ZhuHengg/ChampionCHIP-Multicycle-Processor-Architecture/Stage 3 ChampionCHIP eXperience_compressed.pdf

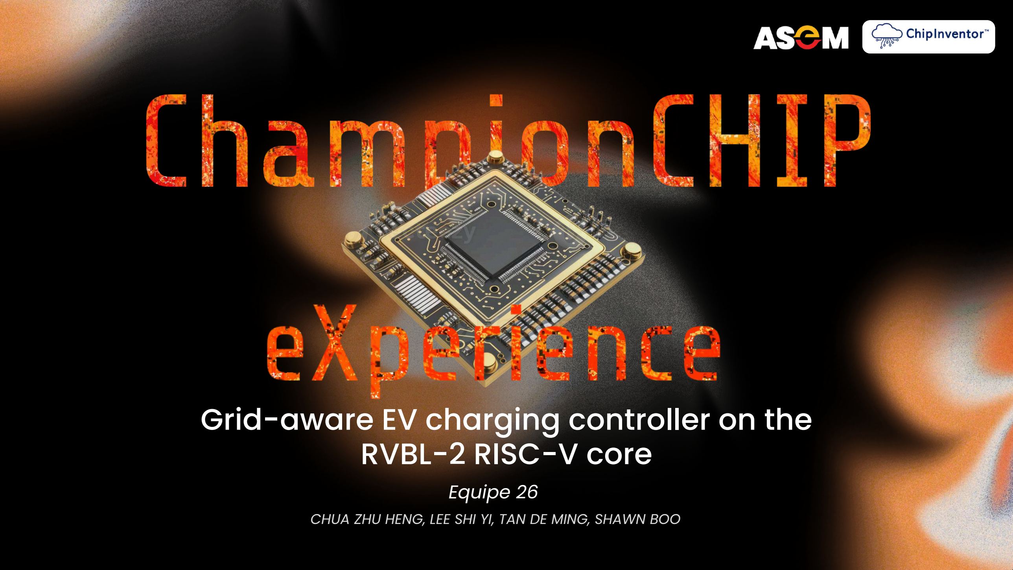
[picture p1: page 1]

# Grid-aware EV charging controller on the RVBL-2 RISC-V core

# Equipe 26

## CHUA ZHU HENG, LEE SHI YI, TAN DE MING, SHAWN BOO

# PROJECT ARCHITECTURE

# 01 · Technical

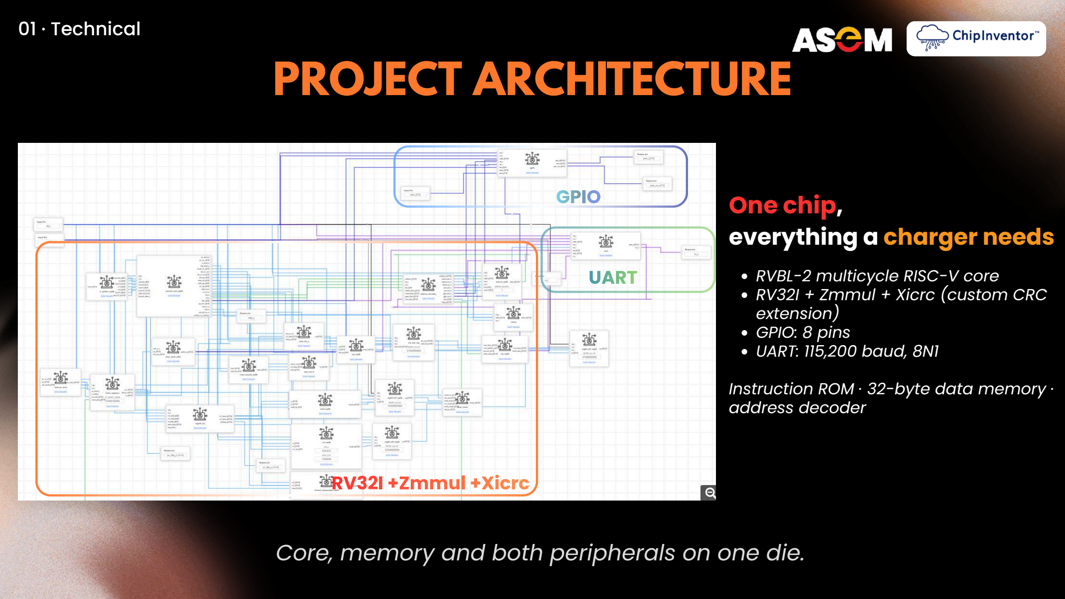
[picture p2: page 2]

## RVBL-2 multicycle RISC-V core RV32I + Zmmul + Xicrc (custom CRC extension) GPIO: 8 pins UART: 115,200 baud, 8N1

## Instruction ROM · 32-byte data memory · address decoder

Core, memory and both peripherals on one die.

One chip,

# everything a charger needs

# GPIO

# UART

# RV32I +Zmmul +Xicrc

# PROJECT ARCHITECTURE

# 01 · Technical

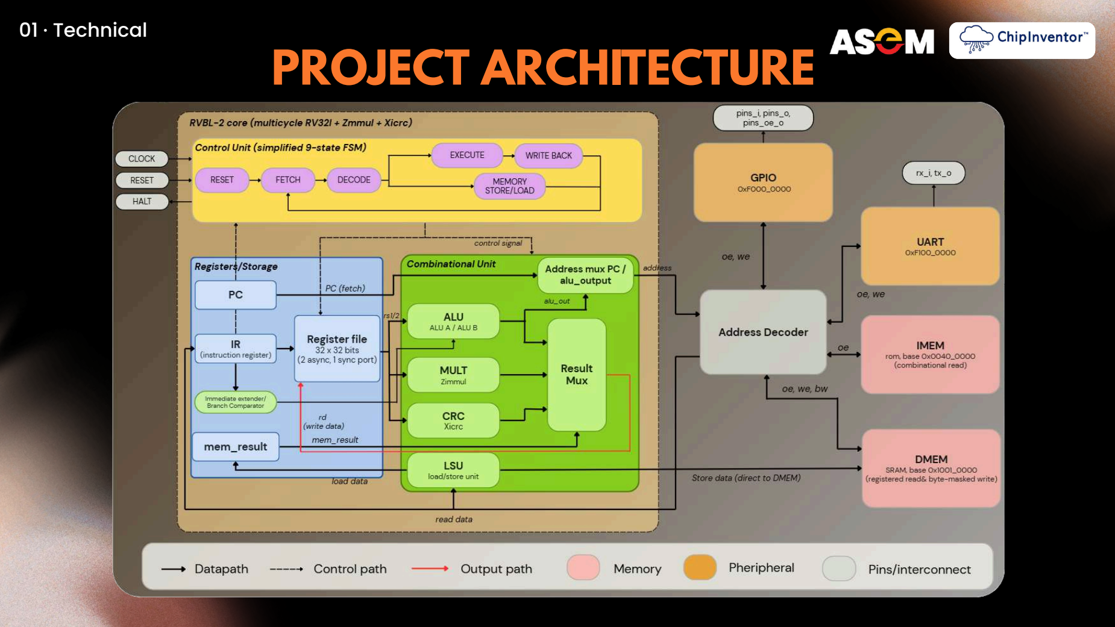
[picture p3: page 3]

# ASEM

## Our chip

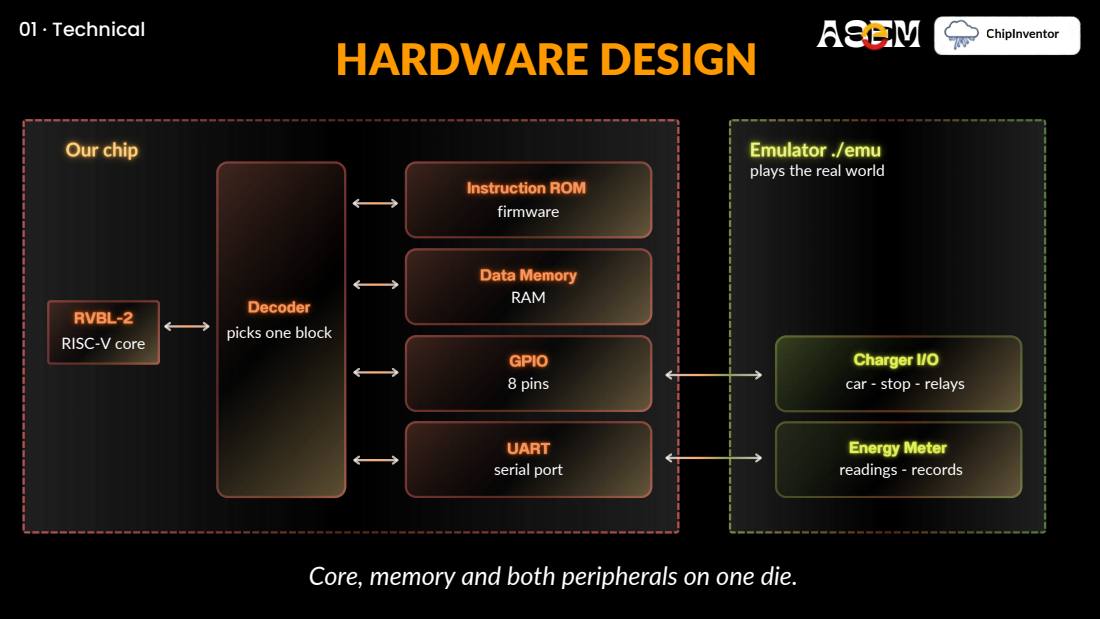
[picture p4: page 4]
RVBL-2; RISC-V core; HARDWARE DESIGN; ChipInventor; Instruction ROM; Data Memory; GPIO; UART; firmware; RAM; 8 pins; serial port; Energy Meter readings - records; 01 · Technical

Emulator ./emu
plays the real world

Decoder
picks one block

Charger I/O
car - stop - relays

Core, memory and both peripherals on one die.

# FIRMWARE IMPLEMENTATION

# 01 · Technical

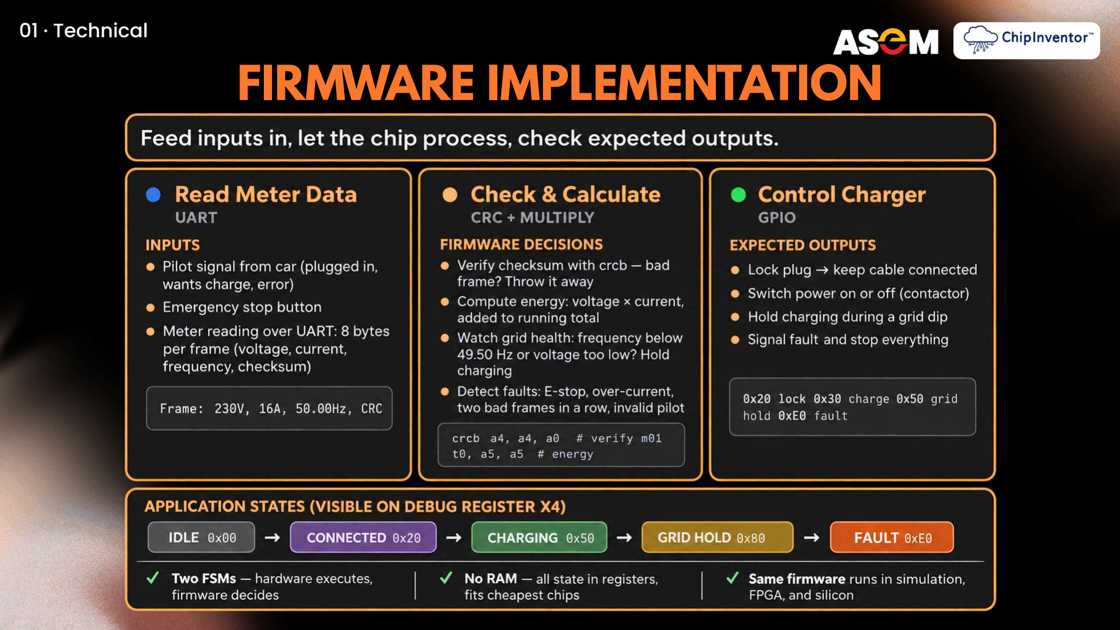
[picture p5: page 5]

# OFFICIAL FIRMWARE TESTBENCH

# 01 · Technical

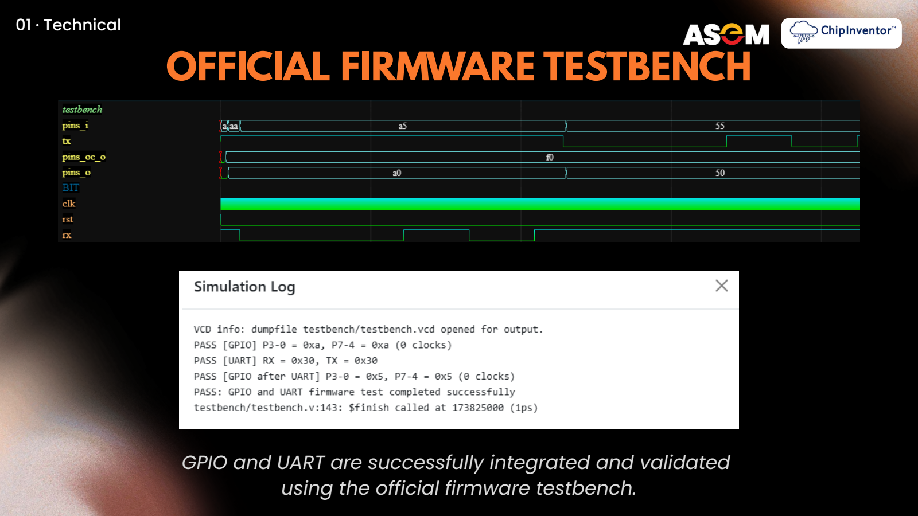
[picture p6: page 6]

# GPIO and UART are successfully integrated and validated

using the official firmware testbench.

# PROBLEM STATEMENT

1.Dip | 2.Recover | 3.Rebound

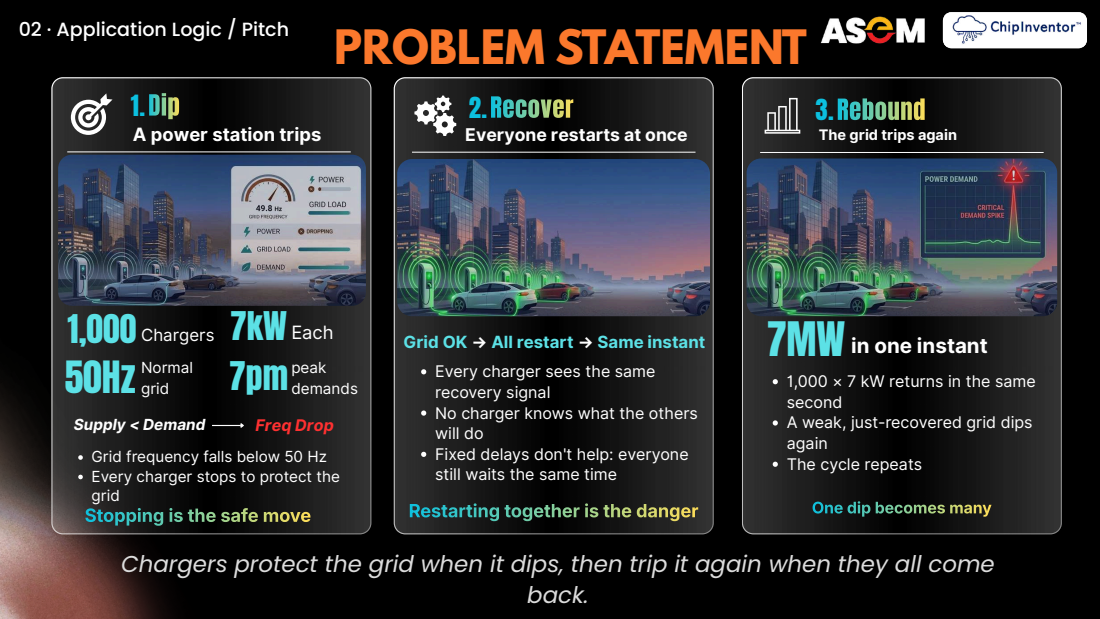
[picture p7: page 7]
Chargers; Everyone restarts at once; The grid trips again; 7kWEach; Normal; grid; peak demands; Stopping is the safe move; Restarting together is the danger; One dip becomes many; Freq Drop; back.

02 · Application Logic / Pitch

A power station trips

Grid OK → All restart → Same instant
Every charger sees the same
recovery signal
No charger knows what the others
will do
Fixed delays don't help: everyone
still waits the same time

in one instant

1,000 × 7 kW returns in the same
second
A weak, just-recovered grid dips
again
The cycle repeats

Supply < Demand
Grid frequency falls below 50 Hz
Every charger stops to protect the
grid
Chargers protect the grid when it dips, then trip it again when they all come

Every meter reading is CRC-checked and chained to the one before it. Corrupted, dropped and replayed readings are never billed.

Our custom instruction crcb checks each reading, chains readings together, and computes the restart delay. 21× faster than doing CRC in software.

## One instruction, three jobs

Each charger restarts at its own moment, computed from its ID and the grid event. Different chargers get different delays, so 1000 restart spread across 8 time slots instead of one instant.

## Staggered restart

The delay is calculated on the chip, from data every charger already has. It keeps working when communications fail, which is often during the same grid event.

## No network, no clock, no random numbers

# PROPOSED SOLUTION

## Integrity-checked metering

# Gripple

RVBL-2 RISC-V core + custom crcb instruction

# 02 · Application Logic / Pitch

# CUSTOM INSTRUCTION (crcb)

## Cycles to CRC one meter frame

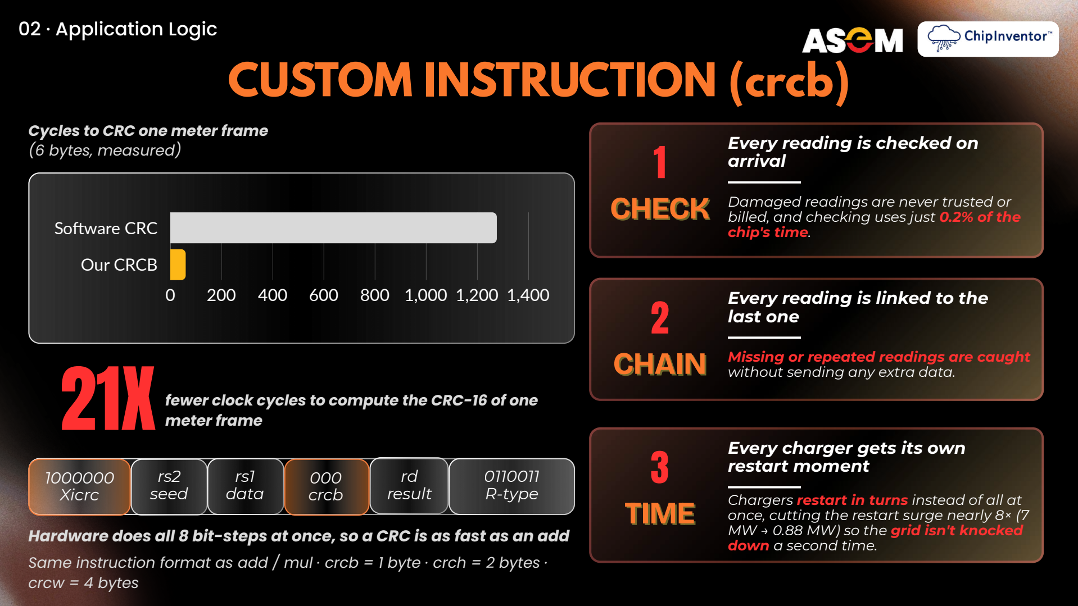
[picture p8: page 9]

0 200 400 600 800 1,000 1,200 1,400

## Software CRC

## Our CRCB

## (6 bytes, measured)

21X

## fewer clock cycles to compute the CRC-16 of one meter frame

Damaged readings are never trusted or billed, and checking uses just 0.2% of the chip's time.

# CHECK

1

## Every reading is checked on arrival

Missing or repeated readings are caught CHAIN without sending any extra data.

2

## Every reading is linked to the last one

Chargers restart in turns instead of all at once, cutting the restart surge nearly 8× (7 MW → 0.88 MW) so the grid isn't knocked down a second time.

# TIME

3

## Every charger gets its own restart moment

1000000

## Xicrc

rs2

## seed

rs1

## data

000

## crcb

rd

## result

0110011

## R-type

## Hardware does all 8 bit-steps at once, so a CRC is as fast as an add

## Same instruction format as add / mul · crcb = 1 byte · crch = 2 bytes · crcw = 4 bytes

# 02 · Application Logic

# How our chip controls a public AC EV charging station

# SYSTEM OVERVIEW

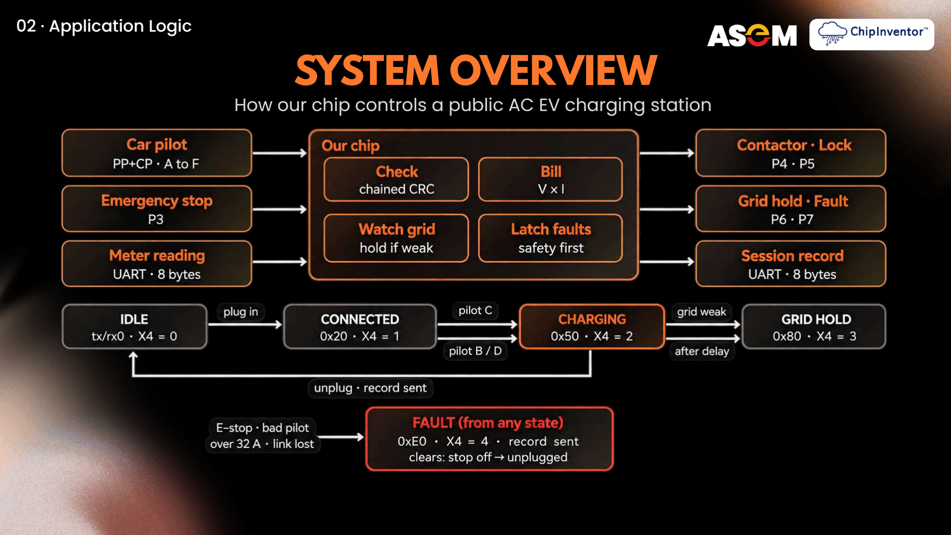
[picture p9: page 10]

# 02 · Application Logic

# APPLICATION LOGIC

# 02 · Application Logic

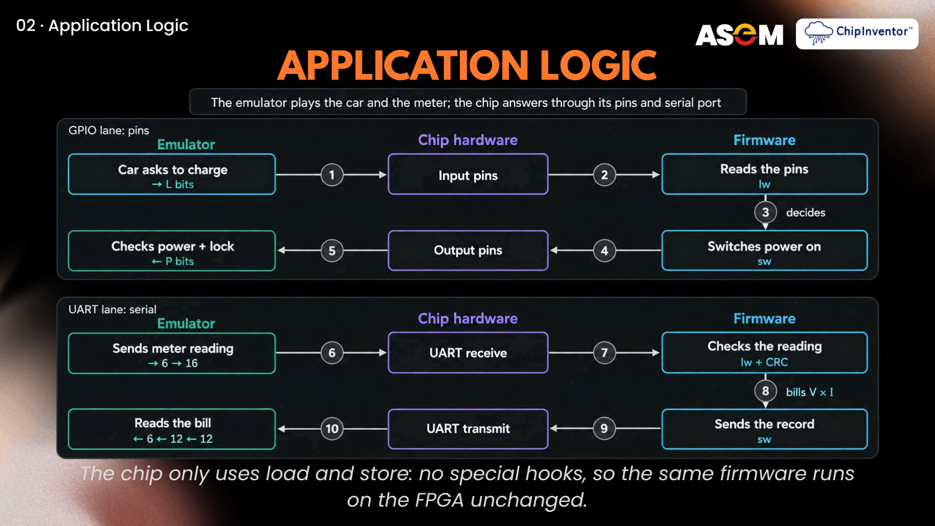
[picture p10: page 11]

# The chip only uses load and store: no special hooks, so the same firmware runs

on the FPGA unchanged.

E

M

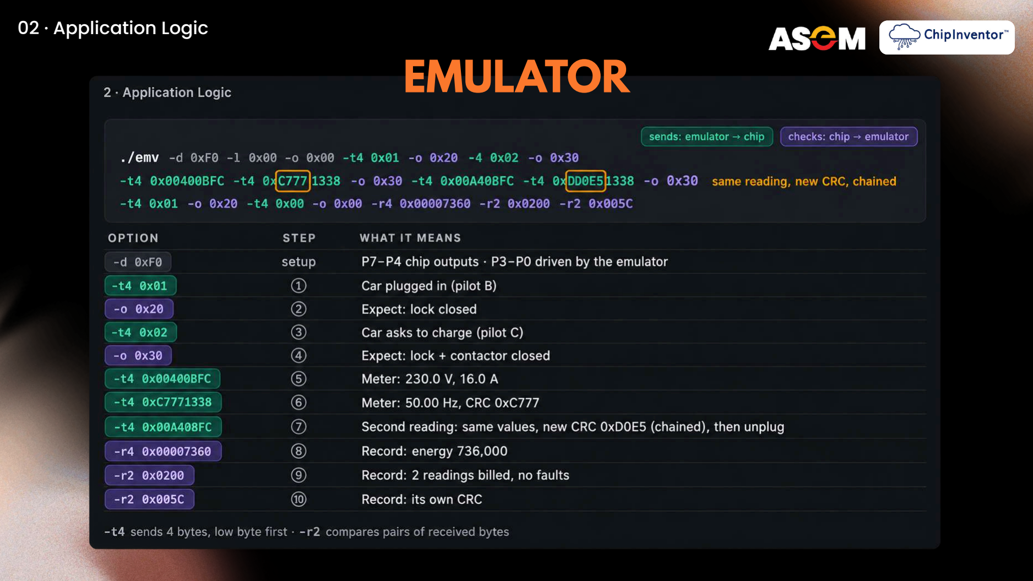
[picture p11: page 12]

U

L

# ATO

R

0

2

·

A

p

# pli

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
# DEMO 1: NORMAL CHARGING SESSION

# 02 · Application Logic

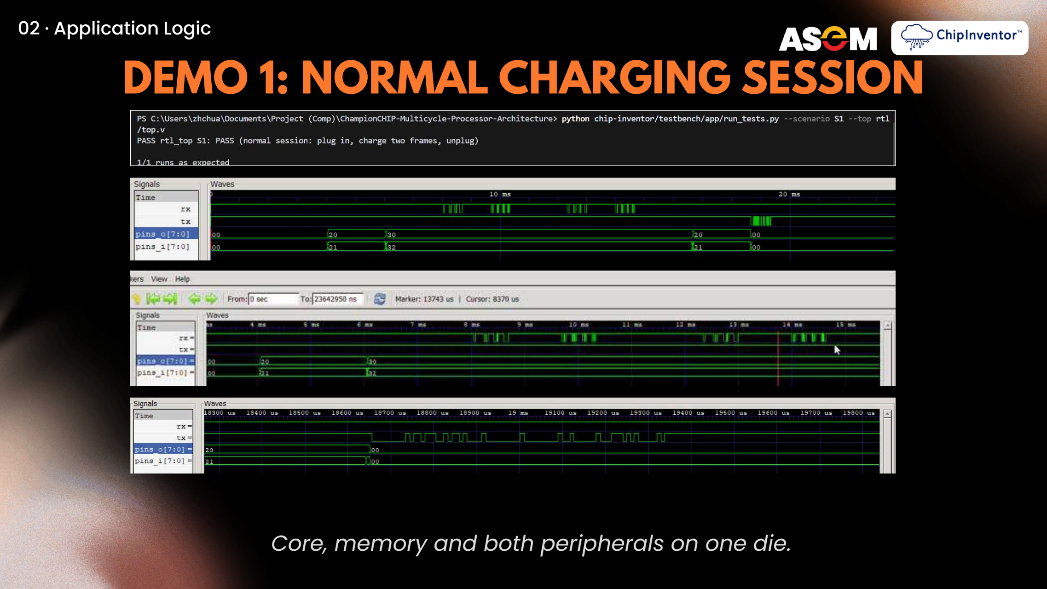
[picture p12: page 13]

Core, memory and both peripherals on one die.

# DEMO 2: GRID DIP & STAGGERED RESTART

# 02 · Application Logic

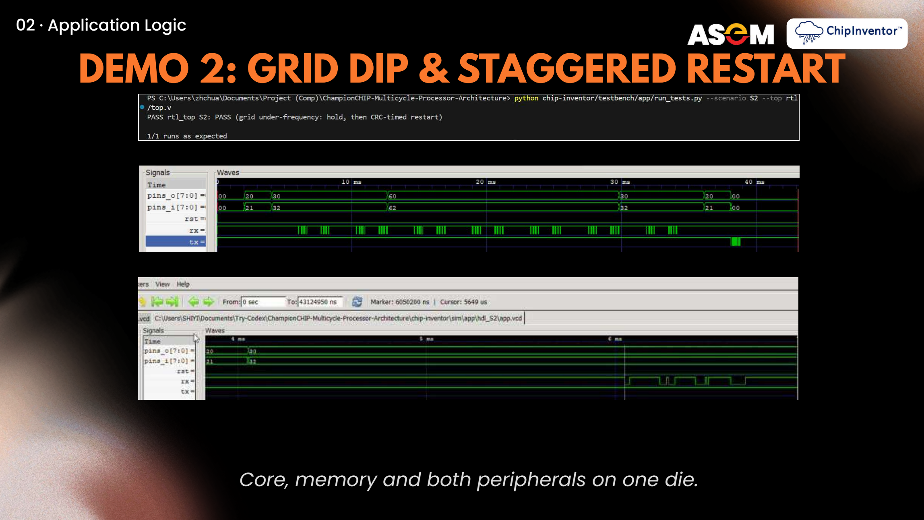
[picture p13: page 14]

Core, memory and both peripherals on one die.

# VALIDATION: APPLICATION TESTBENCH

45/45

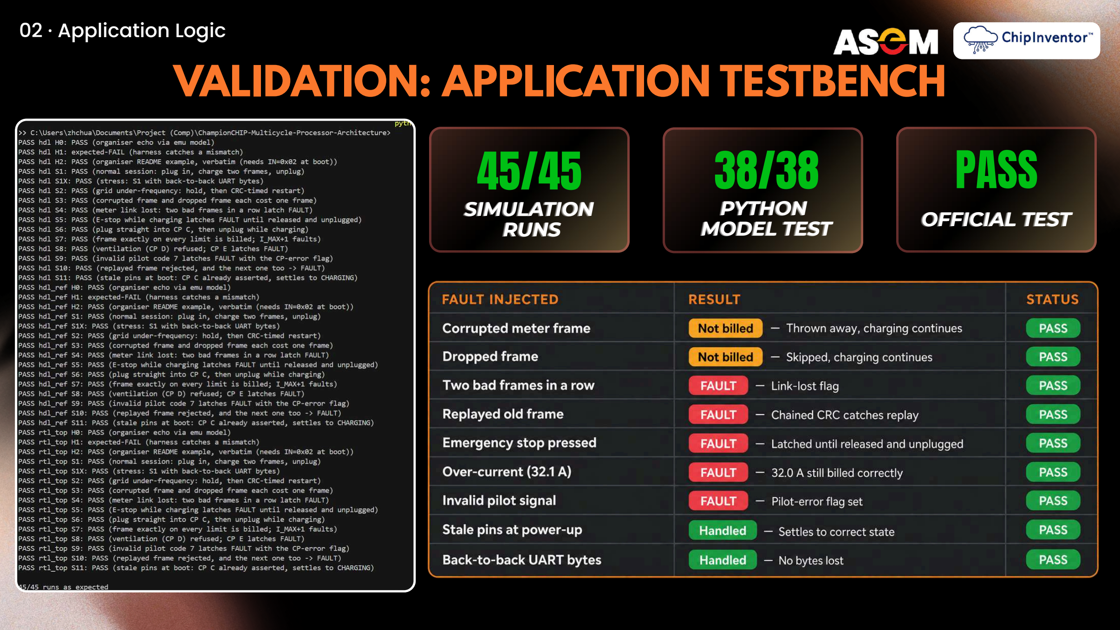
[picture p14: page 15]

## SSIIMMUULLAATTIIOONN RUNS

## SIMULATION RUNS

# PASS

## OFFICIAL TEST

## PYTHON MODEL TEST

## PYTHON MODEL TEST

38/38

# 02 · Application Logic

# COMPETITIVE ANALYSIS

# 03 · Pitch

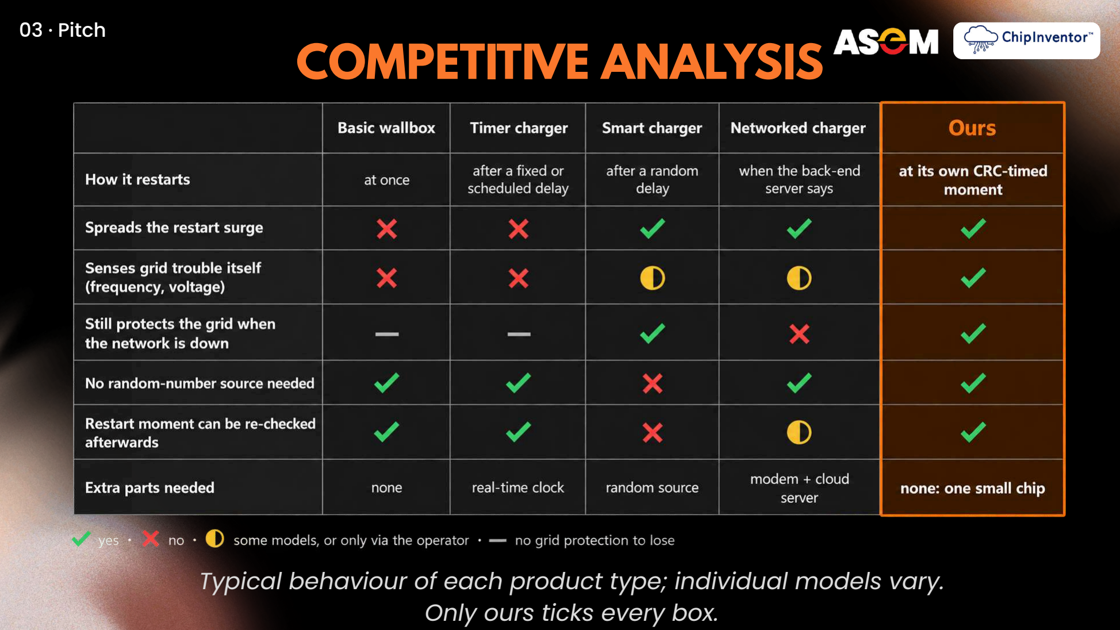
[picture p15: page 16]

Typical behaviour of each product type; individual models vary. Only ours ticks every box.

## smaller power

## 8x surges

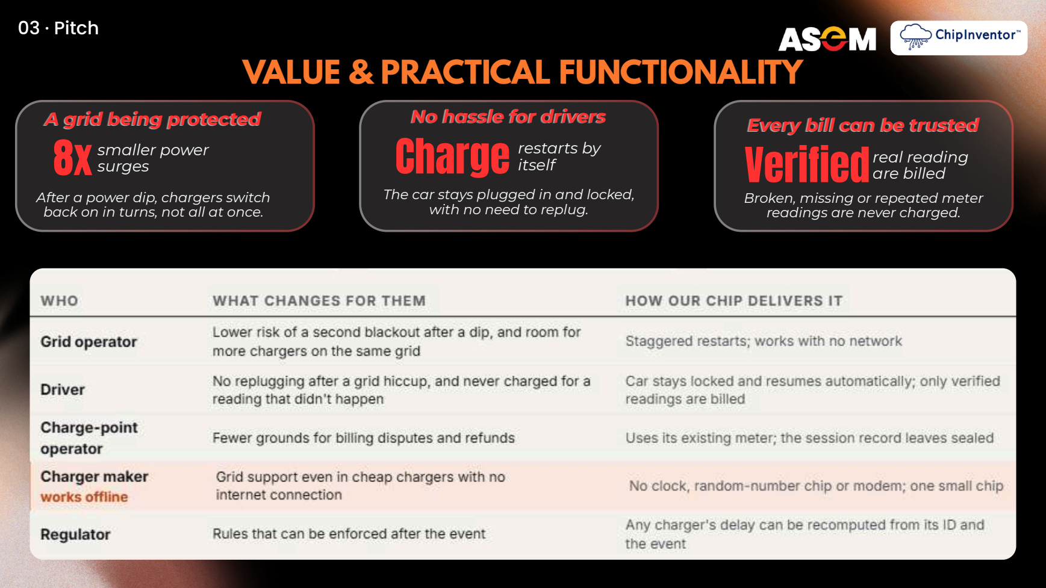
[picture p16: page 17]

## A grid being protected

After a power dip, chargers switch back on in turns, not all at once.

## restarts by

# Charge itself

## No hassle for drivers

The car stays plugged in and locked, with no need to replug.

## real reading

## Verified are billed

## Every bill can be trusted

Broken, missing or repeated meter readings are never charged.

# VALUE & PRACTICAL FUNCTIONALITY

# 03 · Pitch

# STAGE 4 FPGA ROADMAP

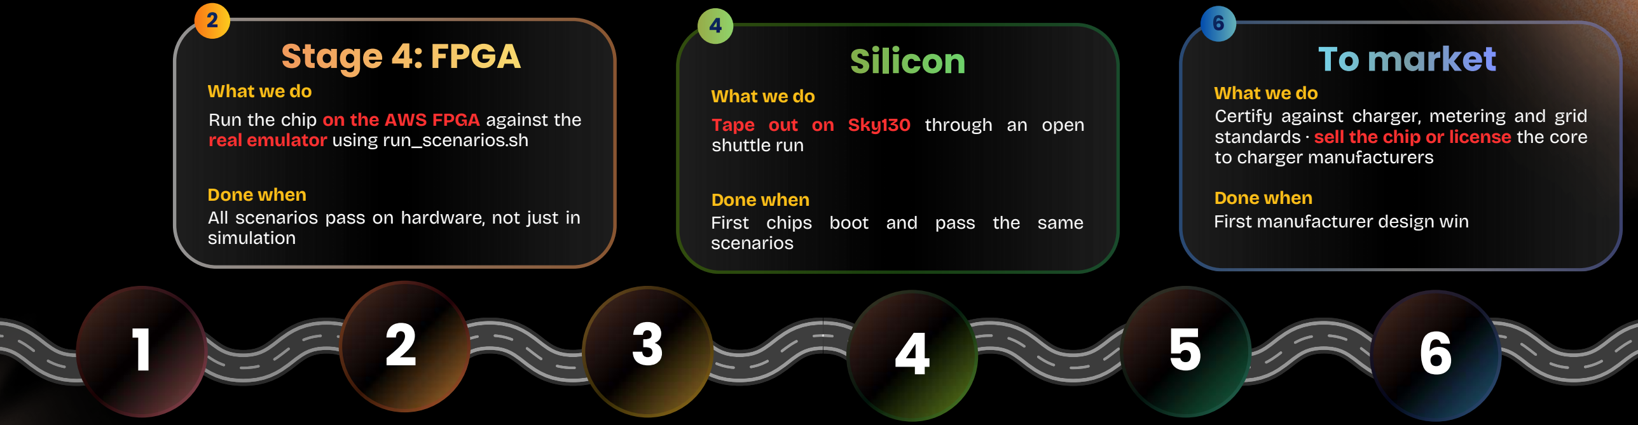
[picture p17: figure]
Stage 4: FPGA; What we do; real emulator using run_scenarios.sh; Done when; simulation; Silicon; What we do Tape out on Sky130 through an open shuttle run; Done when First chips boot and pass the same scenarios; To market; to charger manufacturers; Done when First manufacturer design win
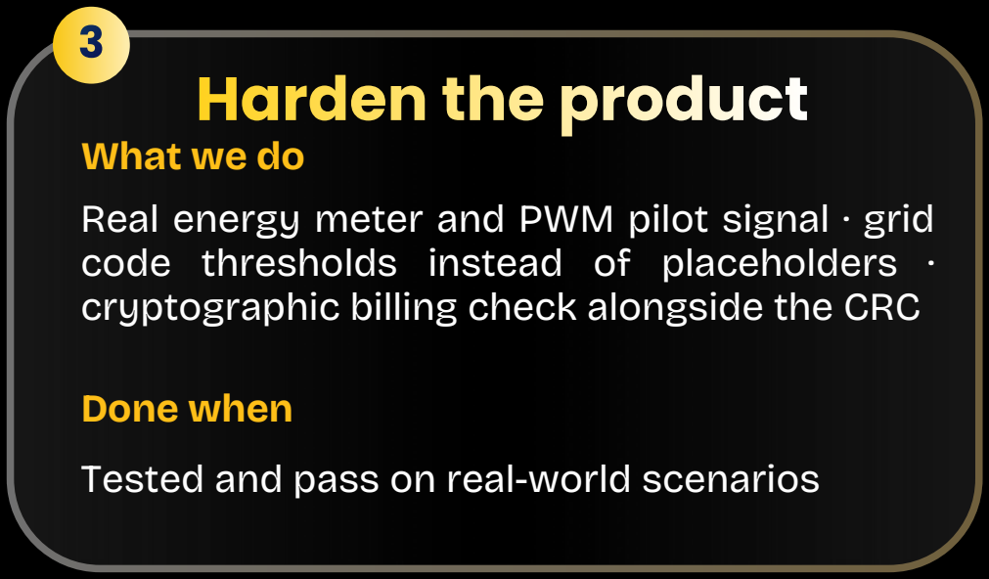
[picture p18: figure]
Harden the product; What we do; Done when Tested and pass on real-world scenarios
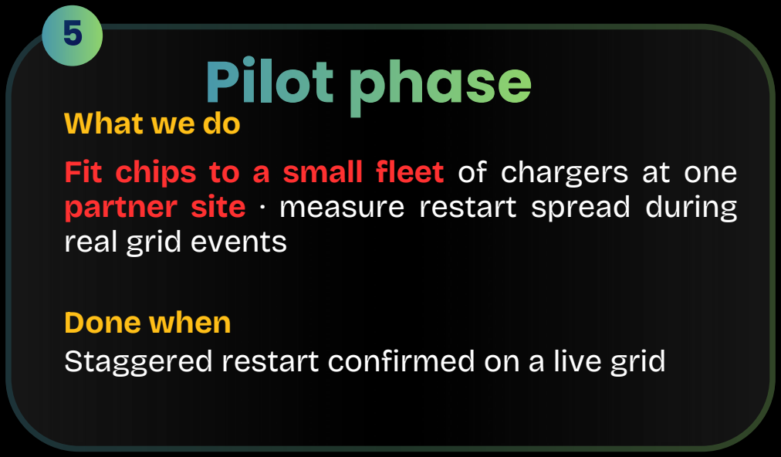
[picture p19: figure]
Pilot phase; What we do; real grid events; Done when

Core, memory and both peripherals on one die.

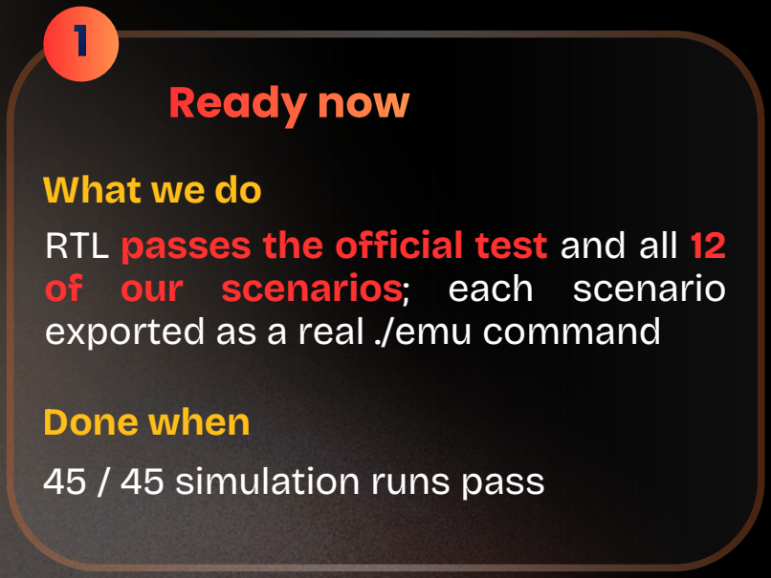
[picture p20: figure]
Ready now; What we do; RTL passes the official test and all 12 of our scenarios; each scenario exported as a real ./emu command; Done when 45 / 45 simulation runs pass

Real energy meter and PWM pilot signal · grid code thresholds instead of placeholders · cryptographic billing check alongside the CRC

Run the chip on the AWS FPGA against the

All scenarios pass on hardware, not just in

Fit chips to a small fleet of chargers at one partner site · measure restart spread during

Staggered restart confirmed on a live grid

Certify against charger, metering and grid standards · sell the chip or license the core

# 03 · Pitch

# Equipe 26

One CRC instruction.

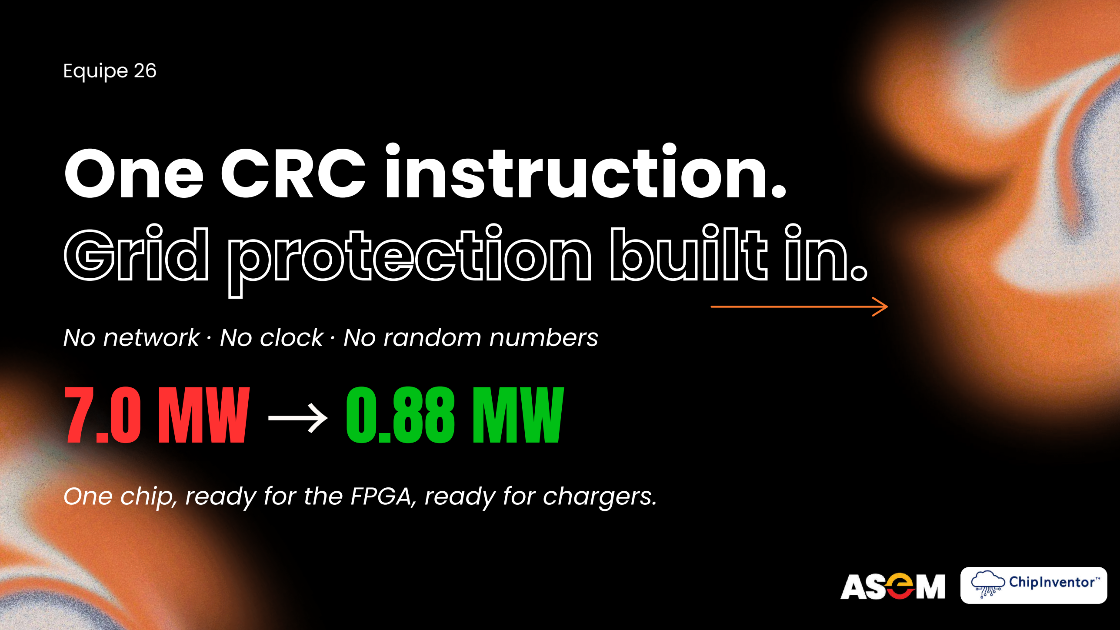
[picture p21: page 19]

# No network · No clock · No random numbers

Grid protection built in.

# 7.0 MW → 0.88 MW

One chip, ready for the FPGA, ready for chargers.
