ZhuHengg/ChampionCHIP-Multicycle-Processor-Architecture/chip-inventor/frontend/design-system/championchip-ev-charger/MASTER.md

# Design System Master File

> **LOGIC:** When building a specific page, first check `design-system/pages/[page-name].md`.
> If that file exists, its rules **override** this Master file.
> If not, strictly follow the rules below.

---

**Project:** ChampionCHIP EV Charger
**Generated:** 2026-10-07 09:20:07
**Category:** Smart Home/IoT Dashboard
**Design Dials:** Variance 7/10 (Balanced / Modern) | Motion 7/10 (Standard) | Density 7/10 (Standard)

---

## Global Rules

### Color Palette

| Role | Hex | CSS Variable |
|---|-----|---|
| Primary | `#1E293B` | `--color-primary` |
| On Primary | `#FFFFFF` | `--color-on-primary` |
| Secondary | `#334155` | `--color-secondary` |
| On Secondary | `#FFFFFF` | `--color-on-secondary` |
| Accent/CTA | `#22C55E` | `--color-accent` |
| On Accent/CTA | `#0F172A` | `--color-on-accent` |
| Background | `#0F172A` | `--color-background` |
| Foreground | `#F8FAFC` | `--color-foreground` |
| Card | `#1B2336` | `--color-card` |
| Card Foreground | `#F8FAFC` | `--color-card-foreground` |
| Muted | `#272F42` | `--color-muted` |
| Muted Foreground | `#94A3B8` | `--color-muted-foreground` |
| Border | `#475569` | `--color-border` |
| Destructive | `#EF4444` | `--color-destructive` |
| On Destructive | `#000000` | `--color-on-destructive` |
| Ring | `#FFFFFF` | `--color-ring` |

**Color Notes:** Dark tech + status green

### Typography

- **Heading Font:** Fira Code
- **Body Font:** Fira Sans
- **Mood:** dashboard, data, analytics, code, technical, precise
- **Google Fonts:** [Fira Code + Fira Sans](https://fonts.googleapis.com/css2?family=Fira+Code:wght@400;500;600;700&family=Fira+Sans:wght@300;400;500;600;700&display=swap)

**CSS Import:**
```css
@import url('https://fonts.googleapis.com/css2?family=Fira+Code:wght@400;500;600;700&family=Fira+Sans:wght@300;400;500;600;700&display=swap');
```

### Spacing Variables

*Density: 7/10 — Standard*

| Token | Value | Usage |
|---|---|---|
| `--space-xs` | `4px` / `0.25rem` | Tight gaps |
| `--space-sm` | `8px` / `0.5rem` | Icon gaps, inline spacing |
| `--space-md` | `16px` / `1rem` | Standard padding |
| `--space-lg` | `24px` / `1.5rem` | Section padding |
| `--space-xl` | `32px` / `2rem` | Large gaps |
| `--space-2xl` | `48px` / `3rem` | Section margins |
| `--space-3xl` | `64px` / `4rem` | Hero padding |

### Shadow Depths

| Level | Value | Usage |
|---|---|---|
| `--shadow-sm` | `0 1px 2px rgba(0,0,0,0.05)` | Subtle lift |
| `--shadow-md` | `0 4px 6px rgba(0,0,0,0.1)` | Cards, buttons |
| `--shadow-lg` | `0 10px 15px rgba(0,0,0,0.1)` | Modals, dropdowns |
| `--shadow-xl` | `0 20px 25px rgba(0,0,0,0.15)` | Hero images, featured cards |

---

## Component Specs

### Buttons

```css
/* Primary Button */
.btn-primary {
  background: #22C55E;
  color: white;
  padding: 12px 24px;
  border-radius: 8px;
  font-weight: 600;
  transition: all 200ms ease;
  cursor: pointer;
}

.btn-primary:hover {
  opacity: 0.9;
  transform: translateY(-1px);
}

/* Secondary Button */
.btn-secondary {
  background: transparent;
  color: #1E293B;
  border: 2px solid #1E293B;
  padding: 12px 24px;
  border-radius: 8px;
  font-weight: 600;
  transition: all 200ms ease;
  cursor: pointer;
}
```

### Cards

```css
.card {
  background: #0F172A;
  border-radius: 12px;
  padding: 24px;
  box-shadow: var(--shadow-md);
  transition: all 200ms ease;
  cursor: pointer;
}

.card:hover {
  box-shadow: var(--shadow-lg);
  transform: translateY(-2px);
}
```

### Inputs

```css
.input {
  padding: 12px 16px;
  border: 1px solid #E2E8F0;
  border-radius: 8px;
  font-size: 16px;
  transition: border-color 200ms ease;
}

.input:focus {
  border-color: #1E293B;
  outline: none;
  box-shadow: 0 0 0 3px #1E293B20;
}
```

### Modals

```css
.modal-overlay {
  background: rgba(0, 0, 0, 0.5);
  backdrop-filter: blur(4px);
}

.modal {
  background: white;
  border-radius: 16px;
  padding: 32px;
  box-shadow: var(--shadow-xl);
  max-width: 500px;
  width: 90%;
}
```

---

## Style Guidelines

**Style:** Glassmorphism

**Keywords:** Frosted glass, transparent, blurred background, layered, vibrant background, light source, depth, multi-layer

**Best For:** Modern SaaS, financial dashboards, high-end corporate, lifestyle apps, modal overlays, navigation

**Key Effects:** Backdrop blur (10-20px), subtle border (1px solid rgba white 0.2), light reflection, Z-depth

### Page Pattern

**Pattern Name:** Real-Time / Operations Landing

- **Conversion Strategy:** Offer a demo or sandbox and show trust signals. Label telemetry as live only when backed by a current source, with update time and stale state. Provide pause/hide or update-frequency controls for tickers and previews, stop offscreen/hidden work, support keyboard controls, and render a static final snapshot under reduced motion.
- **CTA Placement:** Primary CTA in nav + After metrics
- **Section Order:** Hero (product + live preview or status) > Key metrics/indicators > How it works > CTA (Start trial / Contact)

---

## Motion

**Stagger List** (Standard) — Trigger: load or scroll | Duration: 300-450ms | Easing: `back.out(1.4)`

```js
gsap.from('.grid-item', { opacity: 0, scale: 0.92, y: 16, duration: 0.4, stagger: { each: 0.06, from: 'start', grid: 'auto' }, ease: 'back.out(1.4)' });
```

**Framework notes:** grid: 'auto' lets GSAP infer rows/columns from a CSS grid layout for a natural wave stagger; Use matchMedia('(prefers-reduced-motion: reduce)') to skip non-essential motion and render the final state immediately

- ✅ Combine with from: 'center' for a bento-grid layout to draw the eye inward first
- ❌ Don't use back.out on dense data tables; the overshoot reads as sloppy on informational UI
- ⚡ Group DOM writes; avoid interleaving layout reads (getBoundingClientRect) between staggered tweens

---

## Anti-Patterns (Do NOT Use)

- ❌ Slow updates
- ❌ No automation

### Additional Forbidden Patterns

- ❌ **Emojis as icons** — Use SVG icons (Heroicons, Lucide, Simple Icons)
- ❌ **Missing cursor:pointer** — All clickable elements must have cursor:pointer
- ❌ **Layout-shifting hovers** — Avoid scale transforms that shift layout
- ❌ **Low contrast text** — Maintain 4.5:1 minimum contrast ratio
- ❌ **Instant state changes** — Always use transitions (150-300ms)
- ❌ **Invisible focus states** — Focus states must be visible for a11y

---

## Pre-Delivery Checklist

Before delivering any UI code, verify:

- [ ] No emojis used as icons (use SVG instead)
- [ ] All icons from consistent icon set (Heroicons/Lucide)
- [ ] `cursor-pointer` on all clickable elements
- [ ] Hover states with smooth transitions (150-300ms)
- [ ] Light mode: text contrast 4.5:1 minimum
- [ ] Focus states visible for keyboard navigation
- [ ] `prefers-reduced-motion` respected
- [ ] Responsive: 375px, 768px, 1024px, 1440px
- [ ] No content hidden behind fixed navbars
- [ ] No horizontal scroll on mobile
