ZhuHengg/ChampionCHIP-Multicycle-Processor-Architecture/legacy/tb/control_unit/README.md

# tb/control_unit/ — owned by Teammate A

tb_control_unit.v goes here. Assert state + every control signal against
HANDOFF_control_unit.md section 4, row by row, for a hardcoded instruction
— don't just eyeball the waveform.
