ZhuHengg/ChampionCHIP-Multicycle-Processor-Architecture/legacy/tb/datapath/README.md

# tb/datapath/ — owned by Teammate B

One testbench per module in rtl/datapath/: tb_alu.v, tb_mult.v, tb_crc.v,
tb_branch_comparator.v, tb_imm_extend.v.
