ZhuHengg/ChampionCHIP-Multicycle-Processor-Architecture/docs/figures/rebound.png

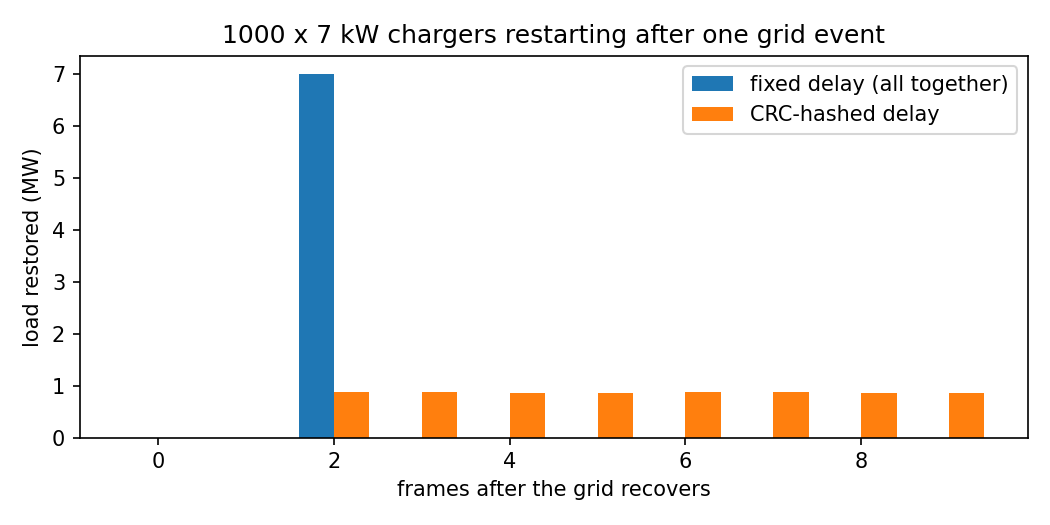
docs/figures/rebound.png
