ZhuHengg/ChampionCHIP-Multicycle-Processor-Architecture/docs/video/figures/gpio_pin_cell_dark.png

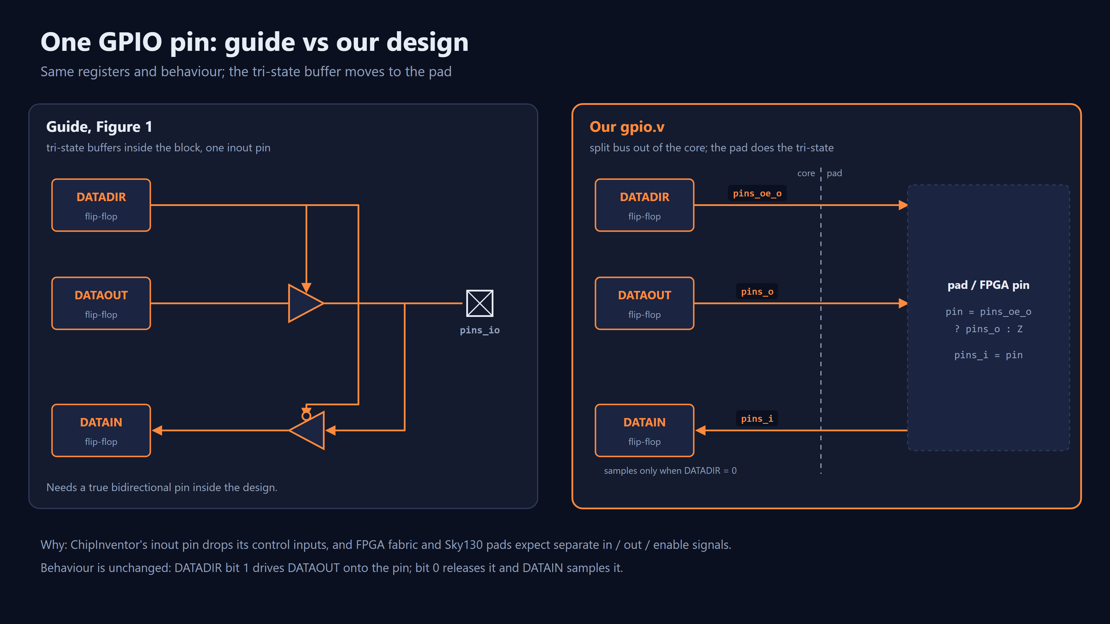
docs/video/figures/gpio_pin_cell_dark.png
