ZhuHengg/ChampionCHIP-Multicycle-Processor-Architecture/docs/video/figures/gpio_pin_cell_light.png

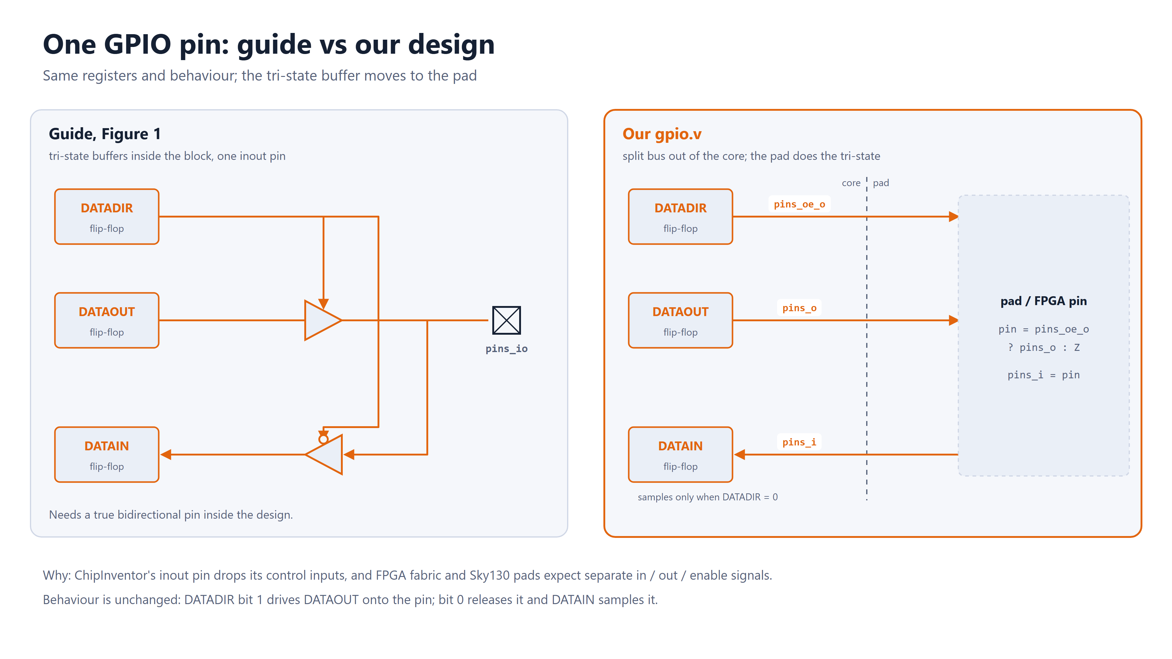
docs/video/figures/gpio_pin_cell_light.png
