ZhuHengg/ChampionCHIP-Multicycle-Processor-Architecture/docs/video/figures/gpio_uart_integration_dark.png

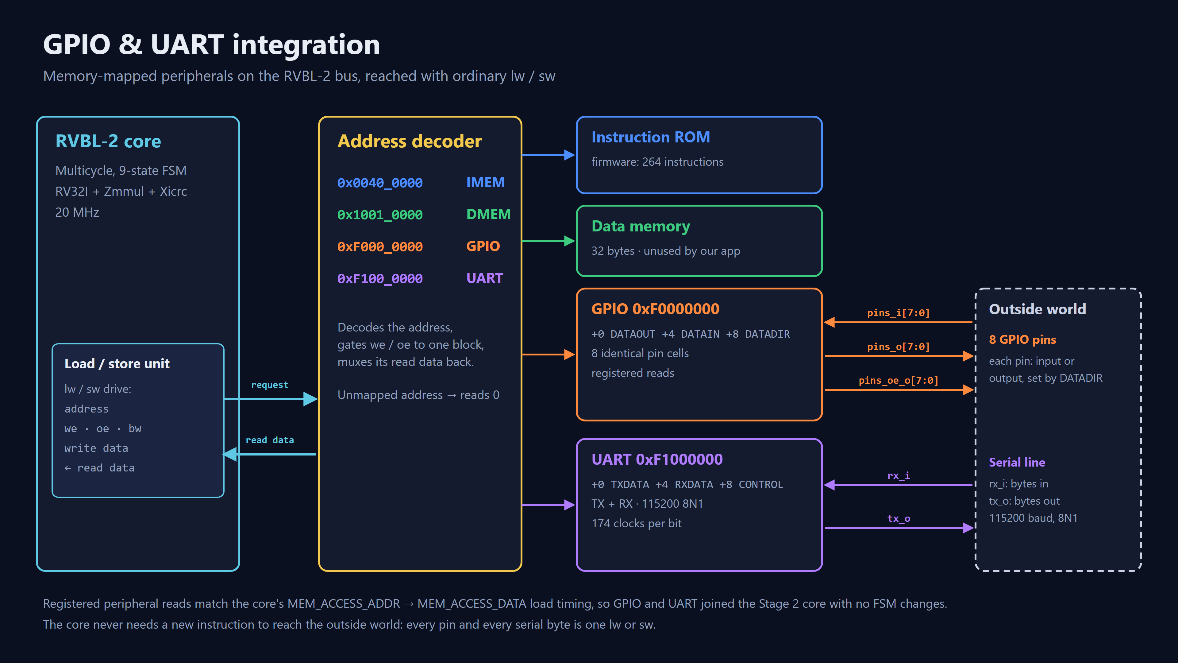
docs/video/figures/gpio_uart_integration_dark.png
