ZhuHengg/ChampionCHIP-Multicycle-Processor-Architecture/docs/video/figures/gpio_uart_integration_light.png

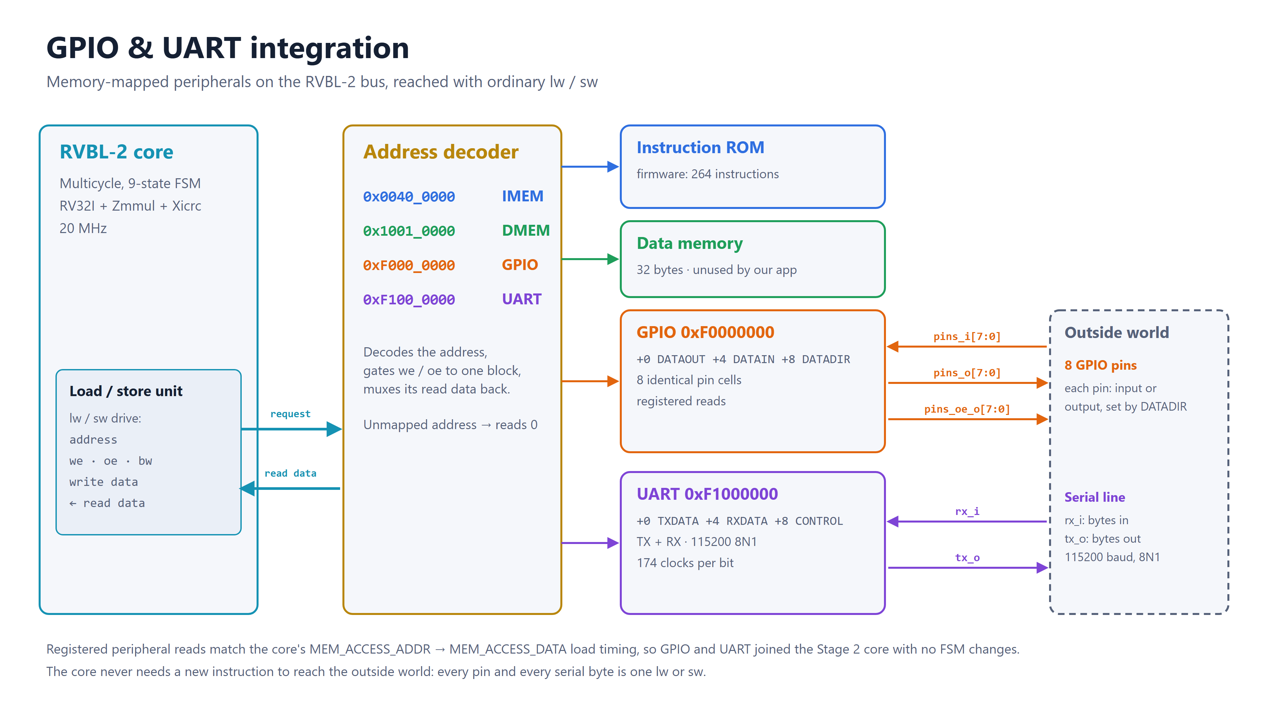
docs/video/figures/gpio_uart_integration_light.png
