ZhuHengg/ChampionCHIP-Multicycle-Processor-Architecture/docs/video/figures/gpio_uart_process_light.png

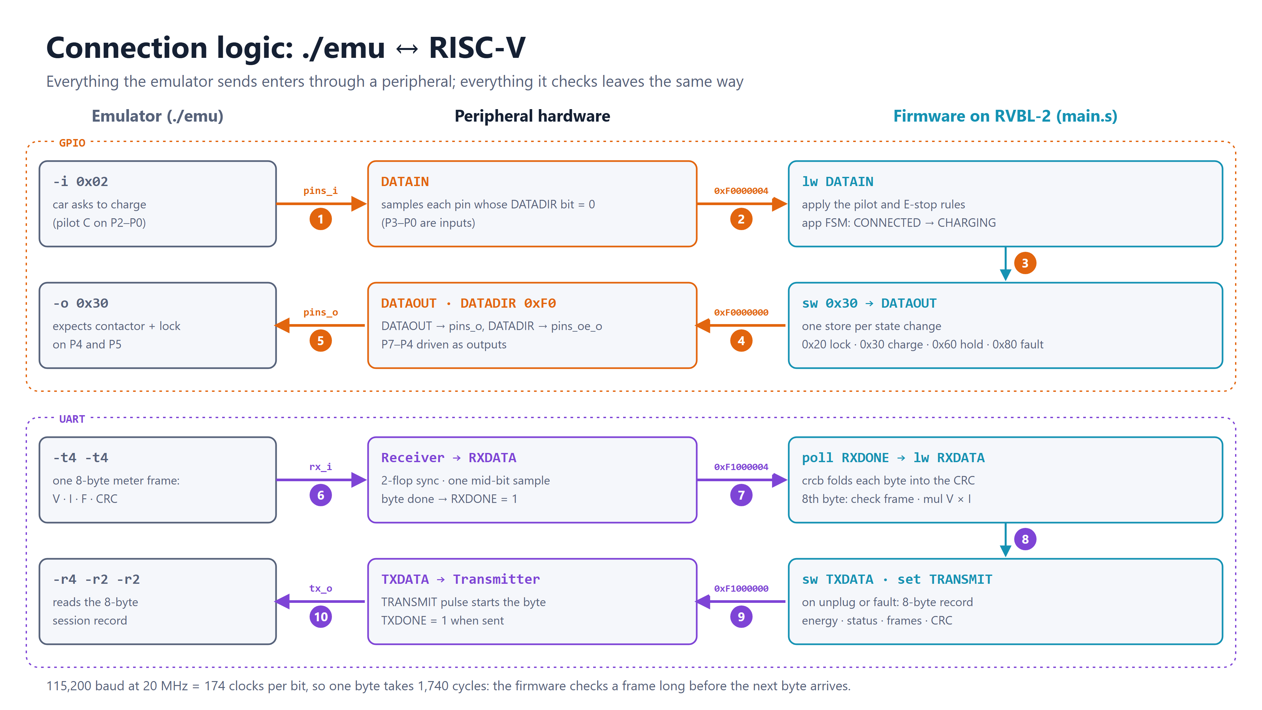
docs/video/figures/gpio_uart_process_light.png
