ZhuHengg/ChampionCHIP-Multicycle-Processor-Architecture/v2-chip-inventor-synth/publics/image.png

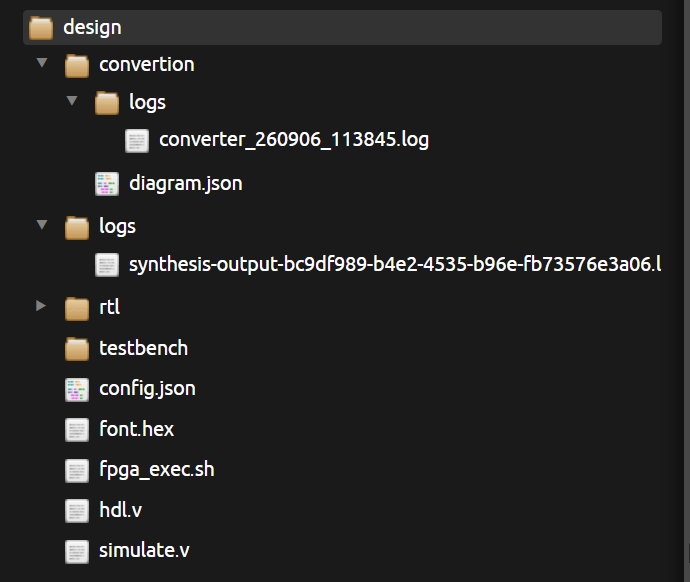
v2-chip-inventor-synth/publics/image.png
