ZhuHengg/ChampionCHIP-Multicycle-Processor-Architecture/docs/AWS Guide.pdf

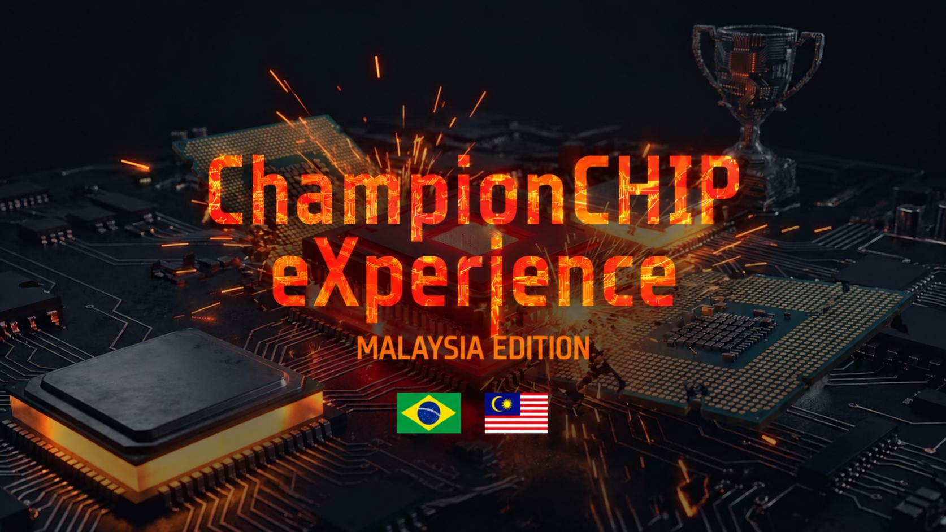
[picture p30: page 1]
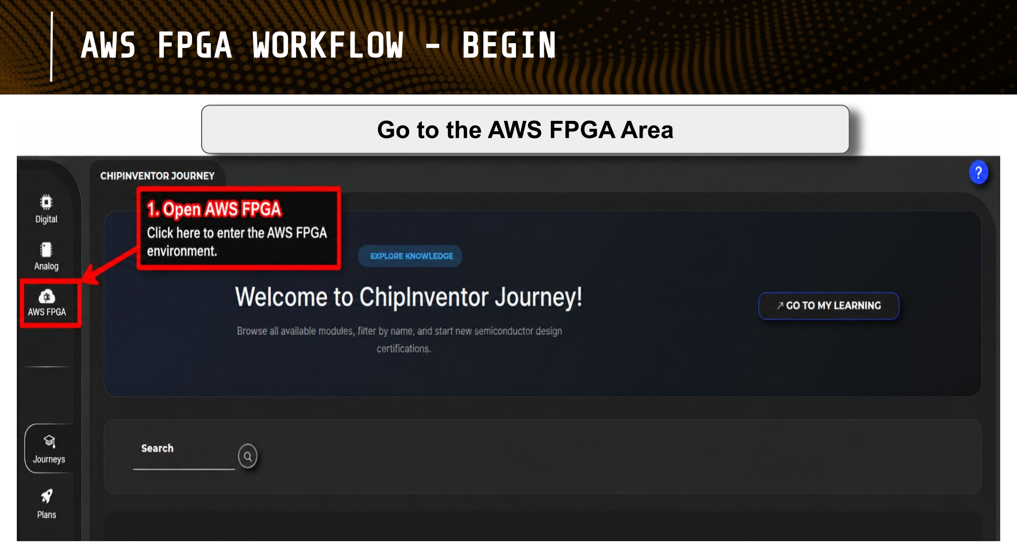
[picture p31: page 2]

AWS FPGA WORKFLOW - BEGIN

Go to the AWS FPGA Area

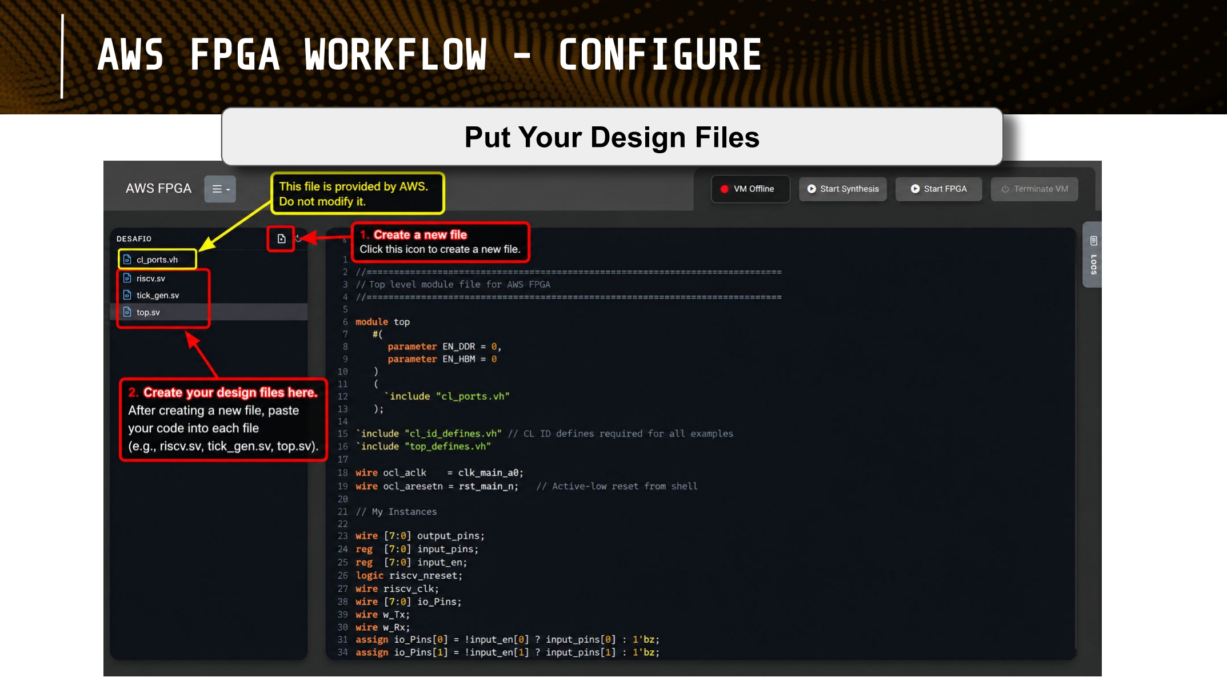
[picture p32: page 3]

AWS FPGA WORKFLOW - CONFIGURE

Put Your Design Files

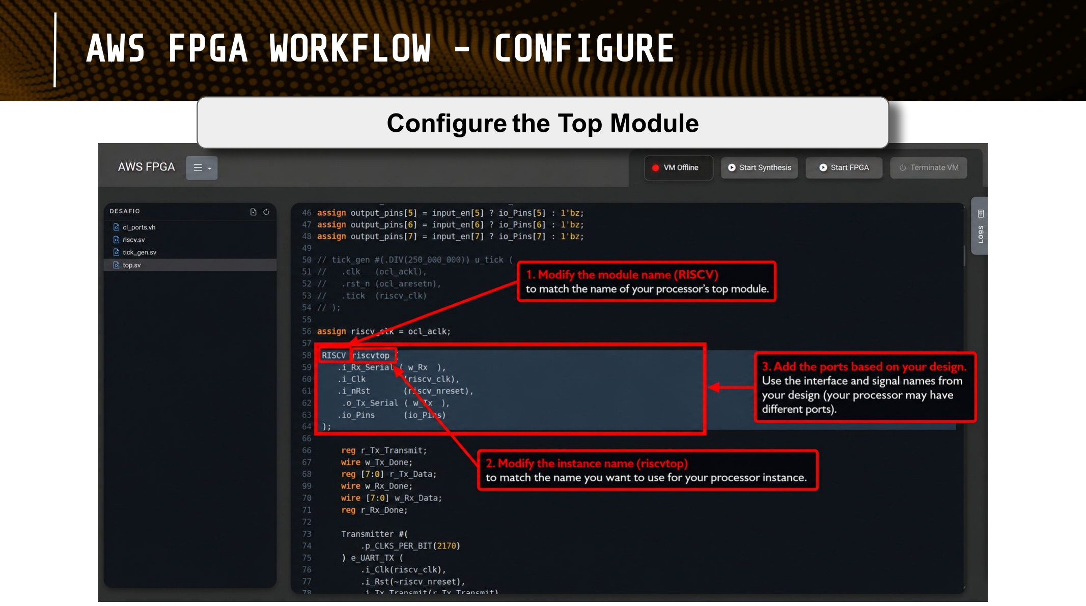
[picture p33: page 4]

AWS FPGA WORKFLOW - CONFIGURE

Configure the Top Module

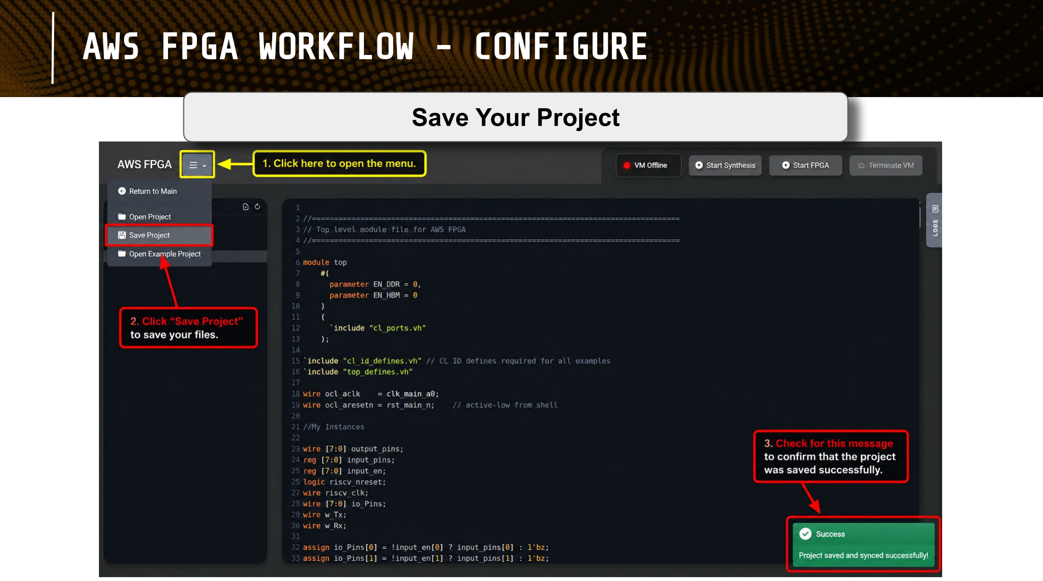
[picture p34: page 5]

AWS FPGA WORKFLOW - CONFIGURE

Save Your Project

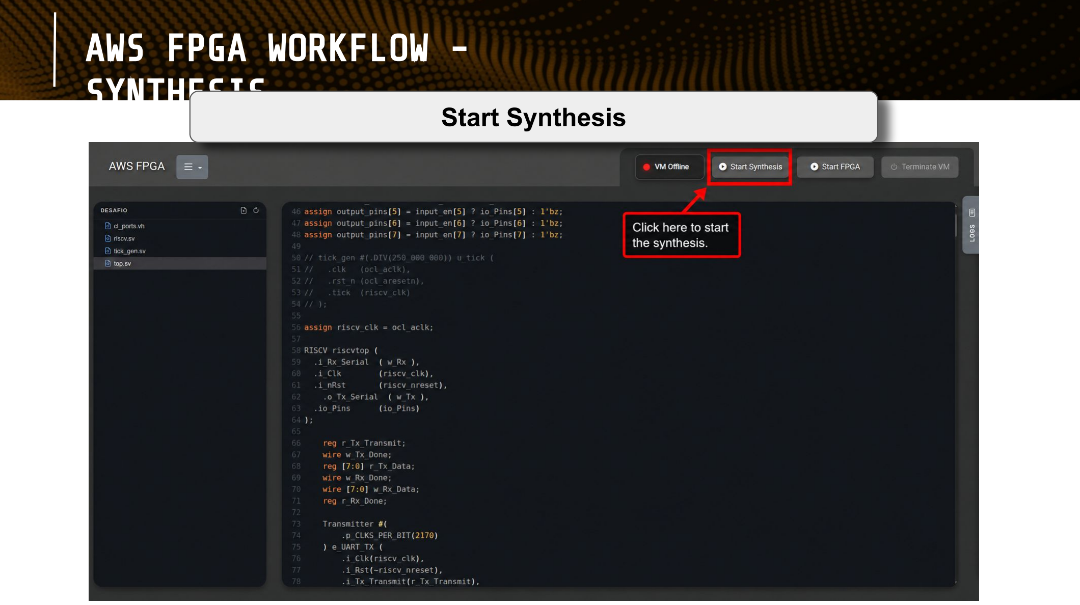
[picture p35: page 6]

AWS FPGA WORKFLOW -
SYNTHESIS
Start Synthesis

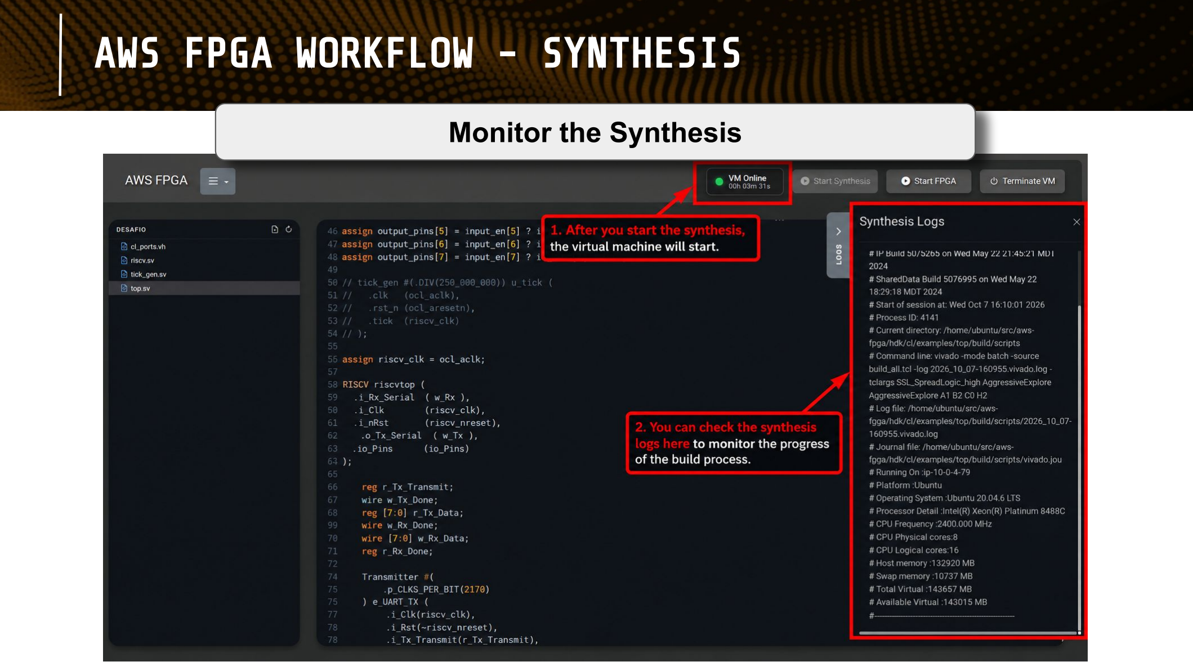
[picture p36: page 7]

AWS FPGA WORKFLOW - SYNTHESIS

Monitor the Synthesis

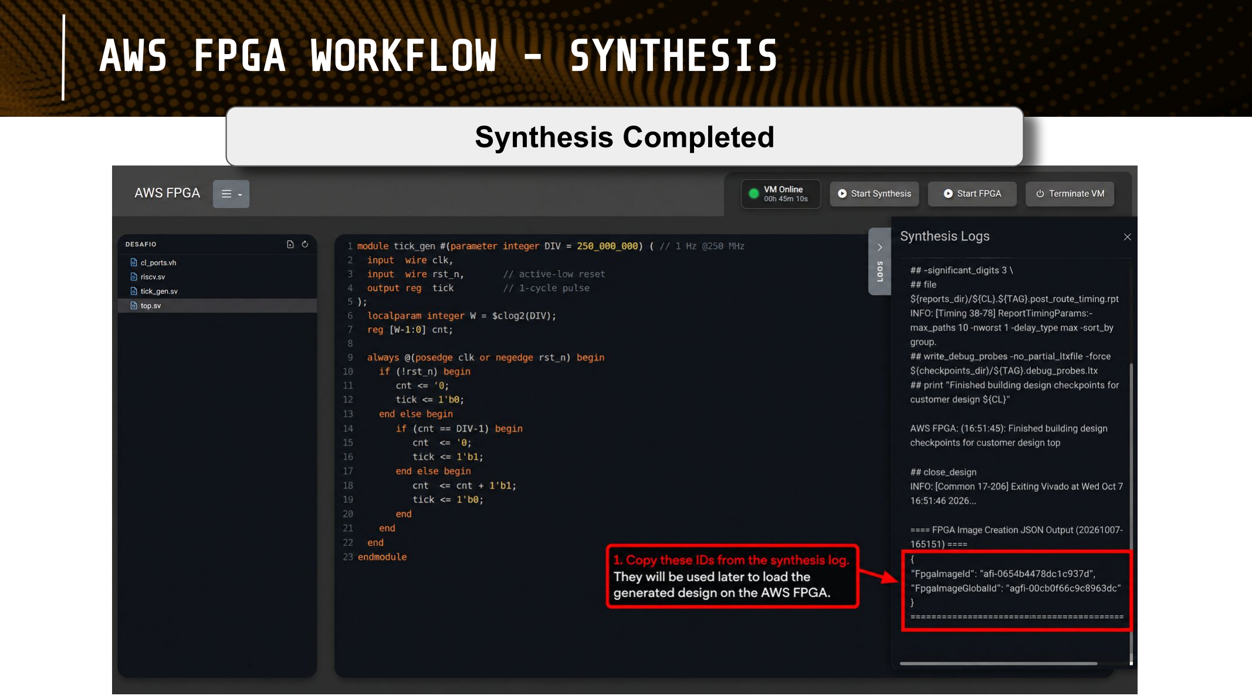
[picture p37: page 8]

AWS FPGA WORKFLOW - SYNTHESIS

Synthesis Completed

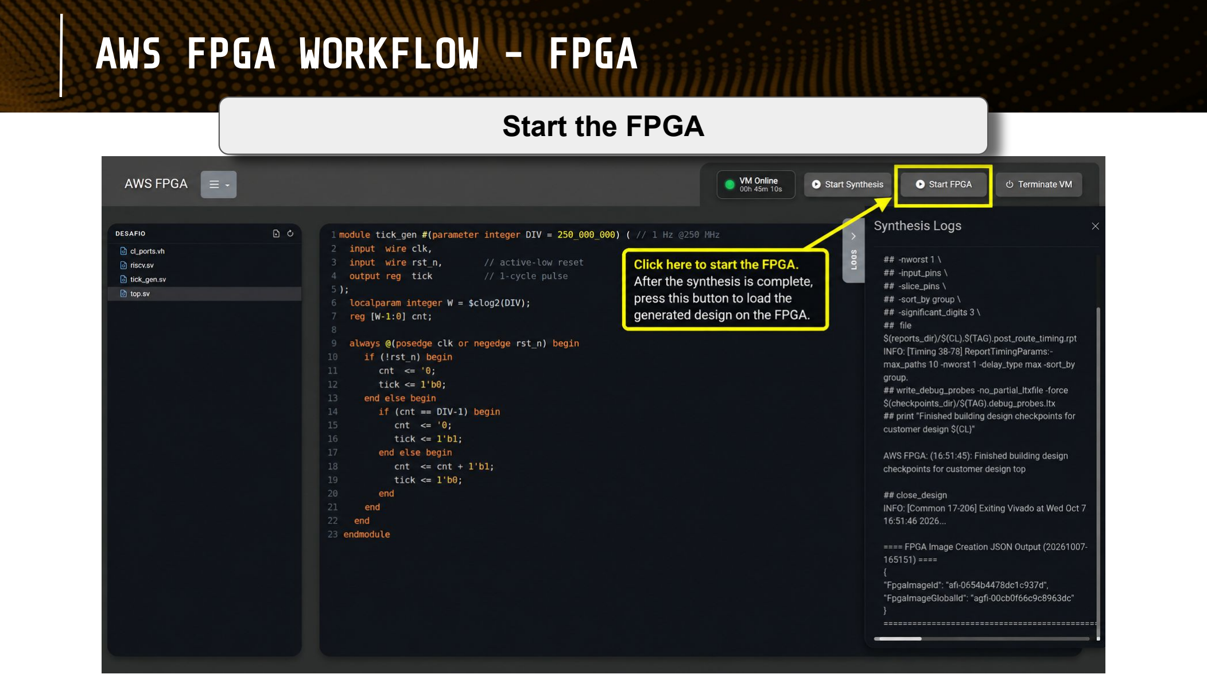
[picture p38: page 9]

AWS FPGA WORKFLOW - FPGA

Start the FPGA

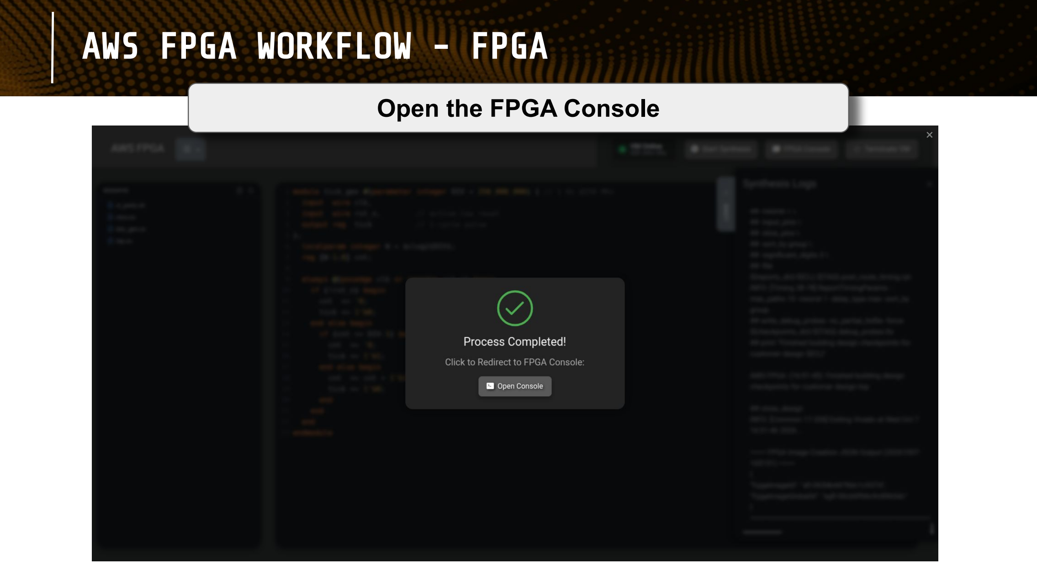
[picture p39: page 10]

AWS FPGA WORKFLOW - FPGA

Open the FPGA Console

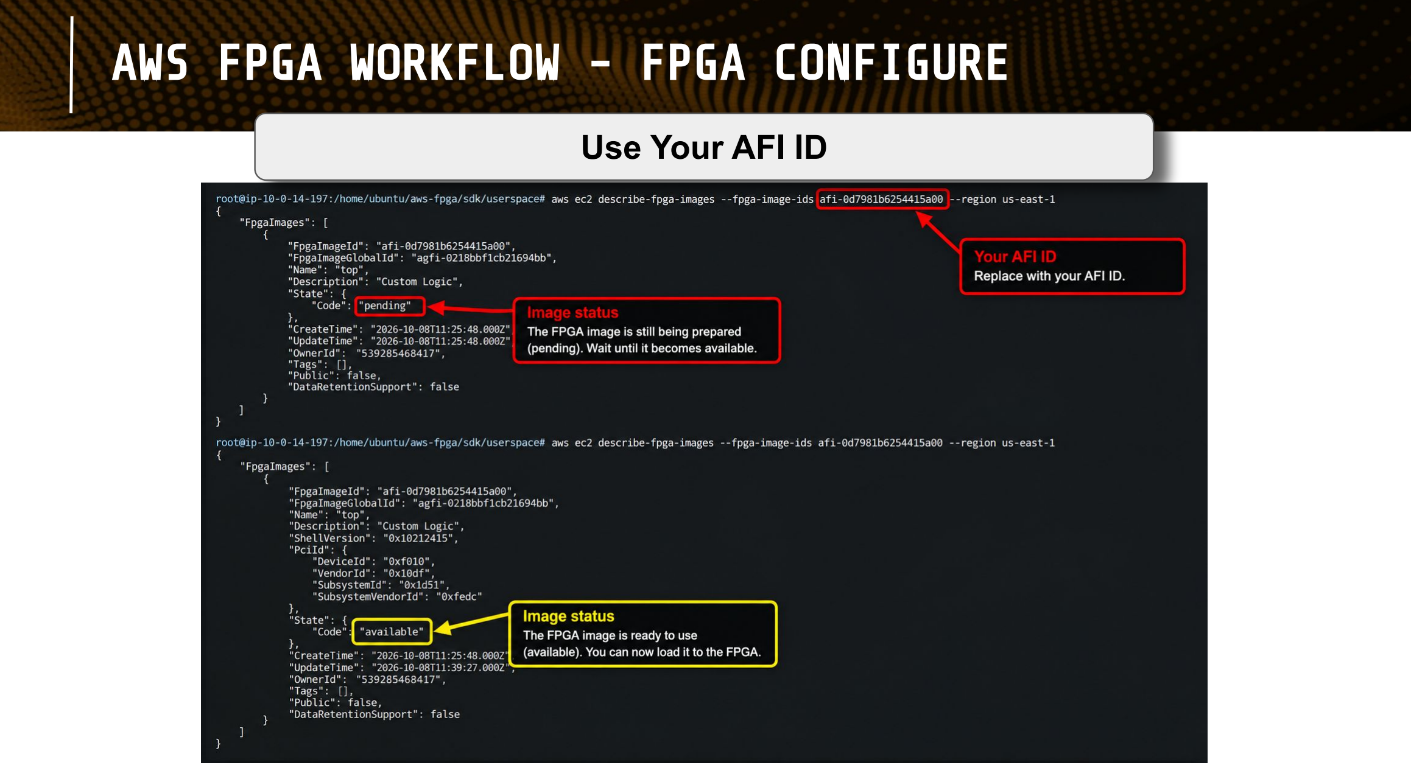
[picture p40: page 11]

AWS FPGA WORKFLOW - FPGA CONFIGURE

Use Your AFI ID

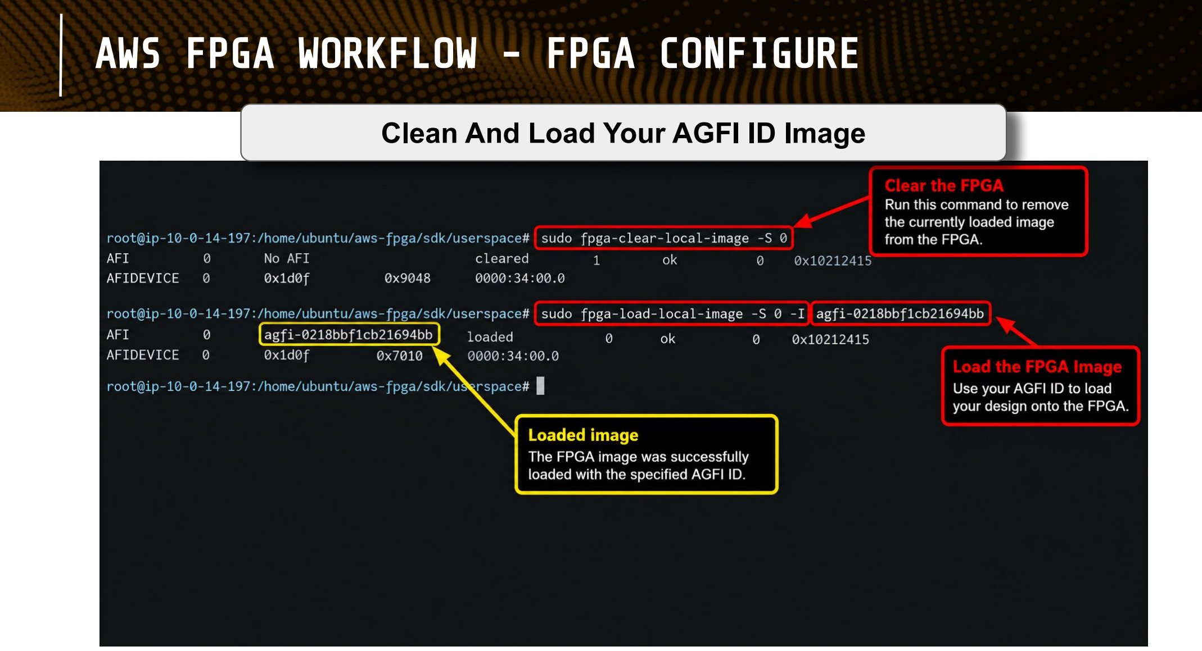
[picture p41: page 12]

AWS FPGA WORKFLOW - FPGA CONFIGURE

Clean And Load Your AGFI ID Image

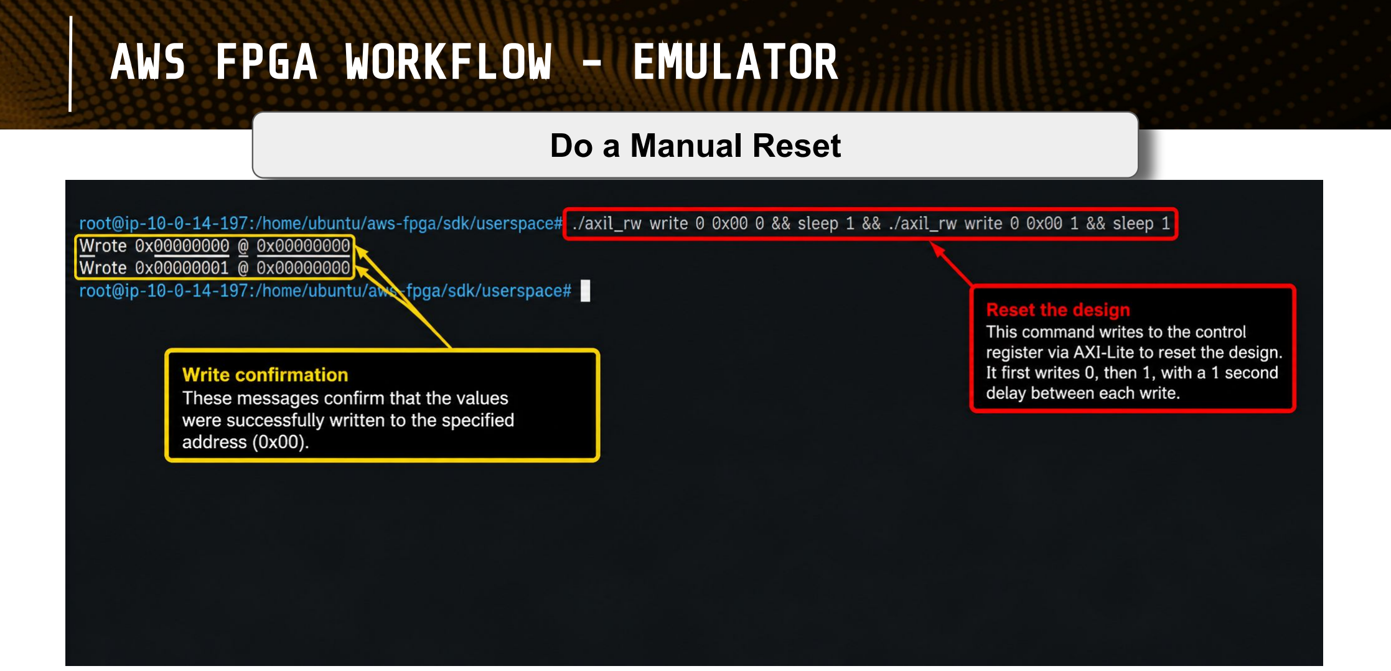
[picture p42: page 13]

AWS FPGA WORKFLOW - EMULATOR

Do a Manual Reset

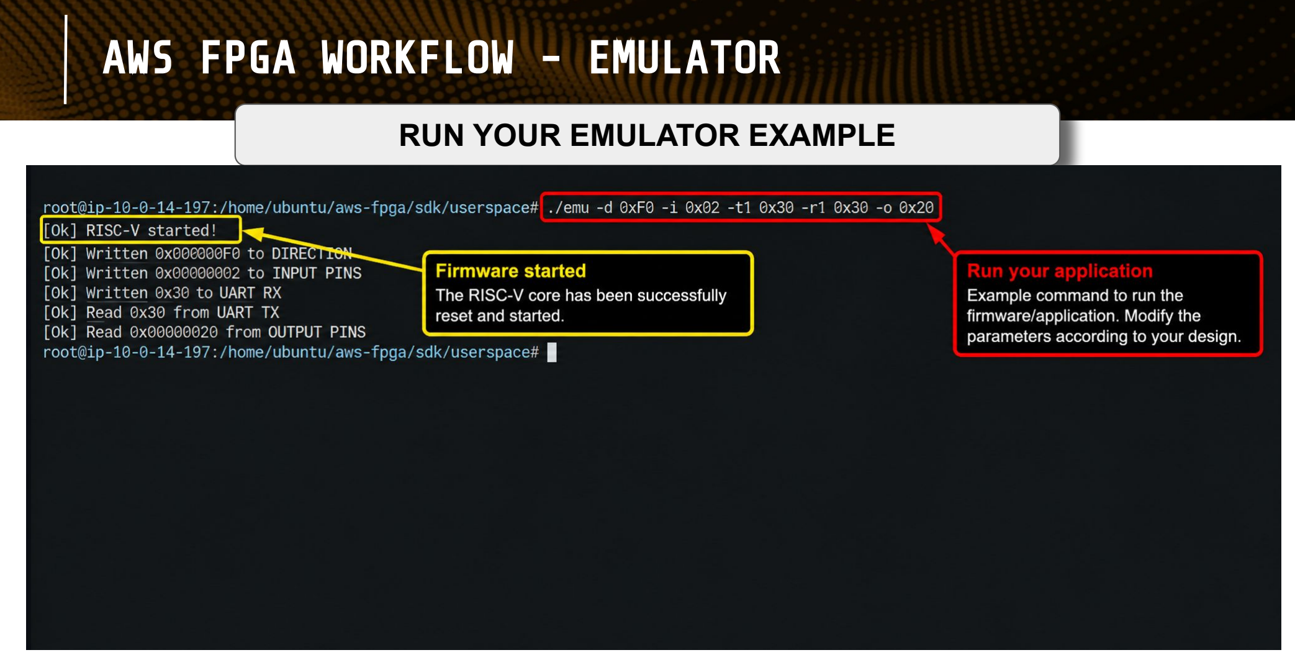
[picture p43: page 14]

AWS FPGA WORKFLOW - EMULATOR

RUN YOUR EMULATOR EXAMPLE

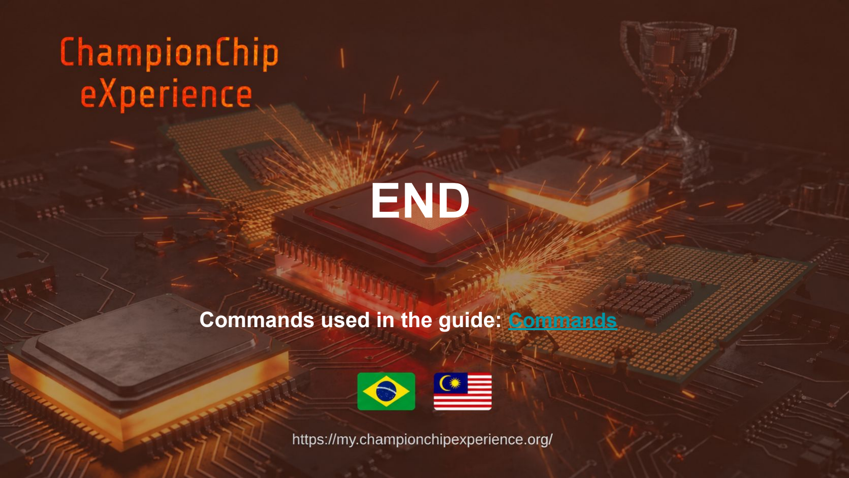
[picture p44: page 15]

Commands used in the guide: Commands (https://drive.google.com/file/d/17TYujlIQXbcr8w23DHpyuJ1e4U93wGJq/view?usp=sharing)

## END
