ZhuHengg/ChampionCHIP-Multicycle-Processor-Architecture/chip-inventor/testbench/full_firmware_waveform/full_view_wavescreenshot.png

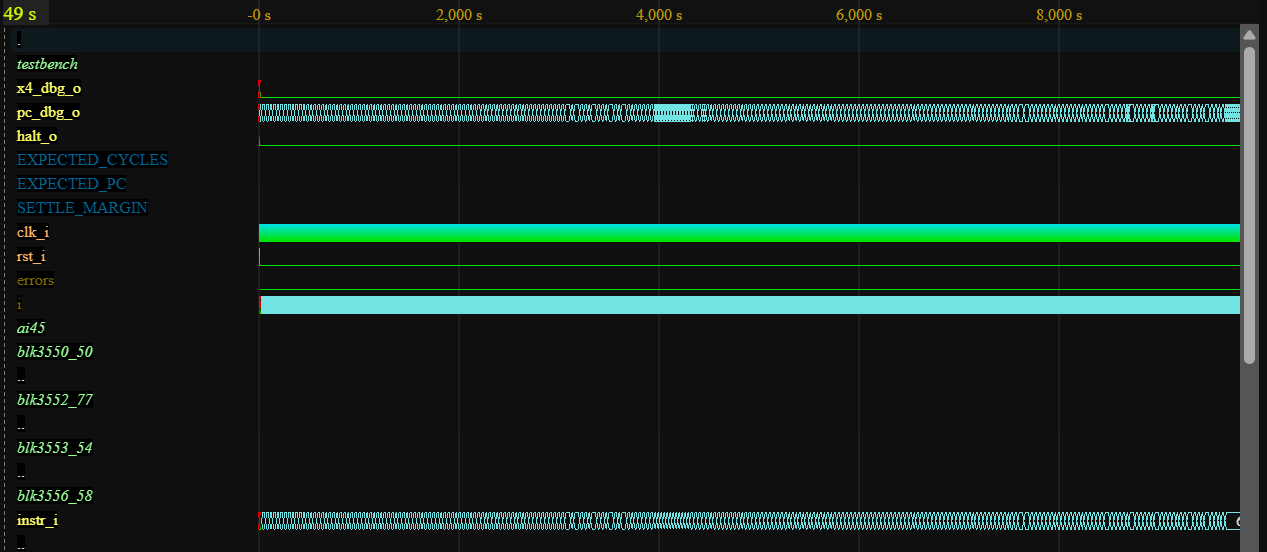
chip-inventor/testbench/full_firmware_waveform/full_view_wavescreenshot.png
