ZhuHengg/ChampionCHIP-Multicycle-Processor-Architecture/chip-inventor/testbench/full_firmware_waveform/waveform_0_500ms.png

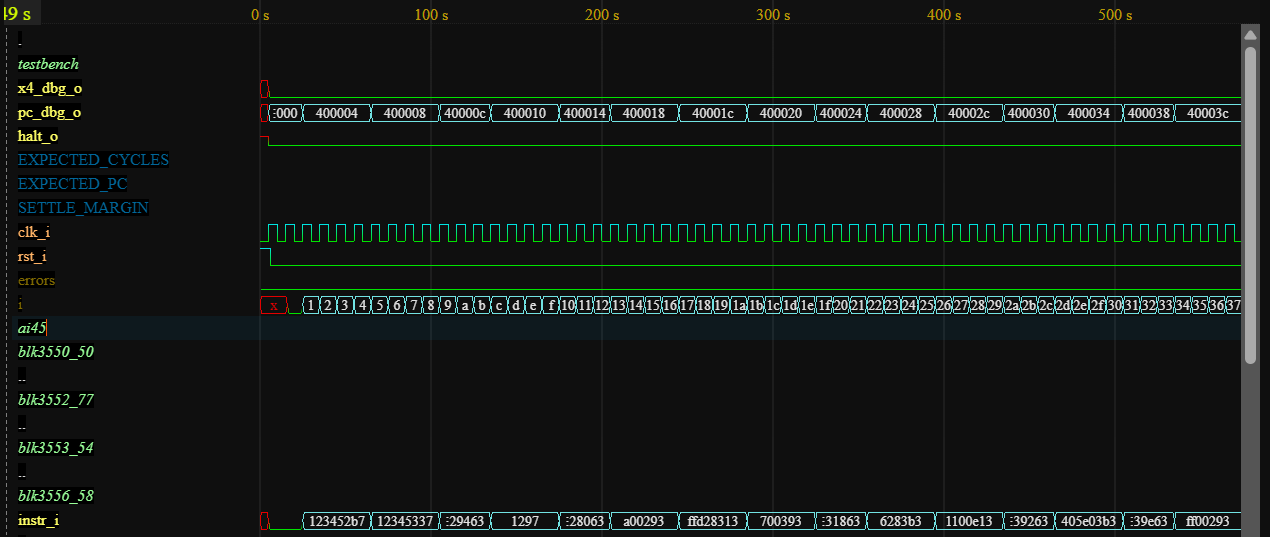
chip-inventor/testbench/full_firmware_waveform/waveform_0_500ms.png
