ZhuHengg/ChampionCHIP-Multicycle-Processor-Architecture/chip-inventor/testbench/module_testbench/alu/alu_testbench_waveform.png

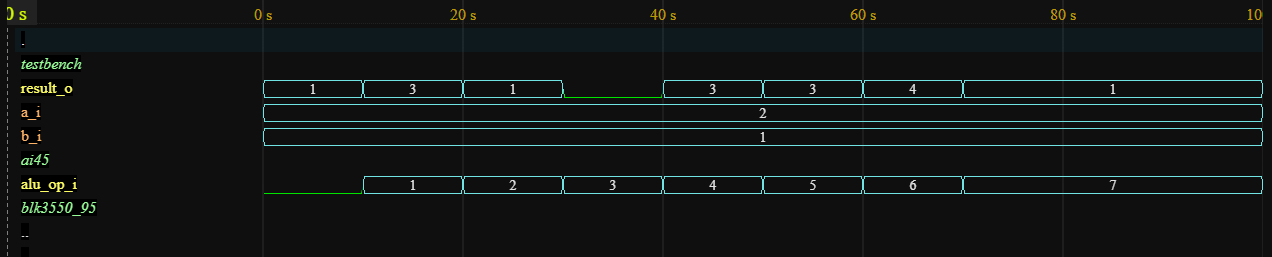
chip-inventor/testbench/module_testbench/alu/alu_testbench_waveform.png
