ZhuHengg/ChampionCHIP-Multicycle-Processor-Architecture/chip-inventor/testbench/module_testbench/control_unit/control_unit_testbench_waveform.png

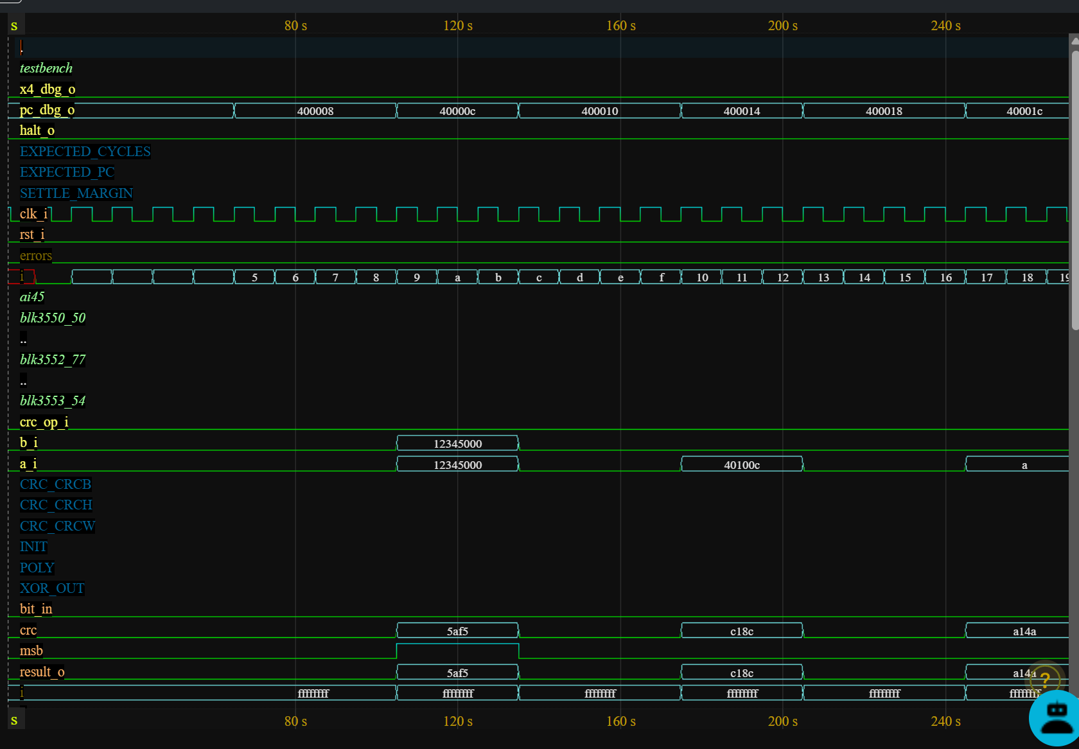
chip-inventor/testbench/module_testbench/control_unit/control_unit_testbench_waveform.png
