ZhuHengg/ChampionCHIP-Multicycle-Processor-Architecture/chip-inventor/testbench/module_testbench/lsu/lsu_testbench_waveform.png

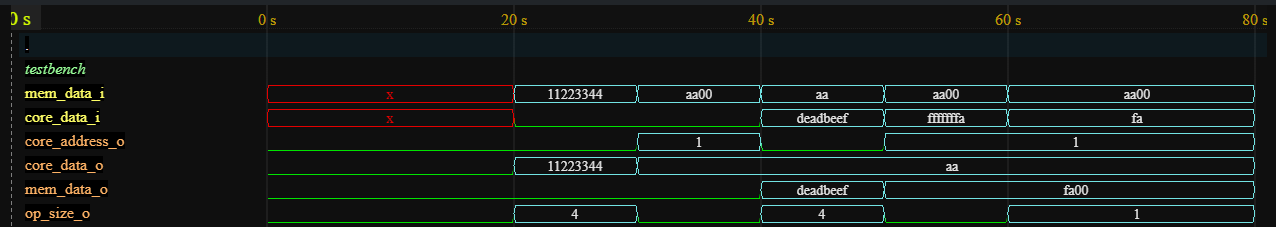
chip-inventor/testbench/module_testbench/lsu/lsu_testbench_waveform.png
