ZhuHengg/ChampionCHIP-Multicycle-Processor-Architecture/chip-inventor/testbench/module_testbench/memory_mapping/memory_mapping_waveform.png

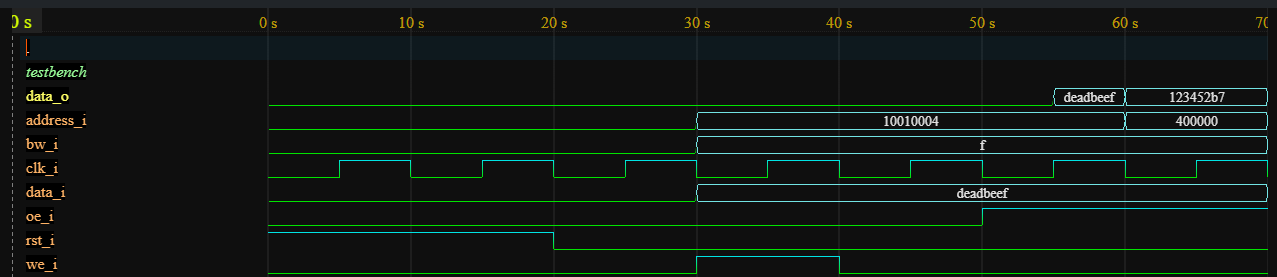
chip-inventor/testbench/module_testbench/memory_mapping/memory_mapping_waveform.png
