ZhuHengg/ChampionCHIP-Multicycle-Processor-Architecture/chip-inventor/testbench/module_testbench/regfile/regfile_testbench_waveform.png

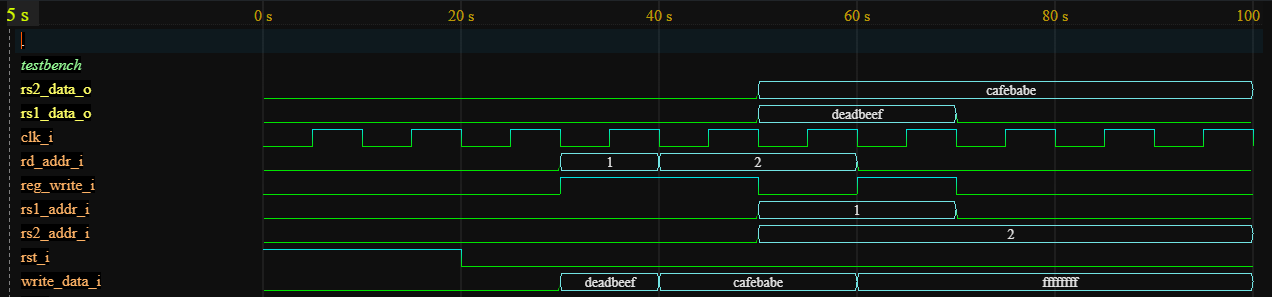
chip-inventor/testbench/module_testbench/regfile/regfile_testbench_waveform.png
