ZhuHengg/ChampionCHIP-Multicycle-Processor-Architecture/stage2-chip-inventor/testbench/full_firmware_waveform/gtkwave_screenshot.png

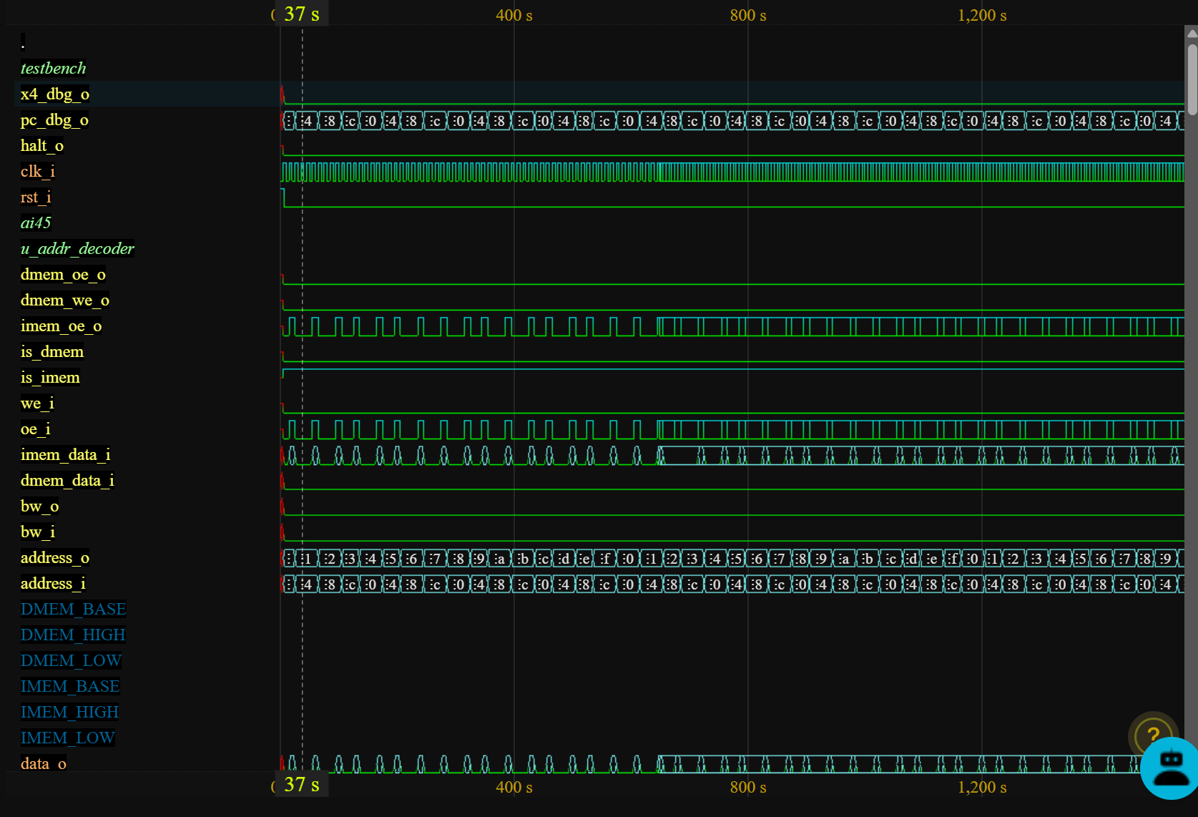
stage2-chip-inventor/testbench/full_firmware_waveform/gtkwave_screenshot.png
