ZhuHengg/ChampionCHIP-Multicycle-Processor-Architecture/stage2-chip-inventor/testbench/full_firmware_waveform/zoom_in_x4_and_pc_end_waveform.png

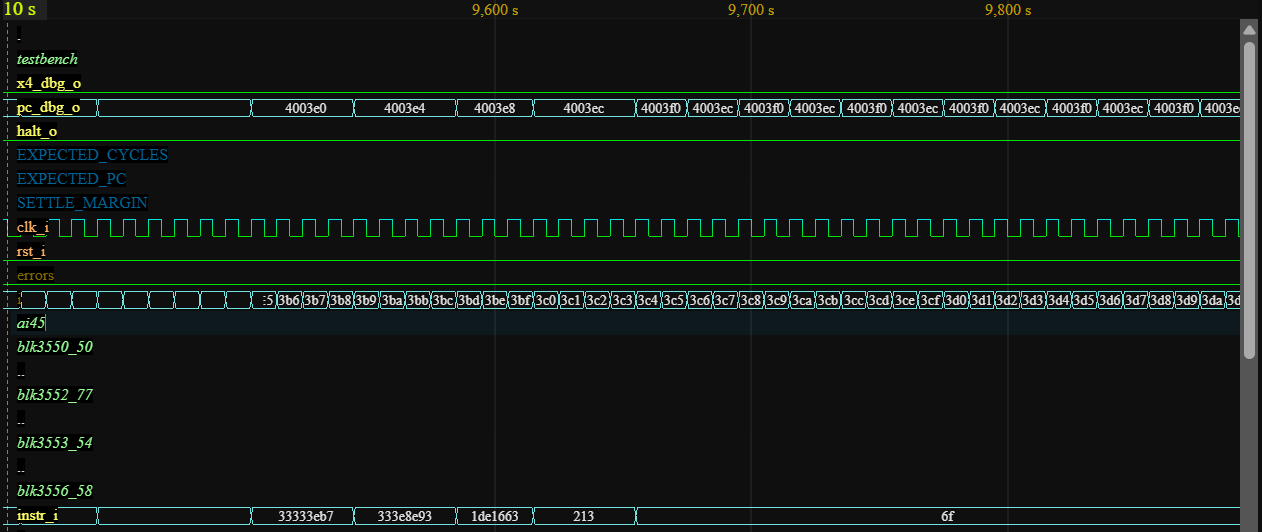
stage2-chip-inventor/testbench/full_firmware_waveform/zoom_in_x4_and_pc_end_waveform.png
