ZhuHengg/ChampionCHIP-Multicycle-Processor-Architecture/chip-inventor/rtl/top.v

//  ---------- INLCUDED BLOCK: alu_eq26  ---------- 
module alu_eq26 (
    input  wire [31:0] a_i,
    input  wire [31:0] b_i,
    input  wire [3:0]  alu_op_i,
    output reg  [31:0] result_o
);
    // ALU op codes
    localparam [3:0] ALU_PASS_B = 4'h0;
    localparam [3:0] ALU_ADD    = 4'h1;
    localparam [3:0] ALU_SUB    = 4'h2;
    localparam [3:0] ALU_AND    = 4'h3;
    localparam [3:0] ALU_OR     = 4'h4;
    localparam [3:0] ALU_XOR    = 4'h5;
    localparam [3:0] ALU_SLL    = 4'h6;
    localparam [3:0] ALU_SRL    = 4'h7;
    localparam [3:0] ALU_MRS    = 4'h8; // SRA
    localparam [3:0] ALU_SLT    = 4'h9;
    localparam [3:0] ALU_SLTU   = 4'hA;
    always @(*) begin
        result_o = 32'b0; // default value
        case (alu_op_i)
            ALU_PASS_B: result_o = b_i;
            ALU_ADD:    result_o = a_i + b_i;
            ALU_SUB:    result_o = a_i - b_i;
            ALU_AND:    result_o = a_i & b_i;
            ALU_OR:     result_o = a_i | b_i;
            ALU_XOR:    result_o = a_i ^ b_i;
            ALU_SLL:    result_o = a_i << b_i[4:0];
            ALU_SRL:    result_o = a_i >> b_i[4:0];
            ALU_MRS:    result_o = $signed(a_i) >>> b_i[4:0];
            ALU_SLT:    result_o = ($signed(a_i) < $signed(b_i)) ? 32'd1 : 32'd0;
            ALU_SLTU:   result_o = (a_i < b_i) ? 32'd1 : 32'd0;
            default:    result_o = 32'b0;
        endcase
    end
endmodule



//  ---------- INLCUDED BLOCK: branch_comparator_eq26  ----------
// Branch condition comparator.
module branch_comparator_eq26(
    input  wire [31:0] rs1_i,
    input  wire [31:0] rs2_i,
    input  wire [2:0]  funct3_i,
    output reg  branch_taken_o
);

    // RV32I branch funct3 codes.
    localparam FUNCT3_BEQ  = 3'b000;
    localparam FUNCT3_BNE  = 3'b001;
    localparam FUNCT3_BLT  = 3'b100;
    localparam FUNCT3_BGE  = 3'b101;
    localparam FUNCT3_BLTU = 3'b110;
    localparam FUNCT3_BGEU = 3'b111;

    always @(*) begin
        branch_taken_o = 1'b0; // default: not taken (covers 010/011 unused)
        case (funct3_i)
            FUNCT3_BEQ:  branch_taken_o = (rs1_i == rs2_i);
            FUNCT3_BNE:  branch_taken_o = (rs1_i != rs2_i);
            FUNCT3_BLT:  branch_taken_o = ($signed(rs1_i) <  $signed(rs2_i));
            FUNCT3_BGE:  branch_taken_o = ($signed(rs1_i) >= $signed(rs2_i));
            FUNCT3_BLTU: branch_taken_o = (rs1_i <  rs2_i);
            FUNCT3_BGEU: branch_taken_o = (rs1_i >= rs2_i);
            default:     branch_taken_o = 1'b0;
        endcase
    end

endmodule



//  ---------- INLCUDED BLOCK: crc_eq26  ----------
// CRC-16 compute unit.
module crc_eq26(
    input  wire [31:0] a_i,
    input  wire [31:0] b_i,
    input  wire [3:0]  crc_op_i,
    output reg  [31:0] result_o
);

    // CRC Operation Codes (Table 11 - Xicrc)
    localparam [3:0] CRC_CRCB = 4'h0;
    localparam [3:0] CRC_CRCH = 4'h1;
    localparam [3:0] CRC_CRCW = 4'h2;

    parameter POLY    = 16'h1021;
    parameter INIT    = 16'hFFFF; // unused directly — seed comes in via b_i, kept for spec visibility
    parameter XOR_OUT = 16'h0000;

    integer i;
    reg [15:0] crc;
    reg        bit_in, msb;

    always @(*) begin
        result_o = 32'b0; // default, also covers illegal crc_op
        case (crc_op_i)
            CRC_CRCB, CRC_CRCH, CRC_CRCW: begin
                crc = b_i[15:0]; // seed threads through rs2
                case (crc_op_i)
                    CRC_CRCB: begin
                        for (i = 7; i >= 0; i = i - 1) begin
                            bit_in = a_i[i];
                            msb    = crc[15];
                            crc    = (crc << 1) & 16'hFFFF;
                            if (msb ^ bit_in) crc = crc ^ POLY;
                        end
                    end
                    CRC_CRCH: begin
                        for (i = 15; i >= 0; i = i - 1) begin
                            bit_in = a_i[i];
                            msb    = crc[15];
                            crc    = (crc << 1) & 16'hFFFF;
                            if (msb ^ bit_in) crc = crc ^ POLY;
                        end
                    end
                    default: begin // CRC_CRCW
                        for (i = 31; i >= 0; i = i - 1) begin
                            bit_in = a_i[i];
                            msb    = crc[15];
                            crc    = (crc << 1) & 16'hFFFF;
                            if (msb ^ bit_in) crc = crc ^ POLY;
                        end
                    end
                endcase
                result_o = {16'b0, crc ^ XOR_OUT};
            end
            default: result_o = 32'b0;
        endcase
    end

endmodule



//  ---------- INLCUDED BLOCK: imm_extend_eq26  ----------
// Immediate extender.
module imm_extend_eq26(
    input  wire [31:0] instr_i,
    input  wire [2:0]  imm_sel_i,
    output reg  [31:0] imm_o
);
    // Immediate format selectors
    localparam [2:0] IMM_SEL_I = 3'b000;
    localparam [2:0] IMM_SEL_S = 3'b001;
    localparam [2:0] IMM_SEL_B = 3'b010;
    localparam [2:0] IMM_SEL_U = 3'b011;
    localparam [2:0] IMM_SEL_J = 3'b100;
    always @(*) begin
        imm_o = 32'b0; // default
        case (imm_sel_i)
            // I-type
            IMM_SEL_I: imm_o = {{20{instr_i[31]}}, instr_i[31:20]};
            // S-type
            IMM_SEL_S: imm_o = {{20{instr_i[31]}}, instr_i[31:25], instr_i[11:7]};
            // B-type
            IMM_SEL_B: imm_o = {{19{instr_i[31]}}, instr_i[31], instr_i[7],
                                  instr_i[30:25], instr_i[11:8], 1'b0};
            // U-type
            IMM_SEL_U: imm_o = {instr_i[31:12], 12'b0};
            // J-type
            IMM_SEL_J: imm_o = {{11{instr_i[31]}}, instr_i[31], instr_i[19:12],
                                  instr_i[20], instr_i[30:21], 1'b0};
            default: imm_o = 32'b0;
        endcase
    end
endmodule



//  ---------- INLCUDED BLOCK: mult_eq26  ----------
// 32x32 combinational multiplier.
module mult_eq26(
    input  wire [31:0] a_i,
    input  wire [31:0] b_i,
    input  wire [3:0]  mult_op_i,
    output reg  [31:0] result_o
);

    // Multiplier op codes
    localparam [3:0] MULT_MUL    = 4'h0;
    localparam [3:0] MULT_MULH   = 4'h1;
    localparam [3:0] MULT_MULHSU = 4'h2;
    localparam [3:0] MULT_MULHU  = 4'h3;

    wire signed [63:0] p_ss = $signed(a_i) * $signed(b_i);                       // signed x signed
    wire signed [63:0] p_su = $signed({{32{a_i[31]}}, a_i}) * $signed({32'b0, b_i}); // signed x unsigned
    wire        [63:0] p_uu = a_i * b_i;                                         // unsigned x unsigned

    always @(*) begin
        result_o = 32'b0; // default
        case (mult_op_i)
            MULT_MUL:    result_o = p_ss[31:0];  // low half identical regardless of signedness
            MULT_MULH:   result_o = p_ss[63:32];
            MULT_MULHSU: result_o = p_su[63:32];
            MULT_MULHU:  result_o = p_uu[63:32];
            default:      result_o = 32'b0;
        endcase
    end

endmodule



//  ---------- INLCUDED BLOCK: regfile_eq  ---------- 
module regfile_eq(
    input  wire        clk_i,
    input  wire        rst_i,

    input  wire [4:0]  rs1_addr_i,
    input  wire [4:0]  rs2_addr_i,
    input  wire [4:0]  rd_addr_i,
    input  wire [31:0] write_data_i,
    input  wire        reg_write_i,

    output wire [31:0] rs1_data_o,
    output wire [31:0] rs2_data_o,
    // Debug tap for testbench.
    output wire [31:0] x4_dbg_o
);

    reg [31:0] regs [0:31];

    integer i;

    // Async read, x0 hardwired zero.
    assign rs1_data_o = (rs1_addr_i == 5'd0) ? 32'b0 : regs[rs1_addr_i];
    assign rs2_data_o = (rs2_addr_i == 5'd0) ? 32'b0 : regs[rs2_addr_i];
    assign x4_dbg_o   = regs[4];

    // Sync write, x0 write-protected.
    always @(posedge clk_i) begin
        if (rst_i) begin
            for (i = 0; i < 32; i = i + 1)
                regs[i] <= 32'b0;
        end else if (reg_write_i && rd_addr_i != 5'd0) begin
            regs[rd_addr_i] <= write_data_i;
        end
    end

endmodule



//  ---------- INLCUDED BLOCK: lsu_eq26  ----------
// Load/store alignment unit.
module lsu_eq26(
    input  wire [31:0] core_data_o,     // INPUT: store data from core (rs2)
    input  wire [31:0] core_address_o,  // INPUT: effective address from core (uses [1:0])
    input  wire [2:0]  op_size_o,       // INPUT: from control unit
    input  wire [31:0] mem_data_o,      // INPUT: word read back from memory

    output reg  [31:0] core_data_i,     // OUTPUT: load result, extended, back to core
    output reg  [31:0] mem_data_i       // OUTPUT: store data, positioned, out to memory
);

    localparam [2:0] OP_SIZE_BYTE_S = 3'b000; // lb / sb
    localparam [2:0] OP_SIZE_BYTE_U = 3'b001; // lbu
    localparam [2:0] OP_SIZE_HALF_S = 3'b010; // lh / sh
    localparam [2:0] OP_SIZE_HALF_U = 3'b011; // lhu
    localparam [2:0] OP_SIZE_WORD   = 3'b100; // lw / sw

    wire [1:0] byte_sel = core_address_o[1:0];

    // Load path.
    reg [7:0]  load_byte;
    reg [15:0] load_half;

    always @(*) begin
        load_byte = 8'b0;
        case (byte_sel)
            2'b00:   load_byte = mem_data_o[ 7: 0];
            2'b01:   load_byte = mem_data_o[15: 8];
            2'b10:   load_byte = mem_data_o[23:16];
            2'b11:   load_byte = mem_data_o[31:24];
            default: load_byte = mem_data_o[7:0];
        endcase
    end

    always @(*) begin
        load_half = 16'b0;
        case (byte_sel[1])
            1'b0:    load_half = mem_data_o[15: 0];
            1'b1:    load_half = mem_data_o[31:16];
            default: load_half = mem_data_o[15:0];
        endcase
    end

    always @(*) begin
        core_data_i = 32'b0; // default
        case (op_size_o)
            OP_SIZE_BYTE_S: core_data_i = {{24{load_byte[7]}}, load_byte};
            OP_SIZE_BYTE_U: core_data_i = {24'b0, load_byte};
            OP_SIZE_HALF_S: core_data_i = {{16{load_half[15]}}, load_half};
            OP_SIZE_HALF_U: core_data_i = {16'b0, load_half};
            OP_SIZE_WORD:   core_data_i = mem_data_o;
            default:         core_data_i = mem_data_o;
        endcase
    end

    // Store path.
    always @(*) begin
        mem_data_i = 32'b0; // default
        case (op_size_o[2:1]) // size bits only; sign bit don't-care for stores
            2'b00: begin // byte
                case (byte_sel)
                    2'b00:   mem_data_i = {24'b0, core_data_o[7:0]};
                    2'b01:   mem_data_i = {16'b0, core_data_o[7:0], 8'b0};
                    2'b10:   mem_data_i = {8'b0, core_data_o[7:0], 16'b0};
                    2'b11:   mem_data_i = {core_data_o[7:0], 24'b0};
                    default: mem_data_i = {24'b0, core_data_o[7:0]};
                endcase
            end
            2'b01: begin // half
                mem_data_i = byte_sel[1] ? {core_data_o[15:0], 16'b0}
                                          : {16'b0, core_data_o[15:0]};
            end
            2'b10: mem_data_i = core_data_o; // word
            default: mem_data_i = core_data_o;
        endcase
    end

endmodule



//  ---------- INLCUDED BLOCK: imem  ---------- 
module imem #(
    parameter integer FIRMWARE = 0
) (
    input  wire        clk_i,
    input  wire [31:0] addr_i,
    input  wire        oe_i,
    output reg  [31:0] data_o
);
    always @(*) begin
        data_o = 32'h00000000;
        if (oe_i) begin
            if (FIRMWARE == 1) begin
                // FIRMWARE 1: GPIO system test
                case (addr_i[9:0])
                    10'd0: data_o = 32'hf00000b7; // lui x1,0xf0000
                    10'd1: data_o = 32'h00f00113; // addi x2,x0,15
                    10'd2: data_o = 32'h0020a423; // sw x2,8(x1)
                    10'd3: data_o = 32'h0080a183; // lw x3,8(x1)
                    10'd4: data_o = 32'h02219663; // bne x3,x2,fail
                    10'd5: data_o = 32'h00500113; // addi x2,x0,5
                    10'd6: data_o = 32'h0020a023; // sw x2,0(x1)
                    10'd7: data_o = 32'h0000a183; // lw x3,0(x1)
                    10'd8: data_o = 32'h00219e63; // bne x3,x2,fail
                    10'd9: data_o = 32'h0040a183; // lw x3,4(x1)
                    10'd10: data_o = 32'h0f01f193; // andi x3,x3,240
                    10'd11: data_o = 32'h0a000113; // addi x2,x0,160
                    10'd12: data_o = 32'h00219663; // bne x3,x2,fail
                    10'd13: data_o = 32'h05500213; // addi x4,x0,85
                    10'd14: data_o = 32'h0000006f; // jal x0,pass
                    10'd15: data_o = 32'h0ff00213; // addi x4,x0,255
                    10'd16: data_o = 32'h0000006f; // jal x0,failed
                    default: data_o = 32'h0000006f; // j . (park)
                endcase
            end else if (FIRMWARE == 2) begin
                // FIRMWARE 2: UART echo test
                case (addr_i[9:0])
                    10'd0: data_o = 32'hf10000b7; // lui x1,0xf1000
                    10'd1: data_o = 32'h0080a183; // lw x3,8(x1)
                    10'd2: data_o = 32'h0021f193; // andi x3,x3,2
                    10'd3: data_o = 32'hfe018ce3; // beq x3,x0,rxwait
                    10'd4: data_o = 32'h0000a423; // sw x0,8(x1)
                    10'd5: data_o = 32'h0040a103; // lw x2,4(x1)
                    10'd6: data_o = 32'h0080a183; // lw x3,8(x1)
                    10'd7: data_o = 32'h0041f193; // andi x3,x3,4
                    10'd8: data_o = 32'hfe018ce3; // beq x3,x0,txwait
                    10'd9: data_o = 32'h0020a023; // sw x2,0(x1)
                    10'd10: data_o = 32'h00100193; // addi x3,x0,1
                    10'd11: data_o = 32'h0030a423; // sw x3,8(x1)
                    10'd12: data_o = 32'h0080a183; // lw x3,8(x1)
                    10'd13: data_o = 32'h0041f193; // andi x3,x3,4
                    10'd14: data_o = 32'hfe018ce3; // beq x3,x0,donewait
                    10'd15: data_o = 32'h05500213; // addi x4,x0,85
                    10'd16: data_o = 32'h0000006f; // jal x0,pass
                    default: data_o = 32'h0000006f; // j . (park)
                endcase
            end else if (FIRMWARE == 3) begin
                // FIRMWARE 3: full system test
                case (addr_i[9:0])
                    10'd0: data_o = 32'hf0000437; // lui x8,0xf0000
                    10'd1: data_o = 32'hf10004b7; // lui x9,0xf1000
                    10'd2: data_o = 32'h00f00293; // addi x5,x0,15
                    10'd3: data_o = 32'h00542423; // sw x5,8(x8)
                    10'd4: data_o = 32'h00010537; // lui x10,0x10
                    10'd5: data_o = 32'hfff50513; // addi x10,x10,-1
                    10'd6: data_o = 32'h00400593; // addi x11,x0,4
                    10'd7: data_o = 32'h0084a283; // lw x5,8(x9)
                    10'd8: data_o = 32'h0022f293; // andi x5,x5,2
                    10'd9: data_o = 32'hfe028ce3; // beq x5,x0,rxwait
                    10'd10: data_o = 32'h0004a423; // sw x0,8(x9)
                    10'd11: data_o = 32'h0044a603; // lw x12,4(x9)
                    10'd12: data_o = 32'h80a60533; // crcb x10,x12,x10
                    10'd13: data_o = 32'h00c42023; // sw x12,0(x8)
                    10'd14: data_o = 32'h00442683; // lw x13,4(x8)
                    10'd15: data_o = 32'h0046d693; // srli x13,x13,4
                    10'd16: data_o = 32'h00f6f693; // andi x13,x13,15
                    10'd17: data_o = 32'h02d60733; // mul x14,x12,x13
                    10'd18: data_o = 32'h0ff77713; // andi x14,x14,255
                    10'd19: data_o = 32'h0084a283; // lw x5,8(x9)
                    10'd20: data_o = 32'h0042f293; // andi x5,x5,4
                    10'd21: data_o = 32'hfe028ce3; // beq x5,x0,txwait0
                    10'd22: data_o = 32'h00e4a023; // sw x14,0(x9)
                    10'd23: data_o = 32'h00100293; // addi x5,x0,1
                    10'd24: data_o = 32'h0054a423; // sw x5,8(x9)
                    10'd25: data_o = 32'hfff58593; // addi x11,x11,-1
                    10'd26: data_o = 32'hfa059ae3; // bne x11,x0,loop
                    10'd27: data_o = 32'h0ff57713; // andi x14,x10,255
                    10'd28: data_o = 32'h0084a283; // lw x5,8(x9)
                    10'd29: data_o = 32'h0042f293; // andi x5,x5,4
                    10'd30: data_o = 32'hfe028ce3; // beq x5,x0,txwait1
                    10'd31: data_o = 32'h00e4a023; // sw x14,0(x9)
                    10'd32: data_o = 32'h00100293; // addi x5,x0,1
                    10'd33: data_o = 32'h0054a423; // sw x5,8(x9)
                    10'd34: data_o = 32'h00855713; // srli x14,x10,8
                    10'd35: data_o = 32'h0084a283; // lw x5,8(x9)
                    10'd36: data_o = 32'h0042f293; // andi x5,x5,4
                    10'd37: data_o = 32'hfe028ce3; // beq x5,x0,txwait2
                    10'd38: data_o = 32'h00e4a023; // sw x14,0(x9)
                    10'd39: data_o = 32'h00100293; // addi x5,x0,1
                    10'd40: data_o = 32'h0054a423; // sw x5,8(x9)
                    10'd41: data_o = 32'h0084a283; // lw x5,8(x9)
                    10'd42: data_o = 32'h0042f293; // andi x5,x5,4
                    10'd43: data_o = 32'hfe028ce3; // beq x5,x0,txdone
                    10'd44: data_o = 32'h05500213; // addi x4,x0,85
                    10'd45: data_o = 32'h0000006f; // jal x0,pass
                    default: data_o = 32'h0000006f; // j . (park)
                endcase
            end else if (FIRMWARE == 4) begin
                // FIRMWARE 4: organiser official GPIO/UART firmware
                case (addr_i[9:0])
                    10'd0: data_o = 32'hf0000437; // organiser GPIO/UART test firmware (verbatim)
                    10'd1: data_o = 32'hf10004b7; // organiser GPIO/UART test firmware (verbatim)
                    10'd2: data_o = 32'h00842283; // organiser GPIO/UART test firmware (verbatim)
                    10'd3: data_o = 32'h0f02e293; // organiser GPIO/UART test firmware (verbatim)
                    10'd4: data_o = 32'h00542423; // organiser GPIO/UART test firmware (verbatim)
                    10'd5: data_o = 32'h00442283; // organiser GPIO/UART test firmware (verbatim)
                    10'd6: data_o = 32'h00429293; // organiser GPIO/UART test firmware (verbatim)
                    10'd7: data_o = 32'h00542023; // organiser GPIO/UART test firmware (verbatim)
                    10'd8: data_o = 32'h0084a283; // organiser GPIO/UART test firmware (verbatim)
                    10'd9: data_o = 32'h0022f293; // organiser GPIO/UART test firmware (verbatim)
                    10'd10: data_o = 32'hfe028ce3; // organiser GPIO/UART test firmware (verbatim)
                    10'd11: data_o = 32'h0004a423; // organiser GPIO/UART test firmware (verbatim)
                    10'd12: data_o = 32'h0044a303; // organiser GPIO/UART test firmware (verbatim)
                    10'd13: data_o = 32'h0084a283; // organiser GPIO/UART test firmware (verbatim)
                    10'd14: data_o = 32'h0042f293; // organiser GPIO/UART test firmware (verbatim)
                    10'd15: data_o = 32'hfe028ce3; // organiser GPIO/UART test firmware (verbatim)
                    10'd16: data_o = 32'h0064a023; // organiser GPIO/UART test firmware (verbatim)
                    10'd17: data_o = 32'h0084a303; // organiser GPIO/UART test firmware (verbatim)
                    10'd18: data_o = 32'h00136313; // organiser GPIO/UART test firmware (verbatim)
                    10'd19: data_o = 32'h0064a423; // organiser GPIO/UART test firmware (verbatim)
                    10'd20: data_o = 32'hfc5ff06f; // organiser GPIO/UART test firmware (verbatim)
                    default: data_o = 32'h0000006f; // j . (park)
                endcase
            end else if (FIRMWARE == 5) begin
                // FIRMWARE 5: grid-aware EV charger application
                case (addr_i[9:0])
                    10'd0: data_o = 32'hf0000437; // grid-aware EV charger application
                    10'd1: data_o = 32'hf10004b7; // grid-aware EV charger application
                    10'd2: data_o = 32'h0f000293; // grid-aware EV charger application
                    10'd3: data_o = 32'h00542423; // grid-aware EV charger application
                    10'd4: data_o = 32'h00042023; // grid-aware EV charger application
                    10'd5: data_o = 32'h00000213; // grid-aware EV charger application
                    10'd6: data_o = 32'hfff00913; // grid-aware EV charger application
                    10'd7: data_o = 32'h00000993; // grid-aware EV charger application
                    10'd8: data_o = 32'h00000a13; // grid-aware EV charger application
                    10'd9: data_o = 32'h00000a93; // grid-aware EV charger application
                    10'd10: data_o = 32'h00000b13; // grid-aware EV charger application
                    10'd11: data_o = 32'h00000b93; // grid-aware EV charger application
                    10'd12: data_o = 32'h00000c13; // grid-aware EV charger application
                    10'd13: data_o = 32'h00000c93; // grid-aware EV charger application
                    10'd14: data_o = 32'h00000113; // grid-aware EV charger application
                    10'd15: data_o = 32'h010000ef; // grid-aware EV charger application
                    10'd16: data_o = 32'h118000ef; // grid-aware EV charger application
                    10'd17: data_o = 32'h264000ef; // grid-aware EV charger application
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
                    10'd166: data_o = 32'h0084a283; // grid-aware EV charger application
                    10'd167: data_o = 32'h0012e293; // grid-aware EV charger application
                    10'd168: data_o = 32'h0054a423; // grid-aware EV charger application
                    10'd169: data_o = 32'h00008067; // grid-aware EV charger application
                    10'd170: data_o = 32'h00008f93; // grid-aware EV charger application
                    10'd171: data_o = 32'h020c8263; // grid-aware EV charger application
                    10'd172: data_o = 32'hf20002b7; // grid-aware EV charger application
                    10'd173: data_o = 32'h0042a303; // grid-aware EV charger application
                    10'd174: data_o = 32'h19000393; // grid-aware EV charger application
                    10'd175: data_o = 32'h00736a63; // grid-aware EV charger application
                    10'd176: data_o = 32'h01fcf393; // grid-aware EV charger application
                    10'd177: data_o = 32'h00000c93; // grid-aware EV charger application
                    10'd178: data_o = 32'h00038463; // grid-aware EV charger application
                    10'd179: data_o = 32'h190000ef; // grid-aware EV charger application
                    10'd180: data_o = 32'h0084a283; // grid-aware EV charger application
                    10'd181: data_o = 32'h0022f293; // grid-aware EV charger application
                    10'd182: data_o = 32'h0e028863; // grid-aware EV charger application
                    10'd183: data_o = 32'h0004a423; // grid-aware EV charger application
                    10'd184: data_o = 32'h0044a303; // grid-aware EV charger application
                    10'd185: data_o = 32'h0ff37313; // grid-aware EV charger application
                    10'd186: data_o = 32'h07e00293; // grid-aware EV charger application
                    10'd187: data_o = 32'h0e530863; // grid-aware EV charger application
                    10'd188: data_o = 32'h0c0c8c63; // grid-aware EV charger application
                    10'd189: data_o = 32'hf20002b7; // grid-aware EV charger application
                    10'd190: data_o = 32'h0002a223; // grid-aware EV charger application
                    10'd191: data_o = 32'h010cf393; // grid-aware EV charger application
                    10'd192: data_o = 32'h00039a63; // grid-aware EV charger application
                    10'd193: data_o = 32'h07d00293; // grid-aware EV charger application
                    10'd194: data_o = 32'h02531263; // grid-aware EV charger application
                    10'd195: data_o = 32'h010cec93; // grid-aware EV charger application
                    10'd196: data_o = 32'h0b80006f; // grid-aware EV charger application
                    10'd197: data_o = 32'h05e00293; // grid-aware EV charger application
                    10'd198: data_o = 32'h00530663; // grid-aware EV charger application
                    10'd199: data_o = 32'h05d00293; // grid-aware EV charger application
                    10'd200: data_o = 32'h0a531863; // grid-aware EV charger application
                    10'd201: data_o = 32'h02034313; // grid-aware EV charger application
                    10'd202: data_o = 32'h02fcfc93; // grid-aware EV charger application
                    10'd203: data_o = 32'h00fcf393; // grid-aware EV charger application
                    10'd204: data_o = 32'h00900293; // grid-aware EV charger application
                    10'd205: data_o = 32'h0853de63; // grid-aware EV charger application
                    10'd206: data_o = 32'h00700293; // grid-aware EV charger application
                    10'd207: data_o = 32'h0653dc63; // grid-aware EV charger application
                    10'd208: data_o = 32'h80e30733; // grid-aware EV charger application
                    10'd209: data_o = 32'h02038c63; // grid-aware EV charger application
                    10'd210: data_o = 32'h00100293; // grid-aware EV charger application
                    10'd211: data_o = 32'h02538c63; // grid-aware EV charger application
                    10'd212: data_o = 32'h00200293; // grid-aware EV charger application
                    10'd213: data_o = 32'h02538c63; // grid-aware EV charger application
                    10'd214: data_o = 32'h00300293; // grid-aware EV charger application
                    10'd215: data_o = 32'h02538e63; // grid-aware EV charger application
                    10'd216: data_o = 32'h00400293; // grid-aware EV charger application
                    10'd217: data_o = 32'h02538e63; // grid-aware EV charger application
                    10'd218: data_o = 32'h00500293; // grid-aware EV charger application
                    10'd219: data_o = 32'h04538063; // grid-aware EV charger application
                    10'd220: data_o = 32'h00831293; // grid-aware EV charger application
                    10'd221: data_o = 32'h0058e8b3; // grid-aware EV charger application
                    10'd222: data_o = 32'h04c0006f; // grid-aware EV charger application
                    10'd223: data_o = 32'h01031193; // grid-aware EV charger application
                    10'd224: data_o = 32'h0440006f; // grid-aware EV charger application
                    10'd225: data_o = 32'h00030793; // grid-aware EV charger application
                    10'd226: data_o = 32'h03c0006f; // grid-aware EV charger application
                    10'd227: data_o = 32'h00831293; // grid-aware EV charger application
                    10'd228: data_o = 32'h0057e7b3; // grid-aware EV charger application
                    10'd229: data_o = 32'h0300006f; // grid-aware EV charger application
                    10'd230: data_o = 32'h00030813; // grid-aware EV charger application
                    10'd231: data_o = 32'h0280006f; // grid-aware EV charger application
                    10'd232: data_o = 32'h00831293; // grid-aware EV charger application
                    10'd233: data_o = 32'h00586833; // grid-aware EV charger application
                    10'd234: data_o = 32'h01c0006f; // grid-aware EV charger application
                    10'd235: data_o = 32'h00030893; // grid-aware EV charger application
                    10'd236: data_o = 32'h0140006f; // grid-aware EV charger application
                    10'd237: data_o = 32'h00700293; // grid-aware EV charger application
                    10'd238: data_o = 32'h00538463; // grid-aware EV charger application
                    10'd239: data_o = 32'h00831313; // grid-aware EV charger application
                    10'd240: data_o = 32'h0061e1b3; // grid-aware EV charger application
                    10'd241: data_o = 32'h001c8c93; // grid-aware EV charger application
                    10'd242: data_o = 32'h000f8093; // grid-aware EV charger application
                    10'd243: data_o = 32'h00008067; // grid-aware EV charger application
                    10'd244: data_o = 32'h00000c93; // grid-aware EV charger application
                    10'd245: data_o = 32'h088000ef; // grid-aware EV charger application
                    10'd246: data_o = 32'hff1ff06f; // grid-aware EV charger application
                    10'd247: data_o = 32'h01fcf393; // grid-aware EV charger application
                    10'd248: data_o = 32'h00038c63; // grid-aware EV charger application
                    10'd249: data_o = 32'h00900293; // grid-aware EV charger application
                    10'd250: data_o = 32'h00539663; // grid-aware EV charger application
                    10'd251: data_o = 32'h028000ef; // grid-aware EV charger application
                    10'd252: data_o = 32'h0080006f; // grid-aware EV charger application
                    10'd253: data_o = 32'h068000ef; // grid-aware EV charger application
                    10'd254: data_o = 32'h02000c93; // grid-aware EV charger application
                    10'd255: data_o = 32'h00010737; // grid-aware EV charger application
                    10'd256: data_o = 32'hfff70713; // grid-aware EV charger application
                    10'd257: data_o = 32'h00000193; // grid-aware EV charger application
                    10'd258: data_o = 32'hf20002b7; // grid-aware EV charger application
                    10'd259: data_o = 32'h0002a223; // grid-aware EV charger application
                    10'd260: data_o = 32'hfb9ff06f; // grid-aware EV charger application
                    10'd261: data_o = 32'h00008f13; // grid-aware EV charger application
                    10'd262: data_o = 32'h000102b7; // grid-aware EV charger application
                    10'd263: data_o = 32'hfff28293; // grid-aware EV charger application
                    10'd264: data_o = 32'h0051f2b3; // grid-aware EV charger application
                    10'd265: data_o = 32'h02571e63; // grid-aware EV charger application
                    10'd266: data_o = 32'h0101d313; // grid-aware EV charger application
                    10'd267: data_o = 32'hfff00293; // grid-aware EV charger application
                    10'd268: data_o = 32'h02590263; // grid-aware EV charger application
                    10'd269: data_o = 32'h412303b3; // grid-aware EV charger application
                    10'd270: data_o = 32'h0ff3f393; // grid-aware EV charger application
                    10'd271: data_o = 32'h02038263; // grid-aware EV charger application
                    10'd272: data_o = 32'h08000293; // grid-aware EV charger application
                    10'd273: data_o = 32'h0053de63; // grid-aware EV charger application
                    10'd274: data_o = 32'h00100293; // grid-aware EV charger application
                    10'd275: data_o = 32'h00538463; // grid-aware EV charger application
                    10'd276: data_o = 32'h040aea93; // grid-aware EV charger application
                    10'd277: data_o = 32'h00030913; // grid-aware EV charger application
                    10'd278: data_o = 32'h02c0006f; // grid-aware EV charger application
                    10'd279: data_o = 32'h00008f13; // grid-aware EV charger application
                    10'd280: data_o = 32'h00200293; // grid-aware EV charger application
                    10'd281: data_o = 32'h005b5463; // grid-aware EV charger application
                    10'd282: data_o = 32'h001b0b13; // grid-aware EV charger application
                    10'd283: data_o = 32'h145b4e63; // grid-aware EV charger application
                    10'd284: data_o = 32'h00400293; // grid-aware EV charger application
                    10'd285: data_o = 32'h14525a63; // grid-aware EV charger application
                    10'd286: data_o = 32'h040aea93; // grid-aware EV charger application
                    10'd287: data_o = 32'hd1dff0ef; // grid-aware EV charger application
                    10'd288: data_o = 32'h1480006f; // grid-aware EV charger application
                    10'd289: data_o = 32'hf20002b7; // grid-aware EV charger application
                    10'd290: data_o = 32'h0002a023; // grid-aware EV charger application
                    10'd291: data_o = 32'h00000113; // grid-aware EV charger application
                    10'd292: data_o = 32'h14000293; // grid-aware EV charger application
                    10'd293: data_o = 32'h0302c063; // grid-aware EV charger application
                    10'd294: data_o = 32'h000012b7; // grid-aware EV charger application
                    10'd295: data_o = 32'h35628293; // grid-aware EV charger application
                    10'd296: data_o = 32'h0058ca63; // grid-aware EV charger application
                    10'd297: data_o = 32'h000012b7; // grid-aware EV charger application
                    10'd298: data_o = 32'h81628293; // grid-aware EV charger application
                    10'd299: data_o = 32'h0057c463; // grid-aware EV charger application
                    10'd300: data_o = 32'h00100113; // grid-aware EV charger application
                    10'd301: data_o = 32'h00000b13; // grid-aware EV charger application
                    10'd302: data_o = 32'h00200293; // grid-aware EV charger application
                    10'd303: data_o = 32'h04520863; // grid-aware EV charger application
                    10'd304: data_o = 32'h00300293; // grid-aware EV charger application
                    10'd305: data_o = 32'h0c520863; // grid-aware EV charger application
                    10'd306: data_o = 32'h00100293; // grid-aware EV charger application
                    10'd307: data_o = 32'h0e521e63; // grid-aware EV charger application
                    10'd308: data_o = 32'h00442283; // grid-aware EV charger application
                    10'd309: data_o = 32'h00f2f293; // grid-aware EV charger application
                    10'd310: data_o = 32'h00200313; // grid-aware EV charger application
                    10'd311: data_o = 32'h0e629663; // grid-aware EV charger application
                    10'd312: data_o = 32'h14000293; // grid-aware EV charger application
                    10'd313: data_o = 32'h0702c063; // grid-aware EV charger application
                    10'd314: data_o = 32'h000012b7; // grid-aware EV charger application
                    10'd315: data_o = 32'h35628293; // grid-aware EV charger application
                    10'd316: data_o = 32'h0658c263; // grid-aware EV charger application
                    10'd317: data_o = 32'h000012b7; // grid-aware EV charger application
                    10'd318: data_o = 32'h81628293; // grid-aware EV charger application
                    10'd319: data_o = 32'h0457cc63; // grid-aware EV charger application
                    10'd320: data_o = 32'h00200513; // grid-aware EV charger application
                    10'd321: data_o = 32'hcb1ff0ef; // grid-aware EV charger application
                    10'd322: data_o = 32'h0040006f; // grid-aware EV charger application
                    10'd323: data_o = 32'h14000293; // grid-aware EV charger application
                    10'd324: data_o = 32'h0302ca63; // grid-aware EV charger application
                    10'd325: data_o = 32'h000012b7; // grid-aware EV charger application
                    10'd326: data_o = 32'h35628293; // grid-aware EV charger application
                    10'd327: data_o = 32'h0258cc63; // grid-aware EV charger application
                    10'd328: data_o = 32'h000012b7; // grid-aware EV charger application
                    10'd329: data_o = 32'h81628293; // grid-aware EV charger application
                    10'd330: data_o = 32'h0257c663; // grid-aware EV charger application
                    10'd331: data_o = 32'h030782b3; // grid-aware EV charger application
                    10'd332: data_o = 32'h005989b3; // grid-aware EV charger application
                    10'd333: data_o = 32'h0ff00293; // grid-aware EV charger application
                    10'd334: data_o = 32'h085a0863; // grid-aware EV charger application
                    10'd335: data_o = 32'h001a0a13; // grid-aware EV charger application
                    10'd336: data_o = 32'h0880006f; // grid-aware EV charger application
                    10'd337: data_o = 32'h02000293; // grid-aware EV charger application
                    10'd338: data_o = 32'h005aeab3; // grid-aware EV charger application
                    10'd339: data_o = 32'hc4dff0ef; // grid-aware EV charger application
                    10'd340: data_o = 32'h0780006f; // grid-aware EV charger application
                    10'd341: data_o = 32'h08000293; // grid-aware EV charger application
                    10'd342: data_o = 32'h005aeab3; // grid-aware EV charger application
                    10'd343: data_o = 32'h00100293; // grid-aware EV charger application
                    10'd344: data_o = 32'h80328333; // grid-aware EV charger application
                    10'd345: data_o = 32'h00000293; // grid-aware EV charger application
                    10'd346: data_o = 32'h80628333; // grid-aware EV charger application
                    10'd347: data_o = 32'h05900293; // grid-aware EV charger application
                    10'd348: data_o = 32'h80628333; // grid-aware EV charger application
                    10'd349: data_o = 32'h04d00293; // grid-aware EV charger application
                    10'd350: data_o = 32'h80628333; // grid-aware EV charger application
                    10'd351: data_o = 32'h00737313; // grid-aware EV charger application
                    10'd352: data_o = 32'h00230c13; // grid-aware EV charger application
                    10'd353: data_o = 32'h00000b93; // grid-aware EV charger application
                    10'd354: data_o = 32'h00300513; // grid-aware EV charger application
                    10'd355: data_o = 32'hc29ff0ef; // grid-aware EV charger application
                    10'd356: data_o = 32'h0380006f; // grid-aware EV charger application
                    10'd357: data_o = 32'h000012b7; // grid-aware EV charger application
                    10'd358: data_o = 32'h35628293; // grid-aware EV charger application
                    10'd359: data_o = 32'h0258c263; // grid-aware EV charger application
                    10'd360: data_o = 32'h000012b7; // grid-aware EV charger application
                    10'd361: data_o = 32'h81628293; // grid-aware EV charger application
                    10'd362: data_o = 32'h0057cc63; // grid-aware EV charger application
                    10'd363: data_o = 32'h001b8b93; // grid-aware EV charger application
                    10'd364: data_o = 32'h018bcc63; // grid-aware EV charger application
                    10'd365: data_o = 32'h00200513; // grid-aware EV charger application
                    10'd366: data_o = 32'hbfdff0ef; // grid-aware EV charger application
                    10'd367: data_o = 32'h00c0006f; // grid-aware EV charger application
                    10'd368: data_o = 32'h00000b93; // grid-aware EV charger application
                    10'd369: data_o = 32'h0040006f; // grid-aware EV charger application
                    10'd370: data_o = 32'h000f0093; // grid-aware EV charger application
                    10'd371: data_o = 32'h00008067; // grid-aware EV charger application
                    default: data_o = 32'h0000006f; // j . (park)
                endcase
            end else if (FIRMWARE == 6) begin
                // FIRMWARE 6: crcb vs software CRC-16 cycle bench
                case (addr_i[9:0])
                    10'd0: data_o = 32'h00100213; // addi x4,x0,1
                    10'd1: data_o = 32'h00010337; // lui x6,0x10
                    10'd2: data_o = 32'hfff30313; // addi x6,x6,-1
                    10'd3: data_o = 32'h0fc00293; // addi x5,x0,252
                    10'd4: data_o = 32'h80628333; // crcb x6,x5,x6
                    10'd5: data_o = 32'h00800293; // addi x5,x0,8
                    10'd6: data_o = 32'h80628333; // crcb x6,x5,x6
                    10'd7: data_o = 32'h0a000293; // addi x5,x0,160
                    10'd8: data_o = 32'h80628333; // crcb x6,x5,x6
                    10'd9: data_o = 32'h00000293; // addi x5,x0,0
                    10'd10: data_o = 32'h80628333; // crcb x6,x5,x6
                    10'd11: data_o = 32'h08800293; // addi x5,x0,136
                    10'd12: data_o = 32'h80628333; // crcb x6,x5,x6
                    10'd13: data_o = 32'h01300293; // addi x5,x0,19
                    10'd14: data_o = 32'h80628333; // crcb x6,x5,x6
                    10'd15: data_o = 32'h00200213; // addi x4,x0,2
                    10'd16: data_o = 32'h000103b7; // lui x7,0x10
                    10'd17: data_o = 32'hfff38393; // addi x7,x7,-1
                    10'd18: data_o = 32'h00001537; // lui x10,0x1
                    10'd19: data_o = 32'h02150513; // addi x10,x10,33
                    10'd20: data_o = 32'h0fc00293; // addi x5,x0,252
                    10'd21: data_o = 32'h00829293; // slli x5,x5,8
                    10'd22: data_o = 32'h0053c3b3; // xor x7,x7,x5
                    10'd23: data_o = 32'h00800593; // addi x11,x0,8
                    10'd24: data_o = 32'h00139393; // slli x7,x7,1
                    10'd25: data_o = 32'h0103d613; // srli x12,x7,16
                    10'd26: data_o = 32'h00167613; // andi x12,x12,1
                    10'd27: data_o = 32'h00060463; // beq x12,x0,sw_skip0
                    10'd28: data_o = 32'h00a3c3b3; // xor x7,x7,x10
                    10'd29: data_o = 32'hfff58593; // addi x11,x11,-1
                    10'd30: data_o = 32'hfe0594e3; // bne x11,x0,sw_bit0
                    10'd31: data_o = 32'h00800293; // addi x5,x0,8
                    10'd32: data_o = 32'h00829293; // slli x5,x5,8
                    10'd33: data_o = 32'h0053c3b3; // xor x7,x7,x5
                    10'd34: data_o = 32'h00800593; // addi x11,x0,8
                    10'd35: data_o = 32'h00139393; // slli x7,x7,1
                    10'd36: data_o = 32'h0103d613; // srli x12,x7,16
                    10'd37: data_o = 32'h00167613; // andi x12,x12,1
                    10'd38: data_o = 32'h00060463; // beq x12,x0,sw_skip1
                    10'd39: data_o = 32'h00a3c3b3; // xor x7,x7,x10
                    10'd40: data_o = 32'hfff58593; // addi x11,x11,-1
                    10'd41: data_o = 32'hfe0594e3; // bne x11,x0,sw_bit1
                    10'd42: data_o = 32'h0a000293; // addi x5,x0,160
                    10'd43: data_o = 32'h00829293; // slli x5,x5,8
                    10'd44: data_o = 32'h0053c3b3; // xor x7,x7,x5
                    10'd45: data_o = 32'h00800593; // addi x11,x0,8
                    10'd46: data_o = 32'h00139393; // slli x7,x7,1
                    10'd47: data_o = 32'h0103d613; // srli x12,x7,16
                    10'd48: data_o = 32'h00167613; // andi x12,x12,1
                    10'd49: data_o = 32'h00060463; // beq x12,x0,sw_skip2
                    10'd50: data_o = 32'h00a3c3b3; // xor x7,x7,x10
                    10'd51: data_o = 32'hfff58593; // addi x11,x11,-1
                    10'd52: data_o = 32'hfe0594e3; // bne x11,x0,sw_bit2
                    10'd53: data_o = 32'h00000293; // addi x5,x0,0
                    10'd54: data_o = 32'h00829293; // slli x5,x5,8
                    10'd55: data_o = 32'h0053c3b3; // xor x7,x7,x5
                    10'd56: data_o = 32'h00800593; // addi x11,x0,8
                    10'd57: data_o = 32'h00139393; // slli x7,x7,1
                    10'd58: data_o = 32'h0103d613; // srli x12,x7,16
                    10'd59: data_o = 32'h00167613; // andi x12,x12,1
                    10'd60: data_o = 32'h00060463; // beq x12,x0,sw_skip3
                    10'd61: data_o = 32'h00a3c3b3; // xor x7,x7,x10
                    10'd62: data_o = 32'hfff58593; // addi x11,x11,-1
                    10'd63: data_o = 32'hfe0594e3; // bne x11,x0,sw_bit3
                    10'd64: data_o = 32'h08800293; // addi x5,x0,136
                    10'd65: data_o = 32'h00829293; // slli x5,x5,8
                    10'd66: data_o = 32'h0053c3b3; // xor x7,x7,x5
                    10'd67: data_o = 32'h00800593; // addi x11,x0,8
                    10'd68: data_o = 32'h00139393; // slli x7,x7,1
                    10'd69: data_o = 32'h0103d613; // srli x12,x7,16
                    10'd70: data_o = 32'h00167613; // andi x12,x12,1
                    10'd71: data_o = 32'h00060463; // beq x12,x0,sw_skip4
                    10'd72: data_o = 32'h00a3c3b3; // xor x7,x7,x10
                    10'd73: data_o = 32'hfff58593; // addi x11,x11,-1
                    10'd74: data_o = 32'hfe0594e3; // bne x11,x0,sw_bit4
                    10'd75: data_o = 32'h01300293; // addi x5,x0,19
                    10'd76: data_o = 32'h00829293; // slli x5,x5,8
                    10'd77: data_o = 32'h0053c3b3; // xor x7,x7,x5
                    10'd78: data_o = 32'h00800593; // addi x11,x0,8
                    10'd79: data_o = 32'h00139393; // slli x7,x7,1
                    10'd80: data_o = 32'h0103d613; // srli x12,x7,16
                    10'd81: data_o = 32'h00167613; // andi x12,x12,1
                    10'd82: data_o = 32'h00060463; // beq x12,x0,sw_skip5
                    10'd83: data_o = 32'h00a3c3b3; // xor x7,x7,x10
                    10'd84: data_o = 32'hfff58593; // addi x11,x11,-1
                    10'd85: data_o = 32'hfe0594e3; // bne x11,x0,sw_bit5
                    10'd86: data_o = 32'h000102b7; // lui x5,0x10
                    10'd87: data_o = 32'hfff28293; // addi x5,x5,-1
                    10'd88: data_o = 32'h0053f3b3; // and x7,x7,x5
                    10'd89: data_o = 32'h00300213; // addi x4,x0,3
                    10'd90: data_o = 32'h01031293; // slli x5,x6,16
                    10'd91: data_o = 32'h0072e233; // or x4,x5,x7
                    10'd92: data_o = 32'h0000006f; // jal x0,park
                    default: data_o = 32'h0000006f; // j . (park)
                endcase
            end else begin
                // FIRMWARE 0: official Stage 2 validation firmware
                case (addr_i[9:0])
                    10'd0: data_o = 32'h123452B7;
                    10'd1: data_o = 32'h12345337;
                    10'd2: data_o = 32'h3E629463;
                    10'd3: data_o = 32'h00001297;
                    10'd4: data_o = 32'h3E028063;
                    10'd5: data_o = 32'h00A00293;
                    10'd6: data_o = 32'hFFD28313;
                    10'd7: data_o = 32'h00700393;
                    10'd8: data_o = 32'h3C731863;
                    10'd9: data_o = 32'h006283B3;
                    10'd10: data_o = 32'h01100E13;
                    10'd11: data_o = 32'h3DC39263;
                    10'd12: data_o = 32'h405E03B3;
                    10'd13: data_o = 32'h3A639E63;
                    10'd14: data_o = 32'h0FF00293;
                    10'd15: data_o = 32'h0F02C313;
                    10'd16: data_o = 32'h00F00393;
                    10'd17: data_o = 32'h3A731663;
                    10'd18: data_o = 32'h7002E313;
                    10'd19: data_o = 32'h7FF00393;
                    10'd20: data_o = 32'h3A731063;
                    10'd21: data_o = 32'h0F02F313;
                    10'd22: data_o = 32'h0F000393;
                    10'd23: data_o = 32'h38731A63;
                    10'd24: data_o = 32'h0AA00293;
                    10'd25: data_o = 32'h05500313;
                    10'd26: data_o = 32'h0062C3B3;
                    10'd27: data_o = 32'h0FF00E13;
                    10'd28: data_o = 32'h39C39063;
                    10'd29: data_o = 32'h0062E3B3;
                    10'd30: data_o = 32'h37C39C63;
                    10'd31: data_o = 32'h0062F3B3;
                    10'd32: data_o = 32'h36039863;
                    10'd33: data_o = 32'h00100293;
                    10'd34: data_o = 32'h00429313;
                    10'd35: data_o = 32'h01000393;
                    10'd36: data_o = 32'h36731063;
                    10'd37: data_o = 32'h0023D313;
                    10'd38: data_o = 32'h00400E13;
                    10'd39: data_o = 32'h35C31A63;
                    10'd40: data_o = 32'hFF000293;
                    10'd41: data_o = 32'h4022D313;
                    10'd42: data_o = 32'hFFC00393;
                    10'd43: data_o = 32'h34731263;
                    10'd44: data_o = 32'h00100293;
                    10'd45: data_o = 32'h00400313;
                    10'd46: data_o = 32'h006293B3;
                    10'd47: data_o = 32'h01000E13;
                    10'd48: data_o = 32'h33C39863;
                    10'd49: data_o = 32'h00200313;
                    10'd50: data_o = 32'h006E53B3;
                    10'd51: data_o = 32'h00400E93;
                    10'd52: data_o = 32'h33D39063;
                    10'd53: data_o = 32'hFF000293;
                    10'd54: data_o = 32'h4062D3B3;
                    10'd55: data_o = 32'hFFC00E93;
                    10'd56: data_o = 32'h31D39863;
                    10'd57: data_o = 32'h00A00293;
                    10'd58: data_o = 32'h0142A313;
                    10'd59: data_o = 32'h00100393;
                    10'd60: data_o = 32'h30731063;
                    10'd61: data_o = 32'hFF600293;
                    10'd62: data_o = 32'h0142B313;
                    10'd63: data_o = 32'h2E031A63;
                    10'd64: data_o = 32'h00A00293;
                    10'd65: data_o = 32'h01400313;
                    10'd66: data_o = 32'h0062A3B3;
                    10'd67: data_o = 32'h00100E13;
                    10'd68: data_o = 32'h2FC39063;
                    10'd69: data_o = 32'h005333B3;
                    10'd70: data_o = 32'h2C039C63;
                    10'd71: data_o = 32'h0FC10417;
                    10'd72: data_o = 32'hEE440413;
                    10'd73: data_o = 32'h12345337;
                    10'd74: data_o = 32'h67830313;
                    10'd75: data_o = 32'h00642023;
                    10'd76: data_o = 32'h0000B3B7;
                    10'd77: data_o = 32'hABB38393;
                    10'd78: data_o = 32'h00741223;
                    10'd79: data_o = 32'h0CC00E13;
                    10'd80: data_o = 32'h01C40423;
                    10'd81: data_o = 32'h00042E83;
                    10'd82: data_o = 32'h2A6E9463;
                    10'd83: data_o = 32'h00441F03;
                    10'd84: data_o = 32'hFFFFBFB7;
                    10'd85: data_o = 32'hABBF8F93;
                    10'd86: data_o = 32'h29FF1C63;
                    10'd87: data_o = 32'h00445F03;
                    10'd88: data_o = 32'h0000BFB7;
                    10'd89: data_o = 32'hABBF8F93;
                    10'd90: data_o = 32'h29FF1463;
                    10'd91: data_o = 32'h00840F03;
                    10'd92: data_o = 32'hFCC00F93;
                    10'd93: data_o = 32'h27FF1E63;
                    10'd94: data_o = 32'h00844F03;
                    10'd95: data_o = 32'h0CC00F93;
                    10'd96: data_o = 32'h27FF1863;
                    10'd97: data_o = 32'h00500293;
                    10'd98: data_o = 32'h00A00313;
                    10'd99: data_o = 32'h00500393;
                    10'd100: data_o = 32'hFF600E13;
                    10'd101: data_o = 32'hFF600E93;
                    10'd102: data_o = 32'h00728463;
                    10'd103: data_o = 32'h2540006F;
                    10'd104: data_o = 32'h01DE0463;
                    10'd105: data_o = 32'h24C0006F;
                    10'd106: data_o = 32'h00629463;
                    10'd107: data_o = 32'h2440006F;
                    10'd108: data_o = 32'h01C29463;
                    10'd109: data_o = 32'h23C0006F;
                    10'd110: data_o = 32'h0062C463;
                    10'd111: data_o = 32'h2340006F;
                    10'd112: data_o = 32'h005E4463;
                    10'd113: data_o = 32'h22C0006F;
                    10'd114: data_o = 32'h00535463;
                    10'd115: data_o = 32'h2240006F;
                    10'd116: data_o = 32'h01C2D463;
                    10'd117: data_o = 32'h21C0006F;
                    10'd118: data_o = 32'h0062E463;
                    10'd119: data_o = 32'h2140006F;
                    10'd120: data_o = 32'h01C2E463;
                    10'd121: data_o = 32'h20C0006F;
                    10'd122: data_o = 32'h00537463;
                    10'd123: data_o = 32'h2040006F;
                    10'd124: data_o = 32'h005E7463;
                    10'd125: data_o = 32'h1FC0006F;
                    10'd126: data_o = 32'h00800F6F;
                    10'd127: data_o = 32'h1F40006F;
                    10'd128: data_o = 32'h00000F97;
                    10'd129: data_o = 32'h010F8F93;
                    10'd130: data_o = 32'h000F8067;
                    10'd131: data_o = 32'h1E40006F;
                    10'd132: data_o = 32'h00100013;
                    10'd133: data_o = 32'h1C001E63;
                    10'd134: data_o = 32'hDEADC2B7;
                    10'd135: data_o = 32'hEEF28293;
                    10'd136: data_o = 32'h00028313;
                    10'd137: data_o = 32'h00030393;
                    10'd138: data_o = 32'h00038F93;
                    10'd139: data_o = 32'hDEADC2B7;
                    10'd140: data_o = 32'hEEF28293;
                    10'd141: data_o = 32'h1A5F9E63;
                    10'd142: data_o = 32'h000185B7;
                    10'd143: data_o = 32'h6A058593;
                    10'd144: data_o = 32'h00200613;
                    10'd145: data_o = 32'hEE6B36B7;
                    10'd146: data_o = 32'h80068693;
                    10'd147: data_o = 32'h000312B7;
                    10'd148: data_o = 32'hD4028293;
                    10'd149: data_o = 32'hDCD65337;
                    10'd150: data_o = 32'hFFF00393;
                    10'd151: data_o = 32'h00100E13;
                    10'd152: data_o = 32'h02C58533;
                    10'd153: data_o = 32'h18551663;
                    10'd154: data_o = 32'h02C68533;
                    10'd155: data_o = 32'h18651263;
                    10'd156: data_o = 32'h02C59533;
                    10'd157: data_o = 32'h16051E63;
                    10'd158: data_o = 32'h02C69533;
                    10'd159: data_o = 32'h16751A63;
                    10'd160: data_o = 32'h02C6B533;
                    10'd161: data_o = 32'h17C51663;
                    10'd162: data_o = 32'h02C6A533;
                    10'd163: data_o = 32'h16751263;
                    10'd164: data_o = 32'h02D62533;
                    10'd165: data_o = 32'h15C51E63;
                    10'd166: data_o = 32'h000028B7;
                    10'd167: data_o = 32'hE8288893;
                    10'd168: data_o = 32'h00010437;
                    10'd169: data_o = 32'hFFF40413;
                    10'd170: data_o = 32'h01200493;
                    10'd171: data_o = 32'h03400913;
                    10'd172: data_o = 32'h05600993;
                    10'd173: data_o = 32'h07800A13;
                    10'd174: data_o = 32'h09000A93;
                    10'd175: data_o = 32'h0AB00B13;
                    10'd176: data_o = 32'h0CD00B93;
                    10'd177: data_o = 32'h0EF00C13;
                    10'd178: data_o = 32'h80848433;
                    10'd179: data_o = 32'h80890433;
                    10'd180: data_o = 32'h80898433;
                    10'd181: data_o = 32'h808A0433;
                    10'd182: data_o = 32'h808A8433;
                    10'd183: data_o = 32'h808B0433;
                    10'd184: data_o = 32'h808B8433;
                    10'd185: data_o = 32'h808C0433;
                    10'd186: data_o = 32'h11141463;
                    10'd187: data_o = 32'h000102B7;
                    10'd188: data_o = 32'hFFF28293;
                    10'd189: data_o = 32'h00001337;
                    10'd190: data_o = 32'h23430313;
                    10'd191: data_o = 32'h000053B7;
                    10'd192: data_o = 32'h67838393;
                    10'd193: data_o = 32'h00009E37;
                    10'd194: data_o = 32'h0ABE0E13;
                    10'd195: data_o = 32'h0000DEB7;
                    10'd196: data_o = 32'hDEFE8E93;
                    10'd197: data_o = 32'h805312B3;
                    10'd198: data_o = 32'h805392B3;
                    10'd199: data_o = 32'h805E12B3;
                    10'd200: data_o = 32'h805E92B3;
                    10'd201: data_o = 32'h0D129663;
                    10'd202: data_o = 32'h00010537;
                    10'd203: data_o = 32'hFFF50513;
                    10'd204: data_o = 32'h123455B7;
                    10'd205: data_o = 32'h67858593;
                    10'd206: data_o = 32'h90ABD637;
                    10'd207: data_o = 32'hDEF60613;
                    10'd208: data_o = 32'h80A5A533;
                    10'd209: data_o = 32'h80A62533;
                    10'd210: data_o = 32'h0B151463;
                    10'd211: data_o = 32'h00000297;
                    10'd212: data_o = 32'h0AC28293;
                    10'd213: data_o = 32'h0002A303;
                    10'd214: data_o = 32'h0042A383;
                    10'd215: data_o = 32'h00010537;
                    10'd216: data_o = 32'hFFF50513;
                    10'd217: data_o = 32'h80A32533;
                    10'd218: data_o = 32'h80A3A533;
                    10'd219: data_o = 32'h000028B7;
                    10'd220: data_o = 32'hE8288893;
                    10'd221: data_o = 32'h07151E63;
                    10'd222: data_o = 32'h01400293;
                    10'd223: data_o = 32'h00A00313;
                    10'd224: data_o = 32'h006283B3;
                    10'd225: data_o = 32'h40628E33;
                    10'd226: data_o = 32'h03C38EB3;
                    10'd227: data_o = 32'h12C00F13;
                    10'd228: data_o = 32'h07EE9063;
                    10'd229: data_o = 32'h00000297;
                    10'd230: data_o = 32'h06C28293;
                    10'd231: data_o = 32'h0FC10317;
                    10'd232: data_o = 32'hC7430313;
                    10'd233: data_o = 32'h00300393;
                    10'd234: data_o = 32'h0002AE03;
                    10'd235: data_o = 32'h01C32023;
                    10'd236: data_o = 32'h00428293;
                    10'd237: data_o = 32'h00430313;
                    10'd238: data_o = 32'hFFF38393;
                    10'd239: data_o = 32'hFE0396E3;
                    10'd240: data_o = 32'h0FC10317;
                    10'd241: data_o = 32'hC5030313;
                    10'd242: data_o = 32'h00032E03;
                    10'd243: data_o = 32'h11111EB7;
                    10'd244: data_o = 32'h111E8E93;
                    10'd245: data_o = 32'h01DE1E63;
                    10'd246: data_o = 32'h00832E03;
                    10'd247: data_o = 32'h33333EB7;
                    10'd248: data_o = 32'h333E8E93;
                    10'd249: data_o = 32'h01DE1663;
                    10'd250: data_o = 32'h00000213;
                    10'd251: data_o = 32'h0000006F;
                    10'd252: data_o = 32'hFFF00213;
                    10'd253: data_o = 32'h0000006F;
                    10'd254: data_o = 32'h12345678;
                    10'd255: data_o = 32'h90ABCDEF;
                    10'd256: data_o = 32'h11111111;
                    10'd257: data_o = 32'h22222222;
                    10'd258: data_o = 32'h33333333;
                    default: data_o = 32'h00000013; // NOP (addi x0, x0, 0)
                endcase
            end
        end
    end
endmodule



//  ---------- INLCUDED BLOCK: dmem_eq26  ----------
// Data memory (registered read).
module dmem_eq26 #(
    parameter DEPTH_WORDS = 8
) (
    input  wire        clk_i,
    input  wire         rst_i,
    input  wire [31:0] addr_i,   // word address
    input  wire        we_i,
    input  wire        oe_i,
    input  wire [3:0]  bw_i,     // byte write mask
    input  wire [31:0] data_i,
    output reg  [31:0] data_o    // registered — see timing note above
);

    localparam IDX_W = $clog2(DEPTH_WORDS);

    reg [31:0] mem [0:DEPTH_WORDS-1];

    wire [IDX_W-1:0] index = addr_i[IDX_W-1:0];

    always @(posedge clk_i) begin
        if (rst_i) begin
            data_o <= 32'b0;
        end else begin
            if (we_i) begin
                if (bw_i[0]) mem[index][ 7: 0] <= data_i[ 7: 0];
                if (bw_i[1]) mem[index][15: 8] <= data_i[15: 8];
                if (bw_i[2]) mem[index][23:16] <= data_i[23:16];
                if (bw_i[3]) mem[index][31:24] <= data_i[31:24];
            end
            if (oe_i) begin
                data_o <= mem[index]; // registered read, NOT combinational
            end
        end
    end

endmodule



//  ---------- INLCUDED BLOCK: address_decoder  ----------
// Memory address decoder.
// Memory address decoder.

// Memory address decoder.

module address_decoder (
    input  wire [31:0] address_i,
    input  wire        we_i,
    input  wire        oe_i,
    input  wire [3:0]  bw_i,

    input  wire [31:0] dmem_data_i,
    input  wire [31:0] imem_data_i,
    input  wire [31:0] gpio_data_i,
    input  wire [31:0] uart_data_i,
    input  wire [31:0] timer_data_i,
    output wire timer_we_o, timer_oe_o,

    output wire [31:0] address_o,     // word address (zero-extended)
    output wire        dmem_we_o,
    output wire        dmem_oe_o,
    output wire        imem_oe_o,
    output wire        uart_we_o,
    output wire        uart_oe_o,
    output wire        gpio_we_o,
    output wire        gpio_oe_o,
    output wire [3:0]  bw_o,
    output reg  [31:0] data_o
);

    // Memory Map Base Addresses (Guide Table 13)
    localparam [31:0] IMEM_BASE = 32'h0040_0000;
    localparam [31:0] DMEM_BASE = 32'h1001_0000;

    localparam [31:0] IMEM_LOW  = IMEM_BASE;
    localparam [31:0] IMEM_HIGH = IMEM_BASE + 32'h0040_0000 - 1; // +4MB
    localparam [31:0] DMEM_LOW  = DMEM_BASE;
    localparam [31:0] DMEM_HIGH = DMEM_BASE + 32'h0000_2000 - 1; // +8kB

    // Stage 3 GPIO registers; low two byte-address bits are ignored.
    wire is_gpio = (address_i[31:4] == 28'hF000000) &&
                   (address_i[3:2] != 2'b11);

    wire is_uart = (address_i[31:4] == 28'hF100000) &&
                   (address_i[3:2] != 2'b11);

    wire is_timer = (address_i[31:3] == (32'hF2000000 >> 3));
    assign timer_we_o = we_i && is_timer && (bw_i == 4'b1111);
    assign timer_oe_o = oe_i && is_timer;

    wire is_imem = (address_i >= IMEM_LOW) && (address_i <= IMEM_HIGH);
    wire is_dmem = (address_i >= DMEM_LOW) && (address_i <= DMEM_HIGH);

  	assign address_o = {2'b00, address_i[31:2]};// zeroextending

    assign uart_we_o = we_i && is_uart;
    assign uart_oe_o = oe_i && is_uart;

    assign gpio_we_o = we_i && is_gpio;
    assign gpio_oe_o = oe_i && is_gpio;

    assign dmem_we_o = we_i && is_dmem;
    assign dmem_oe_o = oe_i && is_dmem;
    assign imem_oe_o = oe_i && is_imem;
    assign bw_o      = is_dmem ? bw_i : 4'b0000;

    always @(*) begin
        data_o = 32'b0; // default: unmapped address, guide silent (see header note)
        if (is_gpio)
            data_o = gpio_data_i;
        else if (is_uart)
            data_o = uart_data_i;
        else if (is_timer)
            data_o = timer_data_i;
        else if (is_dmem)
            data_o = dmem_data_i;
        else if (is_imem)
            data_o = imem_data_i;
    end

endmodule



//  ---------- INLCUDED BLOCK: control_unit_eq26  ---------- 
// Multicycle FSM control unit.

// Opcodes (IR[6:0])
`define OPCODE_RTYPE   7'b0110011
`define OPCODE_ITYPE   7'b0010011
`define OPCODE_LOAD    7'b0000011
`define OPCODE_STORE   7'b0100011
`define OPCODE_BRANCH  7'b1100011
`define OPCODE_JAL     7'b1101111
`define OPCODE_JALR    7'b1100111
`define OPCODE_LUI     7'b0110111
`define OPCODE_AUIPC   7'b0010111
`define OPCODE_SYSTEM  7'b1110011
`define OPCODE_FENCE   7'b0001111

// funct12 / funct7 disambiguation
`define FUNCT12_ECALL  12'h000
`define FUNCT12_EBREAK 12'h001
`define FUNCT7_MUL     7'b0000001
`define FUNCT7_CRC     7'b1000000

// alu_op — Table 9
`define ALU_PASS_B     4'h0
`define ALU_ADD        4'h1
`define ALU_SUB        4'h2
`define ALU_AND        4'h3
`define ALU_OR         4'h4
`define ALU_XOR        4'h5
`define ALU_SLL        4'h6
`define ALU_SRL        4'h7
`define ALU_MRS        4'h8
`define ALU_SLT        4'h9
`define ALU_SLTU       4'hA

// mult_op_o (Table 10) & crc_op_o (Table 11)
`define MULT_MUL       4'h0
`define MULT_MULH      4'h1
`define MULT_MULHSU    4'h2
`define MULT_MULHU     4'h3

`define CRC_CRCB       4'h0
`define CRC_CRCH       4'h1
`define CRC_CRCW       4'h2

// Mux select lines
`define RESULT_SRC_ALU   3'b000
`define RESULT_SRC_MUL   3'b001
`define RESULT_SRC_CRC   3'b010
`define RESULT_SRC_MEM   3'b011
`define RESULT_SRC_PC4   3'b100

`define PC_SRC_PLUS4     2'b00
`define PC_SRC_TARGET    2'b01
`define PC_SRC_JALR      2'b10

`define ALU_SRC_A_RS1    1'b0
`define ALU_SRC_A_PC     1'b1

`define ALU_SRC_B_RS2    2'b00
`define ALU_SRC_B_IMM    2'b01
`define ALU_SRC_B_CONST4 2'b10

`define ADR_SRC_PC       1'b0
`define ADR_SRC_ALU      1'b1

// Memory map (Table 13)
`define PC_RESET_ADDR    32'h00400000
`define IMEM_BASE        32'h00400000
`define DMEM_BASE        32'h10010000

// op_size_o & imm_sel_o
`define OP_SIZE_BYTE_S   3'b000
`define OP_SIZE_BYTE_U   3'b001
`define OP_SIZE_HALF_S   3'b010
`define OP_SIZE_HALF_U   3'b011
`define OP_SIZE_WORD     3'b100

`define IMM_SEL_I        3'b000
`define IMM_SEL_S        3'b001
`define IMM_SEL_B        3'b010
`define IMM_SEL_U        3'b011
`define IMM_SEL_J        3'b100

module control_unit_eq26(
    input  wire        clk_i,
    input  wire        rst_i,

    // Decode fields
    input  wire [6:0]  opcode_i,
    input  wire [2:0]  funct3_i,
    input  wire [6:0]  funct7_i,
    input  wire [11:0] funct12_i,

    input  wire [1:0]  addr_lsb_i,
    input  wire        branch_taken_i,

    // Datapath control
    output reg         pc_write_o,
    output reg  [1:0]  pc_src_o,
    output reg         ir_write_o,
    output reg         reg_write_o,
    output reg  [2:0]  result_src_o,
    output reg         alu_src_a_o,
    output reg  [1:0]  alu_src_b_o,
    output reg  [3:0]  alu_op_o,
    output reg  [2:0]  imm_sel_o,
    output reg  [3:0]  mult_op_o,
    output reg  [3:0]  crc_op_o,
    output reg         mult_en_o,
    output reg         crc_en_o,

    // Memory interface
    output reg         we_o,
    output reg         oe_o,
    output reg  [3:0]  bw_o,
    output reg  [2:0]  op_size_o,
    output reg         adr_src_o,

    // Status
    output reg         halt_o,

    // Derived enables
    output wire        not_adr_src_o,
    output wire        result_src_is_mem_o
);

    assign not_adr_src_o       = !adr_src_o;
    assign result_src_is_mem_o = (result_src_o == `RESULT_SRC_MEM);

    // State encoding
    localparam [3:0] RESET             = 4'd0;
    localparam [3:0] FETCH             = 4'd1;
    localparam [3:0] DECODE            = 4'd2;
    localparam [3:0] EXECUTE_ALU       = 4'd3;
    localparam [3:0] WRITE_BACK        = 4'd4;
    localparam [3:0] MEM_ADDR          = 4'd5;
    localparam [3:0] MEM_ACCESS_ADDR   = 4'd6;
    localparam [3:0] MEM_ACCESS_DATA   = 4'd7;
    localparam [3:0] MEM_ACCESS_STORE  = 4'd8;

    reg [3:0] state, next_state;

    // Tracks state for WRITE_BACK's result_src_o
    reg [3:0] prev_state;

    // State register
    always @(posedge clk_i) begin
        if (rst_i) begin
            state      <= RESET;
            prev_state <= RESET;
        end else begin
            prev_state <= state;
            state      <= next_state;
        end
    end

    // Sticky ECALL status flag
    wire is_ecall = (opcode_i  == `OPCODE_SYSTEM) &&
                    (funct3_i  == 3'b000)         &&
                    (funct12_i == `FUNCT12_ECALL);

    always @(posedge clk_i) begin
        if (rst_i) begin
            halt_o <= 1'b0;
        end else if ((state == EXECUTE_ALU) && is_ecall) begin
            halt_o <= 1'b1;
        end
    end

    // Illegal-opcode detection
    wire opcode_legal = (opcode_i == `OPCODE_RTYPE)  ||
                        (opcode_i == `OPCODE_ITYPE)  ||
                        (opcode_i == `OPCODE_LOAD)   ||
                        (opcode_i == `OPCODE_STORE)  ||
                        (opcode_i == `OPCODE_BRANCH) ||
                        (opcode_i == `OPCODE_JAL)    ||
                        (opcode_i == `OPCODE_JALR)   ||
                        (opcode_i == `OPCODE_LUI)    ||
                        (opcode_i == `OPCODE_AUIPC)  ||
                        (opcode_i == `OPCODE_SYSTEM) ||
                        (opcode_i == `OPCODE_FENCE);

    // Next-state logic
    always @(*) begin
        next_state = state;
        case (state)
            RESET:  next_state = FETCH;
            FETCH:  next_state = DECODE;

            DECODE: begin
                if (opcode_i == `OPCODE_LOAD || opcode_i == `OPCODE_STORE)
                    next_state = MEM_ADDR;
                else
                    next_state = EXECUTE_ALU;
            end

            EXECUTE_ALU: begin
                if (opcode_i == `OPCODE_BRANCH ||
                    opcode_i == `OPCODE_SYSTEM ||
                    opcode_i == `OPCODE_FENCE  ||
                    !opcode_legal)
                    next_state = FETCH;
                else
                    next_state = WRITE_BACK;
            end

            WRITE_BACK:  next_state = FETCH;

            MEM_ADDR: begin
                if (opcode_i == `OPCODE_STORE)
                    next_state = MEM_ACCESS_STORE;
                else
                    next_state = MEM_ACCESS_ADDR;
            end

            MEM_ACCESS_ADDR: next_state = MEM_ACCESS_DATA;
            MEM_ACCESS_DATA: next_state = WRITE_BACK;
            MEM_ACCESS_STORE: next_state = FETCH;

            default: next_state = RESET;
        endcase
    end

    // Output logic
    // funct3 -> op_size_o lookup
    reg [2:0] op_size_lookup;
    always @(*) begin
        case (funct3_i)
            3'b000:  op_size_lookup = `OP_SIZE_BYTE_S;
            3'b001:  op_size_lookup = `OP_SIZE_HALF_S;
            3'b010:  op_size_lookup = `OP_SIZE_WORD;
            3'b100:  op_size_lookup = `OP_SIZE_BYTE_U;
            3'b101:  op_size_lookup = `OP_SIZE_HALF_U;
            default: op_size_lookup = `OP_SIZE_WORD;
        endcase
    end

    // Byte-write mask lookup
    reg [3:0] bw_lookup;
    always @(*) begin
        case (op_size_lookup[2:1])
            2'b10: bw_lookup = 4'b1111;
            2'b01: bw_lookup = addr_lsb_i[1] ? 4'b1100 : 4'b0011;
            2'b00: bw_lookup = 4'b0001 << addr_lsb_i;
            default: bw_lookup = 4'b1111;
        endcase
    end

    always @(*) begin
        // Defaults
        pc_write_o   = 1'b0;
        pc_src_o     = `PC_SRC_PLUS4;
        ir_write_o   = 1'b0;
        reg_write_o  = 1'b0;
        result_src_o = `RESULT_SRC_ALU;
        alu_src_a_o  = `ALU_SRC_A_RS1;
        alu_src_b_o  = `ALU_SRC_B_RS2;
        alu_op_o     = `ALU_PASS_B;
        imm_sel_o    = `IMM_SEL_I;
        mult_op_o      = 4'h0;
        crc_op_o       = 4'h0;
        mult_en_o    = 1'b0;
        crc_en_o     = 1'b0;
        we_o         = 1'b0;
        oe_o         = 1'b0;
        bw_o         = 4'b0000;
        op_size_o    = `OP_SIZE_WORD;
        adr_src_o    = `ADR_SRC_PC;

        case (state)
            RESET: begin
            end

            FETCH: begin
                pc_write_o = 1'b1;
                ir_write_o = 1'b1;
                oe_o       = 1'b1;
            end

            DECODE: begin
                // imm_sel_o per opcode
                if (opcode_i == `OPCODE_LOAD)
                    imm_sel_o = `IMM_SEL_I;
                else if (opcode_i == `OPCODE_STORE)
                    imm_sel_o = `IMM_SEL_S;
                else if (opcode_i == `OPCODE_BRANCH)
                    imm_sel_o = `IMM_SEL_B;
                else if (opcode_i == `OPCODE_JAL)
                    imm_sel_o = `IMM_SEL_J;
                else if (opcode_i == `OPCODE_JALR)
                    imm_sel_o = `IMM_SEL_I;
                else if (opcode_i == `OPCODE_LUI || opcode_i == `OPCODE_AUIPC)
                    imm_sel_o = `IMM_SEL_U;
                else if (opcode_i == `OPCODE_ITYPE)
                    imm_sel_o = `IMM_SEL_I;
                else
                    imm_sel_o = `IMM_SEL_I;
            end

            EXECUTE_ALU: begin
                if (opcode_i == `OPCODE_BRANCH) begin
                    // Branch
                    pc_write_o   = branch_taken_i;
                    pc_src_o     = `PC_SRC_TARGET;
                    alu_src_a_o  = `ALU_SRC_A_PC;
                    alu_src_b_o  = `ALU_SRC_B_IMM;
                    alu_op_o     = `ALU_ADD;
                    imm_sel_o    = `IMM_SEL_B;
                end else if (opcode_i == `OPCODE_JAL) begin
                    pc_write_o   = 1'b1;
                    pc_src_o     = `PC_SRC_TARGET;
                    alu_src_a_o  = `ALU_SRC_A_PC;
                    alu_src_b_o  = `ALU_SRC_B_IMM;
                    alu_op_o     = `ALU_ADD;
                    imm_sel_o    = `IMM_SEL_J;
                    result_src_o = `RESULT_SRC_PC4;
                end else if (opcode_i == `OPCODE_JALR) begin
                    // Target = rs1 + imm
                    pc_write_o   = 1'b1;
                    pc_src_o     = `PC_SRC_JALR;
                    alu_src_a_o  = `ALU_SRC_A_RS1;
                    alu_src_b_o  = `ALU_SRC_B_IMM;
                    alu_op_o     = `ALU_ADD;
                    imm_sel_o    = `IMM_SEL_I;
                    result_src_o = `RESULT_SRC_PC4;
                end else if (opcode_i == `OPCODE_LUI) begin
                    alu_src_b_o = `ALU_SRC_B_IMM;
                    alu_op_o    = `ALU_PASS_B;
                    imm_sel_o   = `IMM_SEL_U;
                end else if (opcode_i == `OPCODE_AUIPC) begin
                    alu_src_a_o = `ALU_SRC_A_PC;
                    alu_src_b_o = `ALU_SRC_B_IMM;
                    alu_op_o    = `ALU_ADD;
                    imm_sel_o   = `IMM_SEL_U;
                end else if (opcode_i == `OPCODE_SYSTEM || opcode_i == `OPCODE_FENCE) begin
                    // No-op
                end else if (opcode_i == `OPCODE_RTYPE && funct7_i == `FUNCT7_MUL) begin
                    // Zmmul
                    mult_en_o    = 1'b1;
                    mult_op_o      = {1'b0, funct3_i};
                    result_src_o = `RESULT_SRC_MUL;
                end else if (opcode_i == `OPCODE_RTYPE && funct7_i == `FUNCT7_CRC) begin
                    // Xicrc
                    crc_en_o     = 1'b1;
                    crc_op_o       = {1'b0, funct3_i};
                    result_src_o = `RESULT_SRC_CRC;
                end else begin
                    // R-type / I-type ALU
                    if (opcode_i == `OPCODE_ITYPE) begin
                        alu_src_b_o = `ALU_SRC_B_IMM;
                        imm_sel_o   = `IMM_SEL_I;
                    end

                    case (funct3_i)
                        3'b000: alu_op_o = (opcode_i != `OPCODE_ITYPE && funct7_i[5]) ? `ALU_SUB : `ALU_ADD;
                        3'b001: alu_op_o = `ALU_SLL;
                        3'b010: alu_op_o = `ALU_SLT;
                        3'b011: alu_op_o = `ALU_SLTU;
                        3'b100: alu_op_o = `ALU_XOR;
                        3'b101: alu_op_o = funct7_i[5] ? `ALU_MRS : `ALU_SRL;
                        3'b110: alu_op_o = `ALU_OR;
                        3'b111: alu_op_o = `ALU_AND;
                        default: alu_op_o = `ALU_ADD;
                    endcase
                end
            end

            MEM_ADDR: begin
                // Effective address = rs1 + imm
                alu_src_a_o = `ALU_SRC_A_RS1;
                alu_src_b_o = `ALU_SRC_B_IMM;
                alu_op_o    = `ALU_ADD;
                imm_sel_o   = (opcode_i == `OPCODE_STORE) ? `IMM_SEL_S : `IMM_SEL_I;
                op_size_o   = op_size_lookup;
                bw_o        = bw_lookup;
            end

            MEM_ACCESS_ADDR: begin
                // Load sub-cycle 1
                oe_o      = 1'b1;
                op_size_o = op_size_lookup;
                adr_src_o = `ADR_SRC_ALU;
            end

            MEM_ACCESS_DATA: begin
                // Load sub-cycle 2
                result_src_o = `RESULT_SRC_MEM;
                op_size_o    = op_size_lookup;
                oe_o         = 1'b1;
                adr_src_o    = `ADR_SRC_ALU;
            end

            MEM_ACCESS_STORE: begin
                // Store commit
                we_o      = 1'b1;
                op_size_o = op_size_lookup;
                bw_o      = bw_lookup;
                adr_src_o = `ADR_SRC_ALU;
            end

            WRITE_BACK: begin
                reg_write_o = 1'b1;
                if (prev_state == MEM_ACCESS_DATA) begin
                    result_src_o = `RESULT_SRC_MEM;
                    op_size_o    = op_size_lookup;
                end
                else if (prev_state == EXECUTE_ALU &&
                         (opcode_i == `OPCODE_JAL || opcode_i == `OPCODE_JALR))
                    result_src_o = `RESULT_SRC_PC4;
                else if (prev_state == EXECUTE_ALU && opcode_i == `OPCODE_RTYPE &&
                         funct7_i == `FUNCT7_MUL)
                    result_src_o = `RESULT_SRC_MUL;
                else if (prev_state == EXECUTE_ALU && opcode_i == `OPCODE_RTYPE &&
                         funct7_i == `FUNCT7_CRC)
                    result_src_o = `RESULT_SRC_CRC;
                else
                    result_src_o = `RESULT_SRC_ALU;
            end

            default: begin
            end
        endcase

        // Halt override: freezes pc + ir on ECALL
        if (halt_o) begin
            pc_write_o = 1'b0;
            ir_write_o = 1'b0;
        end
    end

endmodule



//  ---------- INLCUDED BLOCK: reg32_dff_eq26  ---------- 
module reg32_dff_eq26 #(
    parameter RESET_VALUE = 32'h00000000
) (
    input  wire        clk_i,
    input  wire        rst_i,
    input  wire        en_i,       // Enable: 1 = load d_i, 0 = hold current value
    input  wire [31:0] d_i,        // Data input (D)
    output reg  [31:0] q_o         // Data output (Q)
);

    always @(posedge clk_i) begin
        if (rst_i) begin
            q_o <= RESET_VALUE;
        end else if (en_i) begin
            q_o <= d_i;
        end
    end

endmodule
// Generic D flip-flop register.



//  ---------- INLCUDED BLOCK: mux_result  ---------- 
module mux_result (
    input  wire [2:0]  result_src_i,   // Select code from Control Unit (result_src_o)
    input  wire [31:0] alu_out_i,      // ALU registered result (3'b000)
    input  wire [31:0] mult_result_i,  // Multiplier registered result (3'b001)
    input  wire [31:0] crc_result_i,   // CRC registered result (3'b010)
    input  wire [31:0] mem_result_i,   // Memory loaded result from LSU (3'b011)
    input  wire [31:0] old_pc_i,       // Old PC for JAL/JALR return address (3'b100 -> Old_PC + 4)
    output reg  [31:0] result_o        // Selected 32-bit data to regfile.write_data_i
);

    localparam [2:0] RESULT_SRC_ALU = 3'b000;
    localparam [2:0] RESULT_SRC_MUL = 3'b001;
    localparam [2:0] RESULT_SRC_CRC = 3'b010;
    localparam [2:0] RESULT_SRC_MEM = 3'b011;
    localparam [2:0] RESULT_SRC_PC4 = 3'b100;

    always @(*) begin
        case (result_src_i)
            RESULT_SRC_ALU: result_o = alu_out_i;
            RESULT_SRC_MUL: result_o = mult_result_i;
            RESULT_SRC_CRC: result_o = crc_result_i;
            RESULT_SRC_MEM: result_o = mem_result_i;
            RESULT_SRC_PC4: result_o = old_pc_i + 32'd4;
            default:        result_o = alu_out_i;
        endcase
    end

endmodule



//  ---------- INLCUDED BLOCK: ir_splitter_eq26  ---------- 
module ir_splitter_eq26(
    input  wire [31:0] instr_i,      // 32-bit instruction from IR register (q_o of reg32)
    output wire [6:0]  opcode_o,     // instr_i[6:0]   -> to control_unit.opcode_i
    output wire [4:0]  rd_o,         // instr_i[11:7]  -> to regfile.rd_addr_i
    output wire [2:0]  funct3_o,     // instr_i[14:12] -> to control_unit & branch_comparator
    output wire [4:0]  rs1_o,        // instr_i[19:15] -> to regfile.rs1_addr_i
    output wire [4:0]  rs2_o,        // instr_i[24:20] -> to regfile.rs2_addr_i
    output wire [6:0]  funct7_o,     // instr_i[31:25] -> to control_unit.funct7_i
    output wire [11:0] funct12_o     // instr_i[31:20] -> to control_unit.funct12_i
);
    assign opcode_o  = instr_i[6:0];
    assign rd_o      = instr_i[11:7];
    assign funct3_o  = instr_i[14:12];
    assign rs1_o     = instr_i[19:15];
    assign rs2_o     = instr_i[24:20];
    assign funct7_o  = instr_i[31:25];
    assign funct12_o = instr_i[31:20];
endmodule



//  ---------- INLCUDED BLOCK: mux_alu_a  ---------- 
module mux_alu_a (
    input  wire        alu_src_a_i,   // 0: RS1 data, 1: Old_PC
    input  wire [31:0] rs1_data_i,    // Data from RegFile rs1
    input  wire [31:0] old_pc_i,      // Saved PC from Old_PC register
    output wire [31:0] a_o            // Operand A into ALU
);

    assign a_o = alu_src_a_i ? old_pc_i : rs1_data_i;

endmodule



//  ---------- INLCUDED BLOCK: mux_alu_b  ---------- 
module mux_alu_b (
    input  wire [1:0]  alu_src_b_i,   // 2'b00: RS2, 2'b01: Immediate, 2'b10: Constant 4
    input  wire [31:0] rs2_data_i,    // Data from RegFile rs2
    input  wire [31:0] imm_i,         // Extended immediate from imm_extend
    output reg  [31:0] b_o            // Operand B into ALU
);

    always @(*) begin
        case (alu_src_b_i)
            2'b00:   b_o = rs2_data_i;
            2'b01:   b_o = imm_i;
            2'b10:   b_o = 32'd4;
            default: b_o = rs2_data_i;
        endcase
    end

endmodule



//  ---------- INLCUDED BLOCK: fetch_registers  ---------- 
module fetch_registers #(
    parameter PC_RESET_ADDR = 32'h00400000
) (
    input  wire        clk_i,
    input  wire        rst_i,
    // Controls from Control Unit
    input  wire        pc_write_i,      // From control_unit.pc_write_o
    input  wire        ir_write_i,      // From control_unit.ir_write_o
    // Data inputs
    input  wire [31:0] pc_next_i,       // From mux_pc_next.pc_next_o
    input  wire [31:0] mem_data_i,      // Instruction data from memory (decoder_data_o)
    // Register outputs
    output reg  [31:0] pc_o,            // Current PC -> to mux_mem_addr, PC+4 adder
    output reg  [31:0] old_pc_o,        // Saved Old PC -> to mux_alu_a, mux_result
    output reg  [31:0] ir_o             // Instruction Register -> to ir_splitter, imm_extend
);
    always @(posedge clk_i) begin
        if (rst_i) begin
            pc_o     <= PC_RESET_ADDR;
            old_pc_o <= 32'b0;
            ir_o     <= 32'b0;
        end else begin
            if (pc_write_i) begin
                pc_o <= pc_next_i;
            end
            if (ir_write_i) begin
                old_pc_o <= pc_o;        // Captures pre-increment PC in FETCH
                ir_o     <= mem_data_i;  // Latches fetched instruction in FETCH
            end
        end
    end
endmodule



//  ---------- INLCUDED BLOCK: mux_pc_next  ---------- 
module mux_pc_next (
    input  wire [1:0]  pc_src_i,      // From control_unit.pc_src_o[1:0]
    input  wire [31:0] pc_i,          // From fetch_registers.pc_o (adds +4 internally!)
    input  wire [31:0] alu_result_i,  // From alu.result_o (Live branch/jump target)
    output reg  [31:0] pc_next_o      // To fetch_registers.pc_next_i
);
    always @(*) begin
        case (pc_src_i)
            2'b00:   pc_next_o = pc_i + 32'd4;                 // PC + 4 computed inside!
            2'b01:   pc_next_o = alu_result_i;                 // Branch / JAL target
            2'b10:   pc_next_o = {alu_result_i[31:1], 1'b0};   // JALR target (clears bit 0)
            default: pc_next_o = pc_i + 32'd4;
        endcase
    end
endmodule



//  ---------- INLCUDED BLOCK: mux_mem_addr  ---------- 
module mux_mem_addr (
    input  wire        adr_src_i,     // 0: PC, 1: ALU_Out
    input  wire [31:0] pc_i,          // Current PC address (Fetch)
    input  wire [31:0] alu_out_i,     // Calculated memory address (Load/Store)
    output wire [31:0] address_o      // Address sent to address_decoder
);

    assign address_o = adr_src_i ? alu_out_i : pc_i;

endmodule



//  ---------- INLCUDED BLOCK: alu_out_reg  ---------- 
module alu_out_reg #(
    parameter RESET_VALUE = 32'h00000000
) (
    input  wire        clk_i,
    input  wire        rst_i,
    input  wire        en_i,           // Enable: 1 = load alu_result_i, 0 = hold
    input  wire [31:0] alu_result_i,   // From alu.result_o
    output reg  [31:0] alu_out_o,      // Registered 32-bit ALU output
    output wire [1:0]  addr_lsb_o      // Direct tap of alu_out_o[1:0] -> to CU.addr_lsb_i
);

    always @(posedge clk_i) begin
        if (rst_i) begin
            alu_out_o <= RESET_VALUE;
        end else if (en_i) begin
            alu_out_o <= alu_result_i;
        end
    end

    // Direct extraction of lowest 2 bits for the Control Unit byte-write mask
    assign addr_lsb_o = alu_out_o[1:0];

endmodule


// Automatically generated by ChipInventor Cloud EDA Tool - 3.15
// Careful: this file (hdl.v) will be automatically replaced
// when you ask tool to generate top Verilog code by clicking
// at BLOCKS button.

// Stage 3 Part 1, sections 1.1-1.3: eight independent GPIO pins.
// Bus: clk/rst (1), full byte address addr_i (32), we/oe (1), byte mask (4),
// write/read data (32), split pin bus pins_i/pins_o/pins_oe_o (8 each).
// addr_i takes the whole address bus so the ChipInventor canvas can wire it
// bus-to-bus (no bit slicing on the canvas); the register select is taken
// from addr_i[3:2] here. The decoder gates we_i/oe_i, so upper bits are unused.
// Offsets: 0 DATAOUT (RW), 1 DATAIN (R), 2 DATADIR (RW).
// Direction 0 releases the pin; direction 1 drives DATAOUT.
// Implementation choices where the guide is silent: synchronous active-high
// reset, all registers reset to zero, DATAIN holds its last sample in output
// mode. Reserved bits/offsets read zero. Writes only affect byte lane zero.
// Read data registers on oe_i and holds otherwise, matching the core's
// MEM_ACCESS_ADDR -> MEM_ACCESS_DATA load sequence and DMEM interface.
// Deviation from guide Figure 1: the tri-state buffer is NOT inside this block.
// ChipInventor's Inout Pin drops its C/D inputs (converter 3.15 emits only an
// inout port), and FPGA fabric/Sky130 macros want split in/out/enable anyway.
// The pad outside the core does: pin = pins_oe_o ? pins_o : Z; pins_i = pin.
module gpio (
    input wire clk_i,
    input wire rst_i,
    input wire [31:0] addr_i,
    input wire we_i,
    input wire oe_i,
    input wire [3:0] bw_i,
    input wire [31:0] data_i,
    output reg [31:0] data_o,
    input  wire [7:0] pins_i,    // level on each pad
    output wire [7:0] pins_o,    // DATAOUT, value to drive
    output wire [7:0] pins_oe_o  // DATADIR, 1 = drive pad (output enable)
);
    reg [7:0] dataout;
    reg [7:0] datadir;
    reg [7:0] datain;
    wire [1:0] reg_sel = addr_i[3:2]; // word offset; bits [1:0] ignored per guide 1.1

    assign pins_o    = dataout;
    assign pins_oe_o = datadir;

    genvar i;
    generate
        for (i = 0; i < 8; i = i + 1) begin : pin_control
            always @(posedge clk_i) begin
                if (rst_i)
                    datain[i] <= 1'b0;
                else if (!datadir[i])
                    datain[i] <= pins_i[i];
            end
        end
    endgenerate

    always @(posedge clk_i) begin
        if (rst_i) begin
            dataout <= 8'b0;
            datadir <= 8'b0;
        end else if (we_i && bw_i[0]) begin
            case (reg_sel)
                2'd0: dataout <= data_i[7:0];
                2'd2: datadir <= data_i[7:0];
                default: begin end // DATAIN is read-only.
            endcase
        end
    end

    always @(posedge clk_i) begin
        if (rst_i)
            data_o <= 32'b0;
        else if (oe_i) begin
            case (reg_sel)
                2'd0: data_o <= {24'b0, dataout};
                2'd1: data_o <= {24'b0, datain};
                2'd2: data_o <= {24'b0, datadir};
                default: data_o <= 32'b0;
            endcase
        end
    end
endmodule


// 8-N-1 transmitter. start_i while busy is ignored; done_o stays high when idle.
module uart_tx #(parameter integer CLKS_PER_BIT = 174) (
    input wire clk_i, rst_i, start_i,
    input wire [7:0] data_i,
    output reg tx_o, busy_o, done_o
);
    localparam integer CW = (CLKS_PER_BIT > 1) ? $clog2(CLKS_PER_BIT) : 1;
    reg [CW-1:0] count;
    reg [3:0] bit_index;
    reg [7:0] shift;
    always @(posedge clk_i) begin
        if (rst_i) begin
            tx_o <= 1; busy_o <= 0; done_o <= 1;
            count <= 0; bit_index <= 0; shift <= 0;
        end else if (!busy_o) begin
            if (start_i) begin
                shift <= data_i;
                tx_o <= 0; busy_o <= 1; done_o <= 0;
                count <= 0; bit_index <= 0;
            end
        end else if (count == CLKS_PER_BIT-1) begin
            count <= 0;
            if (bit_index < 8) begin
                tx_o <= shift[0]; shift <= {1'b0, shift[7:1]};
                bit_index <= bit_index + 1'b1;
            end else if (bit_index == 8) begin
                tx_o <= 1; bit_index <= 9;
            end else begin
                busy_o <= 0; done_o <= 1;
            end
        end else count <= count + 1'b1;
    end
endmodule

// Single midpoint sample per bit (no oversampling), with a two-flop synchronizer.
// Invalid start/stop bits are discarded; there is no error status in the guide.
module uart_rx #(parameter integer CLKS_PER_BIT = 174) (
    input wire clk_i, rst_i, rx_i,
    output reg [7:0] data_o,
    output reg valid_o
);
    localparam integer CW = (CLKS_PER_BIT > 1) ? $clog2(CLKS_PER_BIT) : 1;
    localparam [1:0] IDLE=0, START=1, DATA=2, STOP=3;
    (* ASYNC_REG = "TRUE" *) reg rx_meta, rx_sync;
    reg [1:0] state;
    reg [CW-1:0] count;
    reg [2:0] bit_index;
    reg [7:0] shift;
    always @(posedge clk_i) begin
        if (rst_i) begin rx_meta <= 1; rx_sync <= 1; end
        else begin rx_meta <= rx_i; rx_sync <= rx_meta; end
    end
    always @(posedge clk_i) begin
        if (rst_i) begin
            state <= IDLE; count <= 0; bit_index <= 0;
            shift <= 0; data_o <= 0; valid_o <= 0;
        end else begin
            valid_o <= 0;
            case (state)
                IDLE: if (!rx_sync) begin count <= 0; state <= START; end
                START: if (count == (CLKS_PER_BIT/2)-1) begin
                    count <= 0;
                    if (!rx_sync) begin bit_index <= 0; state <= DATA; end
                    else state <= IDLE;
                end else count <= count + 1'b1;
                DATA: if (count == CLKS_PER_BIT-1) begin
                    count <= 0; shift[bit_index] <= rx_sync;
                    if (bit_index == 7) state <= STOP;
                    else bit_index <= bit_index + 1'b1;
                end else count <= count + 1'b1;
                STOP: if (count == CLKS_PER_BIT-1) begin
                    count <= 0; state <= IDLE;
                    if (rx_sync) begin data_o <= shift; valid_o <= 1; end
                end else count <= count + 1'b1;
                default: state <= IDLE;
            endcase
        end
    end
endmodule

// Stage 3 Part 1 section 2: word offsets 0 TXDATA, 1 RXDATA, 2 CONTROL.
// Registered reads match GPIO/DMEM. Only byte lane zero is writable.
// Choices where guide is silent: TXDONE resets high; busy starts are ignored;
// newest received byte wins on overrun; reception wins over software flag clear.
module uart #(
    parameter integer CLK_HZ = 20000000,
    parameter integer BAUD = 115200
) (
    input wire clk_i, rst_i,
    input wire [31:0] addr_i,
    input wire we_i, oe_i,
    input wire [3:0] bw_i,
    input wire [31:0] data_i,
    output reg [31:0] data_o,
    input wire rx_i,
    output wire tx_o
);
    // Round to nearest whole clock. Supported configurations need >= 4 clocks/bit.
    localparam integer CLKS_PER_BIT = (CLK_HZ + BAUD/2) / BAUD;
    reg [7:0] txdata, rxdata;
    reg transmit, rxdone;
    wire txbusy, txdone, rxvalid;
    wire [7:0] received;
    wire [1:0] reg_sel = addr_i[3:2]; // word offset; bits [1:0] ignored per guide 2.1
    uart_tx #(.CLKS_PER_BIT(CLKS_PER_BIT)) transmitter (
        .clk_i(clk_i), .rst_i(rst_i), .start_i(transmit), .data_i(txdata),
        .tx_o(tx_o), .busy_o(txbusy), .done_o(txdone)
    );
    uart_rx #(.CLKS_PER_BIT(CLKS_PER_BIT)) receiver (
        .clk_i(clk_i), .rst_i(rst_i), .rx_i(rx_i),
        .data_o(received), .valid_o(rxvalid)
    );
    always @(posedge clk_i) begin
        if (rst_i) begin
            txdata <= 0; rxdata <= 0; transmit <= 0; rxdone <= 0;
        end else begin
            transmit <= 0;
            if (we_i && bw_i[0]) begin
                case (reg_sel)
                    0: txdata <= data_i[7:0];
                    2: begin
                        transmit <= data_i[0] && !txbusy && !transmit;
                        rxdone <= data_i[1];
                    end
                    default: begin end
                endcase
            end
            if (rxvalid) begin rxdata <= received; rxdone <= 1; end
        end
    end
    always @(posedge clk_i) begin
        if (rst_i) data_o <= 0;
        else if (oe_i) begin
            case (reg_sel)
                0: data_o <= {24'b0, txdata};
                1: data_o <= {24'b0, rxdata};
                2: data_o <= {29'b0, (txdone && !transmit), rxdone, 1'b0};
                default: data_o <= 0;
            endcase
        end
    end
endmodule

// Milliseconds since the last software refresh. Any word write restarts it.
// Saturation prevents an unattended meter from becoming fresh after wraparound.
module meter_timer #(parameter integer CLK_HZ = 20000000) (
    input wire clk_i, rst_i, we_i, oe_i,
    input wire [31:0] addr_i,
    output reg [31:0] data_o
);
    localparam integer TICKS_PER_MS = (CLK_HZ < 1000) ? 1 : CLK_HZ / 1000;
    localparam integer CW = (TICKS_PER_MS > 1) ? $clog2(TICKS_PER_MS) : 1;
    reg [CW-1:0] ticks;
    reg [31:0] age_ms;
    reg [CW-1:0] rx_ticks;
    reg [31:0] rx_age_ms;
    always @(posedge clk_i) begin
        if (rst_i || (we_i && !addr_i[2])) begin
            ticks <= 0;
            age_ms <= 0;
        end else if (ticks == TICKS_PER_MS - 1) begin
            ticks <= 0;
            if (age_ms != 32'hffffffff) age_ms <= age_ms + 1'b1;
        end else ticks <= ticks + 1'b1;
        if (rst_i || (we_i && addr_i[2])) begin
            rx_ticks <= 0;
            rx_age_ms <= 0;
        end else if (rx_ticks == TICKS_PER_MS - 1) begin
            rx_ticks <= 0;
            if (rx_age_ms != 32'hffffffff) rx_age_ms <= rx_age_ms + 1'b1;
        end else rx_ticks <= rx_ticks + 1'b1;
        if (rst_i) data_o <= 0;
        else if (oe_i) data_o <= addr_i[2] ? rx_age_ms : age_ms;
    end
endmodule

module top #(parameter integer CLK_HZ = 20000000) (
    input wire rx_i,
    output wire tx_o,
    input  wire [7:0] pins_i,
    output wire [7:0] pins_o,
    output wire [7:0] pins_oe_o,

  input wire clk_i,
  input wire rst_i,
  output wire halt_o,
  output wire [31:0] pc_dbg_o,
  output wire [31:0] x4_dbg_o

);

//Internal Wires
 wire w_1;
 wire [31:0] w_2;
 wire [31:0] w_3;
 wire w_4;
 wire [31:0] w_5;
 wire [31:0] w_6;
 wire [31:0] w_7;
 wire w_8;
 wire w_9;
 wire [3:0] w_10;
 wire [31:0] w_11;
 wire [31:0] w_12;
 wire [31:0] w_13;
 wire w_15;
 wire w_16;
 wire w_17;
 wire [3:0] w_18;
 wire [31:0] w_19;
 wire [31:0] w_21;
 wire [31:0] w_22;
 wire [3:0] w_23;
 wire [31:0] w_24;
 wire w_26;
 wire [31:0] w_27;
 wire [1:0] w_30;
 wire [6:0] w_31;
 wire [2:0] w_32;
 wire [6:0] w_33;
 wire [11:0] w_34;
 wire w_35;
 wire w_36;
 wire [1:0] w_37;
 wire w_38;
 wire w_39;
 wire [2:0] w_40;
 wire w_41;
 wire [1:0] w_42;
 wire [2:0] w_43;
 wire [3:0] w_44;
 wire [3:0] w_45;
 wire w_46;
 wire [2:0] w_47;
 wire w_48;
 wire [31:0] w_49;
 wire [31:0] w_50;
 wire [31:0] w_51;
 wire [31:0] w_52;
 wire [31:0] w_53;
 wire [31:0] w_57;
 wire [31:0] w_59;
 wire [31:0] w_61;
 wire [4:0] w_62;
 wire [4:0] w_64;
 wire [4:0] w_65;
 wire [31:0] w_67;
 wire [31:0] w_72;
 wire [31:0] w_73;

//Interface Assigns
assign pc_dbg_o[31:0] = w_53;

//Instances of Modules
reg32_dff_eq26 #(.RESET_VALUE(32'h00000000)) blk3722_24 (
         .clk_i (clk_i),
         .rst_i (rst_i),
         .en_i (w_1),
         .d_i (w_2),
         .q_o (w_3)
     );

reg32_dff_eq26 #(.RESET_VALUE(32'h00000000)) blk3722_32 (
         .clk_i (clk_i),
         .rst_i (rst_i),
         .en_i (w_4),
         .d_i (w_5),
         .q_o (w_6)
     );

wire [31:0] uart_data;
wire uart_we, uart_oe;
uart #(.CLK_HZ(CLK_HZ)) uart_inst (
    .clk_i(clk_i), .rst_i(rst_i), .addr_i(w_7),
    .we_i(uart_we), .oe_i(uart_oe), .bw_i(w_10),
    .data_i(w_67), .data_o(uart_data), .rx_i(rx_i), .tx_o(tx_o)
);
wire [31:0] gpio_data;
wire gpio_we, gpio_oe;
gpio gpio_inst (
    .clk_i(clk_i), .rst_i(rst_i),
    .addr_i(w_7), .we_i(gpio_we), .oe_i(gpio_oe),
    .bw_i(w_10), .data_i(w_67), .data_o(gpio_data),
    .pins_i(pins_i), .pins_o(pins_o), .pins_oe_o(pins_oe_o)
);

wire [31:0] timer_data;
wire timer_we, timer_oe;
meter_timer #(.CLK_HZ(CLK_HZ)) meter_timer_inst (
    .addr_i(w_7),
    .clk_i(clk_i), .rst_i(rst_i), .we_i(timer_we), .oe_i(timer_oe),
    .data_o(timer_data)
);

address_decoder blk3566_49 (
         .timer_data_i(timer_data),
         .timer_we_o(timer_we), .timer_oe_o(timer_oe),
         .uart_data_i (uart_data),
         .uart_we_o (uart_we),
         .uart_oe_o (uart_oe),
         .gpio_data_i (gpio_data),
         .gpio_we_o (gpio_we),
         .gpio_oe_o (gpio_oe),
         .address_i (w_7),
         .we_i (w_8),
         .oe_i (w_9),
         .bw_i (w_10),
         .dmem_data_i (w_11),
         .imem_data_i (w_12),
         .address_o (w_13),
         .dmem_we_o (w_15),
         .dmem_oe_o (w_16),
         .imem_oe_o (w_17),
         .bw_o (w_18),
         .data_o (w_19)
     );

alu_eq26 blk3550_50 (
         .a_i (w_21),
         .b_i (w_22),
         .alu_op_i (w_23),
         .result_o (w_24)
     );

alu_out_reg #(.RESET_VALUE(32'h00000000)) blk3811_51 (
         .clk_i (clk_i),
         .rst_i (rst_i),
         .alu_result_i (w_24),
         .en_i (w_26),
         .alu_out_o (w_27),
         .addr_lsb_o (w_30)
     );

control_unit_eq26 blk3567_53 (
         .clk_i (clk_i),
         .rst_i (rst_i),
         .halt_o (halt_o),
         .mult_en_o (w_1),
         .result_src_is_mem_o (w_4),
         .we_o (w_8),
         .oe_o (w_9),
         .bw_o (w_10),
         .alu_op_o (w_23),
         .not_adr_src_o (w_26),
         .addr_lsb_i (w_30),
         .opcode_i (w_31),
         .funct3_i (w_32),
         .funct7_i (w_33),
         .funct12_i (w_34),
         .branch_taken_i (w_35),
         .pc_write_o (w_36),
         .pc_src_o (w_37),
         .ir_write_o (w_38),
         .reg_write_o (w_39),
         .result_src_o (w_40),
         .alu_src_a_o (w_41),
         .alu_src_b_o (w_42),
         .imm_sel_o (w_43),
         .mult_op_o (w_44),
         .crc_op_o (w_45),
         .crc_en_o (w_46),
         .op_size_o (w_47),
         .adr_src_o (w_48)
     );

crc_eq26 #(.POLY(16'h1021), .XOR_OUT(16'h0000)) blk3553_54 (
         .crc_op_i (w_45),
         .a_i (w_49),
         .b_i (w_50),
         .result_o (w_51)
     );

fetch_registers #(.PC_RESET_ADDR(32'h00400000)) blk3804_56 (
         .clk_i (clk_i),
         .rst_i (rst_i),
         .pc_o (w_53),
         .mem_data_i (w_19),
         .pc_write_i (w_36),
         .ir_write_i (w_38),
         .pc_next_i (w_52),
         .old_pc_o (w_57),
         .ir_o (w_59)
     );

imm_extend_eq26 blk3556_58 (
         .imm_sel_i (w_43),
         .instr_i (w_59),
         .imm_o (w_61)
     );

ir_splitter_eq26 blk3781_59 (
         .opcode_o (w_31),
         .funct3_o (w_32),
         .funct7_o (w_33),
         .funct12_o (w_34),
         .instr_i (w_59),
         .rd_o (w_62),
         .rs1_o (w_64),
         .rs2_o (w_65)
     );

lsu_eq26 blk3562_60 (
         .core_data_i (w_5),
         .mem_data_o (w_19),
         .core_address_o (w_27),
         .op_size_o (w_47),
         .core_data_o (w_50),
         .mem_data_i (w_67)
     );

mult_eq26 blk3557_61 (
         .result_o (w_2),
         .mult_op_i (w_44),
         .a_i (w_49),
         .b_i (w_50)
     );

mux_alu_a blk3795_62 (
         .a_o (w_21),
         .alu_src_a_i (w_41),
         .old_pc_i (w_57),
         .rs1_data_i (w_49)
     );

mux_alu_b blk3796_63 (
         .b_o (w_22),
         .alu_src_b_i (w_42),
         .imm_i (w_61),
         .rs2_data_i (w_50)
     );

mux_mem_addr blk3808_64 (
         .address_o (w_7),
         .alu_out_i (w_27),
         .adr_src_i (w_48),
         .pc_i (w_53)
     );

mux_pc_next blk3807_65 (
         .alu_result_i (w_24),
         .pc_src_i (w_37),
         .pc_next_o (w_52),
         .pc_i (w_53)
     );

mux_result blk3724_66 (
         .mult_result_i (w_3),
         .mem_result_i (w_6),
         .alu_out_i (w_27),
         .result_src_i (w_40),
         .old_pc_i (w_57),
         .crc_result_i (w_72),
         .result_o (w_73)
     );

reg32_dff_eq26 #(.RESET_VALUE(32'h00000000)) blk3722_67 (
         .clk_i (clk_i),
         .rst_i (rst_i),
         .en_i (w_46),
         .d_i (w_51),
         .q_o (w_72)
     );

dmem_eq26 #(.DEPTH_WORDS(4)) blk3565_69 (
         .clk_i (clk_i),
         .rst_i (rst_i),
         .data_o (w_11),
         .addr_i (w_13),
         .we_i (w_15),
         .oe_i (w_16),
         .bw_i (w_18),
         .data_i (w_67)
     );

branch_comparator_eq26 blk3552_77 (
         .branch_taken_o (w_35),
         .funct3_i (w_32),
         .rs1_i (w_49),
         .rs2_i (w_50)
     );

regfile_eq blk3560_78 (
         .clk_i (clk_i),
         .rst_i (rst_i),
         .x4_dbg_o (x4_dbg_o[31:0]),
         .reg_write_i (w_39),
         .rs1_data_o (w_49),
         .rs2_data_o (w_50),
         .rd_addr_i (w_62),
         .rs1_addr_i (w_64),
         .rs2_addr_i (w_65),
         .write_data_i (w_73)
     );

imem blk3564_79 (
         .clk_i (clk_i),
         .data_o (w_12),
         .addr_i (w_13),
         .oe_i (w_17)
     );


endmodule
