ZhuHengg/ChampionCHIP-Multicycle-Processor-Architecture/(commit log)

2026-08-26 fix: restore trap 9 guard in top.v mux_result MUL arm
    Commit 44d9aa2 shipped a leftover mutation-testing edit:
    `RESULT_SRC_MUL: mux_result = mult_result; // MUTATION 1 TEMP
    WRITE_BACK selects RESULT_SRC_MUL but control_unit.v drives mult_op_o
    only inside EXECUTE_ALU, so by WRITE_BACK it has fallen back to its
    4'h0 default (MULT_MUL). Reading the live mult.result_o there makes
    mulh/mulhsu/mulhu return the low half of the product. mul passes,
    because 4'h0 is its own encoding.
    Restores the tap to the registered mult_result_r, captured while
    mult_op_o is still driven.
    Verified: tb_top_muldiv fails 9 checks against 44d9aa2's top.v and
    passes 68/68 with this fix. tb_top_mem, tb_top_branc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
    [top.v]
2026-09-06 Trim RTL/testbench comments to brief tags
    Strip verbose narrative comments (slice-history logs, spec-citation
    essays, banner blocks) across rtl/ and tb/ down to short 1-2 line
    summaries. Deviation rationale that CLAUDE.md step 8 calls for is kept
    where it's load-bearing (e.g. lsu.v sign-extension resolution, crc.v
    operand roles, funct7 else-not-equality warning) but compressed to one
    line. No RTL logic, port names, test vectors, or $display strings
    changed — verified by recompiling and re-running every testbench
    (control_unit, datapath, memory, and all system-level top testbenches)
    after the edit, all still report ALL TESTS PASSED.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
    [address_decoder.v, alu_out_reg.v, fetch_registers.v, imem.v, mux_alu_a.v, mux_alu_b.v, mux_mem_addr.v, mux_pc_next.v]
2026-09-08 Fixes: Incompatibility of OpenLane
    [control_unit_eq26.v, hdl.v, testCaravel.v, testbench.v, top.v]
2026-09-09 Fix mux_alu_b, inline firmware into imem, fix address width bugs
    - rtl/control_unit.v, rtl/top.v: widen decoder_address_o to 32 bits
    (was truncated to 30, silently zero-padded by iverilog but rejected
    by yosys synthesis); fix mult_op_o/crc_op_o padding to {1'b0, funct3}
    matching the 4-bit port width instead of over-padding with {2'b00,...}
    - chip-inventor/rtl/mux_alu_b.v: was an accidental copy of mux_alu_a.v;
    replaced with the real 3-way rs2/imm/const4 mux
    - chip-inventor/rtl/imem.v: inline the full 259-word validation firmware
    as a case table (ChipInventor can't resolve $readmemh across files)
    - chip-inventor/rtl/control_unit_eq26.v: compute not_adr_src_o and
    result_src_is_mem_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
    [control_unit_eq26.v, dmem_eq26.v, hdl.v, imem.v, simulate.v, testCaravel.v, top.v]
2026-09-11 Restructure repo into legacy / chip-inventor / v2-chip-inventor-synth
    Move original hand-written slice (rtl, tb, sim, firmware, logs, scripts,
    config.json) into legacy/, rename 4B-chip-inventor to
    v2-chip-inventor-synth for clarity, and update README/CLAUDE.md paths
    and folder descriptions to match. Fix .gitignore sim/logs patterns to
    use **/ so they match at any depth, not just repo root.
    [address_decoder.v, alu_eq26.v, alu_out_reg.v, branch_comparator_eq26.v, control_unit_eq26.v, crc.eq26.v, dmem_eq26.v, fetch_registers.v]
2026-09-13 Restore full Stage 2 validation firmware in chip-inventor imem
    hdl.v/rtl/imem.v had been swapped to a 4-instruction synthesis-only
    mock; testbench.v's PASS claim (979 cycles, x4=0) didn't hold against
    it. Restored the full 259-word firmware matching
    legacy/firmware/organiser_validation.hex, verified PASS by simulation.
    hdl-chip.v (duplicate export, same content) removed as redundant.
    [hdl.v, imem.v]
2026-09-13 Trim verbose comments across chip-inventor rtl/ and hdl.v
    Replaces long spec-citation and deviation-tracking comment blocks with
    short 2-3 word module descriptions across all rtl/*.v files and their
    flattened exports (hdl.v, rtl/top.v). Code logic is unchanged; verified
    by rerunning testbench.v against hdl.v (still PASS: pc=0x004003ec,
    x4=0 after 979 cycles).
    [address_decoder.v, branch_comparator_eq26.v, control_unit_eq26.v, crc.eq26.v, dmem_eq26.v, hdl.v, imm_extend_eq26.v, lsu_eq26.v]
2026-09-13 Trim testbench.v header comment, sync chip-inventor build/log/sim outputs
    Shortened the verbose testbench.v header block to essential facts
    (dot-ref elaboration limit, 979-cycle source) while keeping both
    citations intact. Also picks up external synthesis/build artifact
    changes already present in the working tree: new chip-inventor/build/
    (gds, gate-level verilog, openlane.log), removal of stale sim outputs
    (testbench_mock.v/.vcd, testbench/ dir contents, sim_mock.vvp,
    testbench.vcd), and config.json/simulate.v/converter.log updates.
    [simulate.v, testCaravel.v, testbench.v, testbench_mock.v]
2026-09-13 Add chip-inventor README and Stage 2 firmware validation evidence
    Documents the RV32I/Zmmul/Xicrc module layout, confirms the baked-in
    imem firmware matches the official CCX_Malaysia_Edition_Firmware_Stage_2
    repo word-for-word, and records the passing simulation run (entry PC,
    terminal self-loop PC, x4 sentinel all PASS) alongside its evidence:
    sim log, waveform vcd, and a gtkwave screenshot. Also summarizes the
    successful OpenLane GDSII flow result.
2026-09-23 Add Stage 3 GPIO peripheral and CPU integration tests
2026-09-23 Add Stage 3 Part 1 block guide
2026-09-25 Add Stage 3 UART peripheral with separate TX and RX modules
2026-09-25 Documented Stage 2 solution
2026-09-25 docs: add GPIO and UART integration handoff
2026-09-25 Added stage 3 strategy
2026-09-26 Integrate Stage 3 GPIO/UART with the ChipInventor canvas
    Make the teammate's GPIO/UART integration buildable from the ChipInventor
    canvas and add system-level tests that run unchanged inside ChipInventor.
    RTL
    - gpio/uart: addr_i widened to the full 32-bit bus; register select taken
    from addr_i[3:2] inside the block (canvas wires cannot bit-slice).
    - gpio: inout pins_io split into pins_i / pins_o / pins_oe_o. ChipInventor's
    Inout Pin drops its C/D inputs, and FPGA/Sky130 flows want split pads.
    - imem: FIRMWARE parameter selects the ROM. 0 = official Stage 2 firmware
    (default, unchanged word-for-word, what synthesis builds); 1/2/3 = GPIO,
    UART echo and full-system test programs, selec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
2026-09-26 Dump testbench waveforms to testbench.vcd for ChipInventor
    ChipInventor's simulator only allows the dump file testbench.vcd
    (matching its own module testbenches); custom names failed with
    "Unable to open <name>.vcd for output". GPIO, UART and full-system
    tests now pass in ChipInventor against the canvas top, and locally
    on hdl.v, rtl/top.v and new_export/top.v.
2026-09-26 feat: updated uart, gpio testbench
2026-09-26 Validate against organiser's official Stage 3 GPIO/UART firmware
    Vendor RVBL-GPIO-UART-Test-Firmware/ from the organiser's Stage 3 repo
    (external/CCX_Malaysia_Edition_Stage_3, RVBL-Emulator and
    RVBL-Firmware-Builder ignored -- not needed until Stage 4). Hand-decoded
    the 21-word ROM in firmware.txt and confirmed it matches main.s
    instruction for instruction.
    Add FIRMWARE 4 = organiser_program(): loads firmware.txt's words
    verbatim (not reassembled) via a LiteralRom shim, so imem carries the
    organiser's exact bytes. New tb_organiser.v checks the organiser
    README's own minimum test: P3-0 = 0xA -> P7-4 = 0xA (DATAOUT = 0xA0),
    and UART RX 0x30 -> TX 0x30 echo, plus a second GPIO value after a fu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
2026-09-27 Remove redundant canvas_blocks/uart_block.v
    It was a manually concatenated copy of rtl/uart.v + rtl/uart_tx.v +
    rtl/uart_rx.v for pasting into ChipInventor's block editor, byte-identical
    (ignoring comments/whitespace) to those three files. Nothing referenced
    it. rtl/ stays the single source of truth for the UART modules.
2026-09-27 feat(firmware): vendor organiser Firmware-Builder, add Xicrc assembler macros
    Mirror the organiser's RVBL-Firmware-Builder under chip-inventor/firmware/ so
    our src/main.s drops into their builder unchanged. Makefile, bsp/custom.ld and
    scripts/bin2rom.py are byte-for-byte copies with their headers intact.
    src/main.s is a Task 1 stub: the .equ block for the GPIO/UART map plus crcb /
    crch / crcw macros over .insn r 0x33, <funct3>, 0x40 (opcode 0110011,
    funct7 1000000, funct3 000/001/010 per the handoff opcode table).
    Validated:
    - Building the organiser's own RVBL-GPIO-UART-Test-Firmware/src/main.s with
    this builder reproduces their committed firmware.txt exactly (21 lines).
    - crcb s0, s1, s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
2026-09-27 test(app): golden model for grid-aware EV charger
    Bit-exact Python model of the application: frame/record formats, CRC chain,
    pilot/safety FSM and frame rules per spec SS7.4-7.6. This is the definition
    the firmware must match.
    crc16() mirrors rtl/crc.eq26.v exactly (poly 0x1021, MSB-first, no reflection,
    xorout 0, seed via rs2); check value "123456789" -> 0x29B1.
    22 tests pass, covering the normal session, stale pins at boot, ventilation
    refusal, CP errors, E-stop latch, corrupted/dropped/replayed frames, the
    over-current boundary, grid hold with CRC-hashed restart, and counter
    saturation/wrap.
    Deviation from the plan: test_energy_wraps_mod_2_32 uses I = I_MAX (320), not
    the plan's litera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
2026-09-27 fix(app): count bad frames in FAULT too, per spec 7.6 rule 3
    The golden model returned early in FAULT before the bad-frame counter, so a
    valid frame received while faulted never reset it. After a CRC-lost fault and
    recovery to IDLE, one later bad frame then faulted again immediately, which
    spec 7.6 does not allow (rule 3 resets the counter in every state; only the
    FAULT transition itself is skipped when already faulted).
    No existing scenario reached this path; the firmware follows the spec text,
    so this closes a latent model/firmware mismatch. New test
    test_valid_frame_in_fault_resets_bad_counter; 23 golden tests pass.
2026-09-27 docs: Stage 3 strategy rev 3.2 - grid-aware EV charger design frozen
    Application decided and specified (pin map, meter frame, session record, FSM
    and frame rules, constants, scenarios S1-S11). CRC chain seeded from the
    previous frame received so one corrupted frame cannot desync the meter.
    Restart-delay spread check (P1) passed. Emulator facts confirmed from the
    organiser's RVBL-Emulator README; repo layout mirrors the organiser repo.
2026-09-27 test(app): emulator+wrapper model testbench, validated on organiser firmware
    tb_app.v models ./emu plus the AWS FPGA wrapper: one emu_* task per emulator
    option, so a passing simulation is a passing ./emu command against our RTL.
    Behaviours taken from emu.c and RVBL-Emulator/README.md -- reset per command
    with the GPIO IN value persisting across it, options strictly in order, first
    mismatch aborting the rest, an 8-byte reply window read through a running
    pointer, -t sending low byte first, and emu.c's own log strings.
    scenarios.py holds the DSL (Scenario.d/i/o/t/r/frame/record, to_emu, to_vh);
    run_tests.py builds every top x scenario into chip-inventor/sim/app/.
    Validated against the organ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
2026-09-27 test(app): EV charger scenarios S1-S11 and ./emu command export
    Twelve application scenarios per spec SS7.8: normal session, streamed variant
    (S1X, 16 bytes back to back), grid hold with CRC-timed restart, corrupted and
    dropped frames, meter link lost, E-stop latch, plug-straight-into-C, limit
    boundaries and over-current, ventilation refusal and CP error, invalid pilot
    code, replay, and stale pins at boot.
    Every expected -o and -r value comes from golden.Charger, so the scenarios
    cannot drift from the model. scenarios.py exports each one as a real ./emu
    command line to chip-inventor/emulator/emu_commands.txt.
    Tested: python -m pytest chip-inventor/testbench/app -q -> 36 passed
    (23 golden +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
2026-09-27 feat(firmware): EV charger pilot/safety FSM and session record (FIRMWARE 5)
    main.s implements the I/O layer and the pilot/safety half of the application
    FSM (spec SS7.6): DATADIR = 0xF0 once at start, continuous polling of the CP
    code and safety pin, rules re-applied until the state is stable (so CP = C
    from IDLE walks IDLE -> CONNECTED -> CHARGING in one pass), the IDLE ->
    CONNECTED counter clear, the FAULT latch, and the 8-byte session record CRC'd
    with crcb and sent on entering FAULT or IDLE-from-session. Outputs are written
    before the record goes out.
    No stack exists (sp is never initialised, DMEM is 32 bytes), so all state is
    in registers and each subroutine saves ra in a register of i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
2026-09-28 feat(firmware): meter frames, grid hold, CRC bench; emulator package
    Tasks 6-8 of the Stage 3 application plan:
    Firmware (main.s, 264 words): chained-CRC frame validation via crcb,
    V*I energy metering via mul, over-current and CRC-lost faults,
    grid-hold with CRC-hashed restart delay (HOLD_BASE + crc16(ID) & 7).
    Emulator package: README.md answers the organiser's 6-question protocol
    checklist, run_scenarios.sh plays all 12 ./emu commands on the FPGA.
    Evidence:
    - Rebound simulation (P2): 1000x7kW fleet, 7.94x peak reduction
    - CRC cycle bench (P3, FIRMWARE 6): crcb=60 cycles vs software=1276
    cycles, 21x speedup, both produce 0xCC77
    Full regression: 45/45 app sims (15 scenarios x 3 tops),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
2026-09-28 docs(figures): fleet rebound figure (P2 evidence)
    Generated by chip-inventor/testbench/app/evidence/rebound_sim.py:
    1000 x 7 kW chargers, synchronised peak 7.000 MW vs CRC-staggered
    0.882 MW (7.94x reduction). For the Stage 3 report.
2026-09-28 docs(video): Stage 3 video storyboard and script
    18 slides, 7:35, in the guide's strict order (1 Technical, 2 Application
    Logic, 3 Pitch), recorded in Canva. Per slide: on-screen content, narration
    sized to its time slot, a "so what" selling line, and the file or run that
    produces each visual. Includes the rubric map (guide 1-7), assets list,
    number sources, delivery notes and facts to confirm before recording.
2026-09-28 docs(video): GPIO & UART integration slide and figures
    Slide 4 now covers the Stage 3 hardware the guide asks for (sec. 2 and
    the GPIO/UART block guide): memory-mapped peripherals, GPIO pin cells
    with the tri-state moved to the pad, UART timing and synchroniser, and
    registered reads that fit the Stage 2 load timing. Slide 8 uses a new
    flow figure showing how every ./emu option enters or leaves through GPIO
    or UART, which is the guide's emulator-to-processor connection logic.
    make_figures.py draws three 1920x1080 figures (integration, process
    flow, pin cell guide-vs-ours) in dark and light themes, as SVG plus 2x
    PNG via headless Edge. Names and addresses come from chip-inventor/rtl.
    Running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
2026-09-28 docs(video): reorder application slides; crcb and impact slides
    Application chapter now builds step by step: slide 8 defines the
    application (Context/Input/Processing/Output plus the state strip),
    slide 9 shows the connection logic (./emu <-> RISC-V flow figure,
    steps 1-10), slide 10 walks one real S1 command through those steps.
    Slide 4's figure ends at a plain "outside world" so the emulator first
    appears on slide 9.
    Slide 6: cycle chart, plain-language CHECK/CHAIN/TIME cards, anatomy
    strip, and the line "Every RVBL-2 chip has a CRC instruction. We
    turned ours into grid protection." README notes what 21x measures.
    Slide 14: chip row now says every team has crcb; ours does three jobs.
    Slid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
2026-09-28 docs(video): slide 14 as a comparison matrix
    Four ways chargers restart today (at once, fixed delay, random delay,
    network scheduled) against ours, on four criteria: spreads the surge,
    works with no network, no random source, re-checkable afterwards.
    Only ours ticks every box. The README notes why there is no billing
    row and that random delay spreads the surge as well as ours; the UK
    example is no longer in the script.
2026-09-28 docs(video): slide 14 compares product types, six criteria
    Columns are now product types on the market (basic wallbox, timer
    charger, smart charger with random delay, networked/OCPP charger) plus
    ours, with a "how it restarts" row and six criteria: spreads the surge,
    senses grid trouble itself, protects the grid with the network down, no
    random source, re-checkable afterwards, extra parts needed. The slide
    footnote says marks are typical behaviour; no brands are named.
2026-09-29 Replace Stage 2 testbench with official Stage 3 firmware validation
    testbench.v now runs the organiser's official GPIO/UART test firmware
    (FIRMWARE 4) instead of the Stage 2 self-check, and testbench/organiser/
    is merged into the top-level testbench/run_tests.py. Update gpio/uart/
    system run_tests.py to accept the new PASS string. Remove hdl_ref.v and
    all references to it (down to hdl.v + rtl/top.v as the two tops), move
    gen_imem.py from canvas_blocks/ into testbench/, drop stale results/final/
    synthesis artifacts and unused convertion/new_export/ output, and clean
    sim/ of duplicate and stale scratch runs. README updated throughout to
    match.
2026-10-07 docs: add EV charger visualization design spec and agent task plan
    Design spec covers hybrid Station+Grid view with React/R3F/Tailwind/Recharts.
    Six-phase agent plan with exact prompts for sequential Sonnet execution.
    Reference clone (rvbl2 stage3) added to gitignore.
2026-10-07 Modify: deleted stage 2, store locally
2026-10-07 docs: update viz plan v2 with design system, parallel execution, verifier
    - Integrated UI/UX Pro Max design system (glassmorphism, dark theme, Fira fonts)
    - Added design system context block for every agent prompt
    - Defined parallel execution strategy (Phases 2/3/5 run simultaneously)
    - Added comprehensive verifier agent prompt (25 checks)
    - Persisted MASTER.md to ChampionCHIP-Stage3/viz/design-system/
2026-10-07 feat: add EV charger visualization frontend at chip-inventor/frontend
    React + TypeScript + Vite + Tailwind + React Three Fiber + Recharts
    visualization for the RVBL-2 grid-aware EV charging controller. Moved
    from the ChampionCHIP-Stage3 standalone repo so it lives alongside the
    golden-model source it was ported from (chip-inventor/testbench/app/).
    - Data layer ported byte-exact from golden.py/scenarios.py/
    rebound_sim.py; CRC-16 golden vector and all 12 scenarios verified
    against the real Python output.
    - Station View: 3D charging scene (R3F), scenario playback, state
    diagram, meter chart, pin LEDs, energy gauge, CRC chain evidence
    viz with click-to-corrupt, frame inspector, session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
2026-10-07 Add meter watchdog and resilient UART frame recovery
2026-10-09 Add without/with RVBL-2 comparison to fleet view and trim copy
    The fleet page now plays the same 1,000-charger grid dip twice: first with
    a fixed restart delay (every charger reconnects in one frame, 7.00 MW step,
    grid alarm again), then with RVBL-2's CRC-hashed delay (8 waves, 0.88 MW
    peak). Autoplay alternates the two; a toggle picks one. A new comparison
    card draws both restart profiles on one MW scale and states the trade-off
    (full load back by frame 9 instead of 2). Replaces ReboundChart.
    Shortens headline, stat labels, captions, and explainer text on the fleet
    page, plus evidence notes and the readings legend on the station page.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
2026-10-09 Unify station and fleet players as chapter timelines
    Add a shared TimelineTrack (chapter labels, per-state fill, scrub/drag,
    hover tooltip) and PlayerButton. The station playback bar and the new fleet
    player bar both use it, so the two pages share one video-style control.
    Fleet: drop the pill row, play button and mode toggle above the city; the
    phases become chapters on a player bar inside the city card, the current
    chapter filling on the phase clock, with the Without/With RVBL-2 toggle on
    the bar. Space and arrow keys step phases.
    Also widen the page past the 1440px cap and include the scene components
    (SceneBackdrop, CitySky, FleetHandoff, EmuPanel) the views import.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
